lab11/powerblade/images/powerblade_front_799x800.jpg

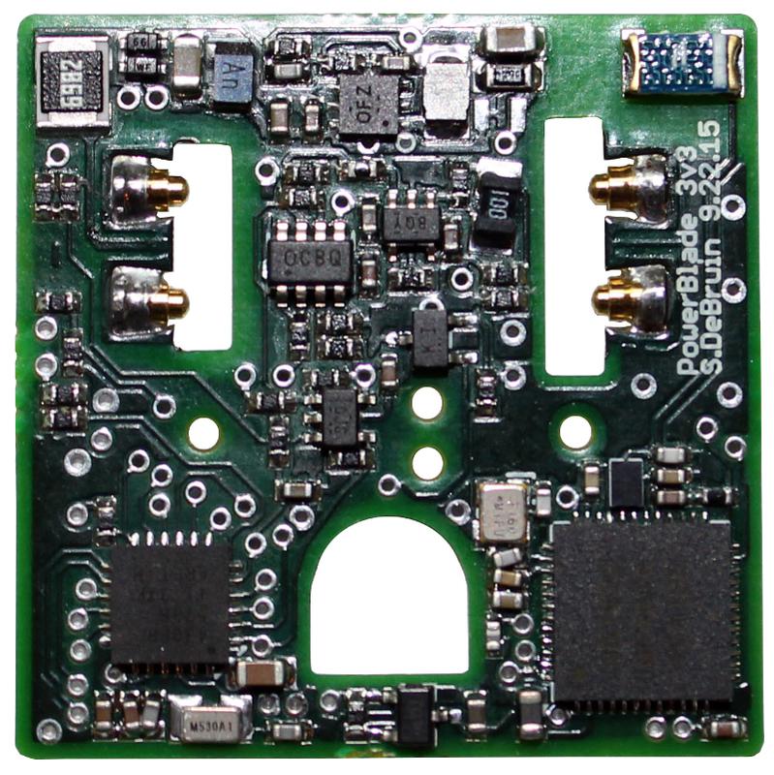
images/powerblade_front_799x800.jpg
