lab11/powerblade/images/powerblade.png

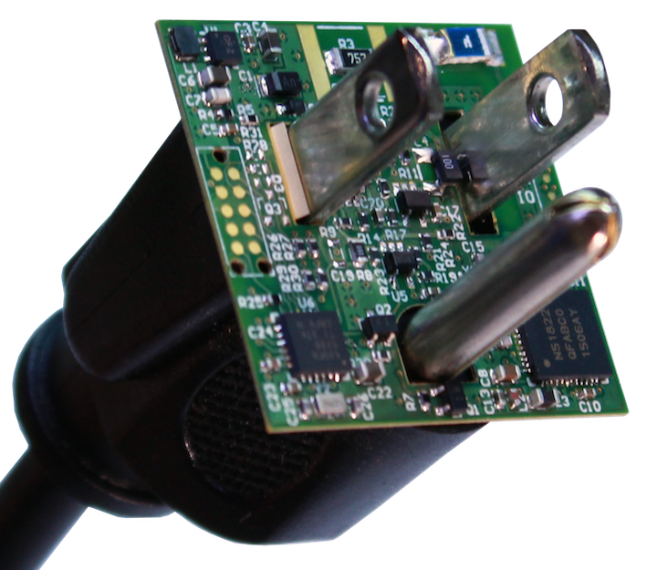
images/powerblade.png
