lab11/powerblade/software/ble/README.md

# BLE Data Gathering
Gathers data from a powerblade over advertisements

```
sudo node powerblade_data.js
```
