lab11/powerblade/software/gateway/push_to_gatd/README.md

Pulls data from a deployed GATD and pushes it to GATD

Requires a configuration script from shed:
    `ln -s shed/projects/powerblade/<deployment name>/config.js .`
