lab11/powerblade/software/android/PowerBlade/README.md

PowerBlade Android App
===================

Low profile true power metering.
View data broadcasted from PowerBlade power meters nearby.

 


Google Play (https://play.google.com/store/apps/details?id=edu.umich.eecs.lab11.powerblade)
