lab11/powerblade/software/nrf51822/apps/powerblade/README.md

PowerBlade BLE App
==================

Install
-------

    make flash ID=c0:98:e5:70:00:xx
