lab11/powerblade/docs/powerblade_specs/msp_versions.md

PowerBlade MSP430 Versions
==========================

In PowerBlade, the nRF51822 can query software version from the MSP430. This is seperate from the powerblade_id transmitted 
with each packet, which only increments if the over-the-wire protocol has changed. The MSP430 software version reflects the
particular state of the MSP430 code when it was installed on the node, and increments whenever a change has been made that 
affects functionality. Therefore incrementing powerblade_id (in response to a protocol change) will also cause a change in MSP430 
version, but a change in MSP430 version will not necessarily require a change in powerblade_id. 

For example, the MSP430 version could reflect whether the node is running a 8-bit or 10-bit analog to digital converter, or whether
the WDT (watchdog timer) is enabled. 

Finally, the minor version is used for identifying updates to the code that do not reprenent version updates, and is not 
transmitted in the advertisement nor sent when the nRF queries version number from the MSP430. Instead, the repo is tagged with
'PB_ID.Version.Minor version' and a corresponding hex file is saved in the [msp_images folder](https://github.com/lab11/powerblade/tree/master/software/msp_images). This feature was added during 2.2. 

## MSP Version List

| PB_ID 	| Version	| Minor Version 	| Notes		|
|:---|:---|:---|:---|
| Multiple 	| 0  		| 0					| This is the default, the first MSP430 code that responds to the version request will respond '1' |
| 2 		| 1			| 0 				| 10 bit ADC, watchdog timer enabled |
| 2 		| 2			| 0 				| Local calibration, SET SEQ (0x1C) and RST WH (0x1D) no longer valid |
| 2			| 2			| 1 				| Lowest four bits of flags now contains MSP Version |
| 2			| 3			| 0 				| Watt Hours now being stored in non-volatile |
