lab11/powerblade/docs/powerblade_specs/uart_protocol.md

PowerBlade UART Protocol
========================

UART is used for communication between the MSP430 and nRF51822 chips used on PowerBlade. The MSP430 controls power to subsystems, samples voltage and current waveforms, and sends power data to the nRF. The nRF controls BLE communication including advertisements and services. Control from users is sent from the nRF back to the MSP430.

## MSP to nRF Packet Specification

Packets are sent from the MSP430 to the nRF at 1 Hz. Each packet includes updated advertisement data, and may optionally include additional data, such as updates to BLE service values.

### Packet Format

| **Field** | Total Length | Adv Length | Adv Data | Additional Data (optional) | Checksum| 
|:---:|:---:|:-:|:---:|:---:|:---:|
| **Number of Bytes** | 2 | 1 | `Adv Length` | ... | 1 |
| **Byte Index** | 0-1 | 2 | 3-21+ | ... | Last Byte |

 * **Total Length**: Length of the entire UART transmission, including itself
 * **Adv Length**: Length of advertisement data field, does not include itself
 * **Adv Data**: Advertisement data. This can range from 0 to 24 bytes
 * **Additional Data**: Additional data to send to nRF. Structure defined below
 * **Checksum**: Checksum over entire packet, additive 1s complement checksum

More information on `Adv Data` format can be found in the [BLE Advertisement Protocol Specification](ble_advertisement.md). The checksum implmentation can be found in [checksum.c](https://github.com/lab11/powerblade/blob/master/software/common/source/checksum.c).

#### Example Packet

Example UART packet with advertisement data but no additional data. Advertisement fields are noted following the example from the [BLE Advertisement Protocol Specification](ble_advertisement.md).

| **Field** | Total Length | Adv Length |
|:---:|:---:|:---:|
| **Value** | 0x0017 | 0x13 |

| Version | Sequence | P_scale | V_scale | WH_scale | V_RMS | Real Power |
|:---:|:---:|:---:|:---:|:---:|:-----:|:---:|
| 0x01 | 0x00000001 | 0x424A  | 0x7B | 0x09 | 0x31  | 0x0802 |

| Apparent Power | Energy Use | Flags | Checksum |
|:---:|:---:|:-----:|:---:|
| 0x0A1A | 0x0000010D | 0x00  | 0x55 |

#### Additional Data

The additional data field can be used to transfer non-advertisement data to the nRF. This can include additional fine-grained power data or information on the device's current state. The total length of additional data can be up to 505 bytes.

| **Field** | Add Data Type | Add Data Values |
|:---:|:---:|:---:|
| **Number of Bytes** | 1 | `Add Data Length` |
| **Byte Index** | 0 | 1- |

 * **Add Data Type**: Type of data. Informs nRF how to interpret the data. See below
 * **Add Data Values**: Data elements. Length and interpretation depend on `Add Data Type`

Each additional data field has only a single `Add Data Type`. If the MSP430 has multiple items to be sent to the nRF, they should be sent in separate transmissions.

##### Additional Data Types

| Value | Name |
|:---|:-----|
| 0x20  | Sample Data Starting |
| 0x21  | Sample Data Values |
| 0x22	| Send Data Done |
| 0x23  | Local Calibration Starting |
| 0x24  | Local Calibration Ongoing |
| 0x25  | Local Calibration Done | 

 * **Sample Data Starting**: MSP430 is collecting raw samples
 * **Sample Data Values**: Data values are raw samples from MSP430
 * **Sample Data Done**: All raw samples have been collected
 * **Local Calibration Starting**: MSP430 is beginning local calibration
 * **Local Calibration Ongoing**: Local calibration is in process, has not failed or finished
 * **Local Calibration Done**: Calibration process is done/settled

## nRF to MSP Packet Specification

Packets are sent from the nRF to the MSP430 asynchronously based on interactions with the user over BLE, only one nRF to MSP430 packet may be sent per second. Packets include information such as changes to device state (e.g. enter calibration mode) or parameter changes to the device.

### Packet Format

| **Field** | Total Length | Data Type | Data Values | Checksum  | 
|:---:|:---:|:---:|:---:|:---:|
| **Number of Bytes** | 2 | 1 | `Data Length` | 1 |
| **Byte Index** | 0-1 | 2 | 3- | Last Byte |

 * **Total Length**: Length of packet, including itself
 * **Data Type**: Type of data. Informs MSP430 how to interpret the data. See below
 * **Data Values**: Data elements. Length and interpretation depend on `Data Type`
 * **Checksum**: Checksum over entire packet, additive 1s complement checksum

Each packet has only a single `Data Type`. If the nRF has multiple items to be sent to the MSP430, they should be sent in separate transmissions.

##### Additional Data Types

| Value | Name |
|:---|:-----|
| 0x10  | Get Configuration |
| 0x11  | Set Configuration |
| 0x12	| Get software version |
| 0x1C	| Set Sequence DEPRECATED |
| 0x1D	| Set WH to zero (reset accumulator) DEPRECATED |
| 0x20  | Start Sample Data Download |
| 0x21	| Continue Sample Data Download |
| 0x22  | Stop Sample Data Download |
| 0x23  | Start Local Calibration |
| 0x24  | Continue Local Calibration |
| 0x25  | Stop Local Calibration | 
| 0xFF	| NAK (Checksum failed) |

 * **Get Configuration**: Get the current values of PowerBlade configuration values: Voff, Ioff, PScale, VScale, and WHScale
 * **Set Configuration**: Set the current values of PowerBlade configuration values: Voff, Ioff, PScale, VScale, and WHScale
 * **Get software version**: Get the version of the software running on the MSP430. Response payload will be a single byte
 * **Set Sequence**: As of MSP v2 this command is no longer valid, MSP430 will respond NAK (0xFF)
 * **Set WH to zero**: As of MSP v2 this command is no longer valid, MSP430 will respond NAK (0xFF) 
 * **Start Sample Data Download**: Get individual samples from one second of power sampling
 * **Continue Sample Data Download**: Get next set of raw samples from MSP430
 * **Stop Sample Data Download**: Stop collecting and transmitting raw samples
 * **Start Local Calibration**: Start local calibration procedure at known wattage, voltage. These values are transmitted after the type (0x23) as two 16-bit numbers representing 10x the intended value (see example below). 
 * **Continue Local Calibration**: Calibration load still active, "Done" (0x25) not yet received
 * **Stop Local Calibration**: Cancel local calibration process. Old calibration values are maintained. 
 * **NAK**: nRF indicating checksum of previous message failed

#### Example Packet

Example UART packet with a `Start Local Calibration` type, a wattage value of 200.1 W, and voltage of 118.8 V. 

| **Field** | Total Length | Data Type | Wattage | Voltage | Checksum |
|:---:|:---:|:---:|:---:|:---:|:---:|
| **Value** | 0x0008 | 0x23 | 0x07D1  | 0x04A4  | ??? |
