lab11/powerblade/sql/plot/random/loc0_light.pdf

0

200

400

600

800

1000 1017165155416848
Average Daily
Energy (Wh)
BLEES/Ligeiro
PowerBlade

1

10

100

1000

Dining Room

Remote charger

Bathroom night light
Monitor

Bedroom standing lamp
Other Closet

Bedroom bedside lamp
Bedroom TV

Bedroom iPhone charger
Monitor

Speakers

Curling Iron
NUC

Master Closet

Curling Iron #2
Microwave

Master android charger

Master bedroom ethernet switch
Energy bridge

Bedroom 2 ethernet switch
Desk lamp

Bedroom 2 gateway
Master Bathroom
Apple TV

USB hub
Toaster

Bedroom 2 bedside
Living room dell
Master gateway

Living room laptop charger

Living room macbook charger
Couch surge strip

Living room gateway
Living room lamp #1

Living room lamp #2

Master bedroom vacuum charger Bedside lamp
Keurig

Laptop dock

Dining Room

Shredder

Macbook charger

Living room ethernet switch Bedroom 2 UPS
Front Stairs
Kitchen

Other Bathroom
Fridge

Bedroom box fan
AT Modem

Bedroom 2 lamp

Ethernet bridge
Xbox One

Aero Garden
Samsung TV
Printer

AT Cable Box

Amp Speakers

Average Active
Power (w)
