lab11/powerblade/sql/plot/random/loc0.pdf

0

200

400

600

800

1000 1040 1770 5940 6020
Average Daily
Energy (Wh)
PowerBlade

1

10

100

1000

Remote charger

Bathroom night light
Monitor

Food processor

Bedroom bedside lamp
Monitor

Bedroom TV

Bedroom iPhone charger
Speakers

Bedroom standing lamp
Curling Iron #2

Master android charger
Microwave

Curling Iron
Toaster

Master bedroom ethernet switch Energy bridge
Apple TV

Desk lamp

Bedroom 2 ethernet switch
Bedroom 2 gateway

Couch surge strip

Living room macbook charger
NUC

Bedroom 2 bedside
USB hub

Living room laptop charger
Master gateway

Living room dell

Living room gateway
Living room lamp #1

Living room lamp #2
Keurig

Master bedroom vacuum charger Bedside lamp
Laptop dock

Shredder

Macbook charger
Bedroom box fan

Living room ethernet switch Bedroom 2 UPS
Fridge

Xbox One
AT Modem

Bedroom 2 lamp

Ethernet bridge
Samsung TV

Aero Garden
Printer

AT Cable Box

Amp Speakers

Average Active
Power (w)
