lab11/powerblade/sql/plot/random/loc3.pdf

0

200

400

600

800

1000 1523
Average Daily
Energy (Wh)
PowerBlade

1

10

100

1000

Shaver

Bedroom Lamp
Gold Lamp

Speaker Charger

Bedroom Phone Charger
Wiimote Charger
Toaster

Audio Conversion Cable
Chromecast
Nintendo Wii

Microwave

Swarm Gateway
Speakers

Macbook Charger
Modem

Television

Rice Cooker
Router
Tall Lamp
Fridge

Average Active
Power (w)
