lab11/powerblade/sql/plot/random/loc5.pdf

0

200

400

600

800

1000 1501
Average Daily
Energy (Wh)
PowerBlade

1

10

100

1000

Disposal

Apple TV

Blu Ray Player
Lamp

Desk lamp
Swash

Long board charger
Piano

Toaster

KitchenAid Mixer
Straightener

Bendes phone charger
Vacuum charger
Hair Dryer
Subwoofer

Alexa (dot downstairs)
Remote Control
Printer

Couch Outlet

Alexa (dot)

Alexa (main)
Sonos
Stove

Bendes computer charger
DAC

Ultrasonic humidifier
Microwave
Turn Table
Modem

Air Filter
Receiver

Surge (swash modem 2 phone chargers) Router and other stuff
Box fan
Fridge

Average Active
Power (w)
