lab11/powerblade/sql/plot/random/loc5_20.pdf

0

200

400

600

800

1000 | 1034 | 1484
Average Daily
Energy (Wh)
PowerBlade

1

10

100

1000

Disposal

Desk lamp
Swash
Lamp

Apple TV

Long board charger
Blu Ray Player
Piano

KitchenAid Mixer
Straightener

Hair Dryer
Toaster

Subwoofer

Vacuum charger

Bendes phone charger

Alexa (dot downstairs)
Couch Outlet
Stove

Printer

Alexa (dot)

Alexa (main)

Bendes computer charger
Remote Control
Sonos

Ultrasonic humidifier
Air Filter
Microwave
Modem

DAC

Turn Table

Surge (swash modem 2 phone chargers) Router and other stuff
Box fan

Receiver
Fridge

Average Active
Power (w)
