lab11/powerblade/sql/plot/random/loc6.pdf

0

200

400

600

800

1000 | 1281 | 6976
Average Daily
Energy (Wh)
PowerBlade

1

10

100

1000

Kegerator
KitchenAid
Apple TV

Adrienne’s bedside lamp

Adrienne’s phone charger
Tom’s bedside lamp

DVD Player

Living room lamp 2

Hair straightener
Curning iron
Diffuser

Living room lamp 1

Cell phone charger
Echo dot

Clothes Washer
Microwave
Toaster

Big Blue Speaker
Dishwasher
Tom’s laptop
Vacuum
Box fan
Wii

Keurig
Stove

Tom’s phone charger
Television

Router Modem

Misc Kitchen (incl toaster)
Alarm clock
Comcast box

Adrienne’s Computer
Fridge

Porch lights

Average Active
Power (w)
