lab11/powerblade/sql/plot/random/loc7.pdf

0

200

400

600

800

1000 1026
Average Daily
Energy (Wh)
PowerBlade

1

10

100

1000

Disposal

Standing lamp

Living room table lamp
Desk lamp

Living Room Wii U
Curler
Blender

Living room standing lamp
Sony DVD player
Bedroom 2 LEDs
Hair dryer
Bedside lamp

Kitchen clock
VCR
Wii

Reading light
Gateway
Toaster

Office surge

Bedroom office
Modem

Garage door opener
Electric blanket
Washer in office
Router
Stereo

Microwave
Fridge

Television

Average Active
Power (w)
