lab11/powerblade/sql/plot/random/loc1.pdf

0

200

400

600

800

1000 1077 1200 1606 1675
Energy Use (Wh)
PowerBlade

1

10

100

1000

Quiet Rm Desk #1 left power

Quiet Rm Desk #2 right power
Workroom Bench lights

Basement Downstairs Ethernet switch Quiet Rm Desk #1 monitor
Quiet Rm Desk #1 desk

Quiet Rm Desk #1 right power
Quiet Rm Desk #2 desk

Quiet Rm Desk #2 monitor
Floating

Quiet Rm Ethernet switch
Basement SD tower
Kitchen Toaster oven
Basement Router

Conference room Air purifier
Floating

Basement Sec. system monitor
Basement Gateway

Basement Tech server monitor
Workroom Sterilizer

Hallway Lobby chromecast
Hallway Desk #4 other
Hallway Lobby speaker

Hallway Router gateway

Collab Rm Table strip south
Kitchen Microwave

Collab Rm Table Strip North

Basement Upstairs Ethernet switch
Conference room Surge strip #1
Collab Rm Television

Basement Western Digital Tower Basement POE module
Collab Rm Cable box

Hallway Big router

Hallway Lobby television
Basement Comcast modem

Conference room Floor strip
Basement Security system
Basement 3D printer #1
Kitchen Fridge

Basement Mysterious grey box
Basement Tech server

Hallway Drink machine

Average Power (w)
