lab11/powerblade/docs/plug_designs/BS1363PlugSpec.png

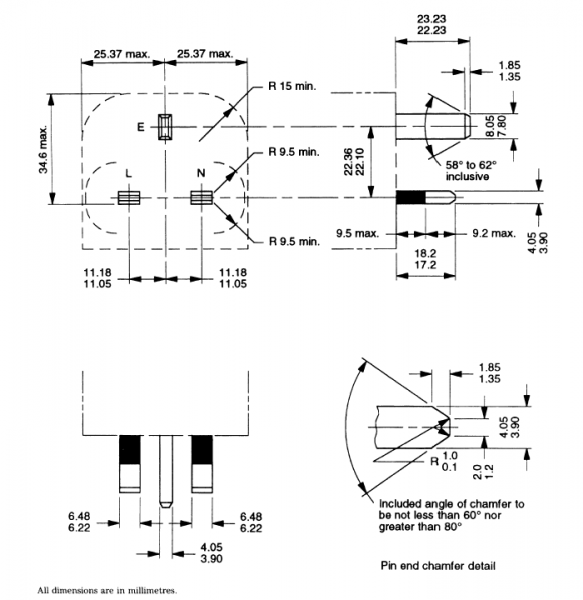
docs/plug_designs/BS1363PlugSpec.png
