lab11/powerblade/images/high_side_supply.PNG

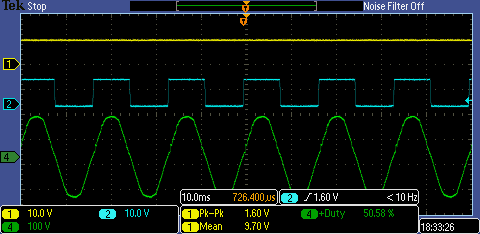
images/high_side_supply.PNG
