lab11/powerblade/images/powerblade_isometric_v5_1000x720.jpg

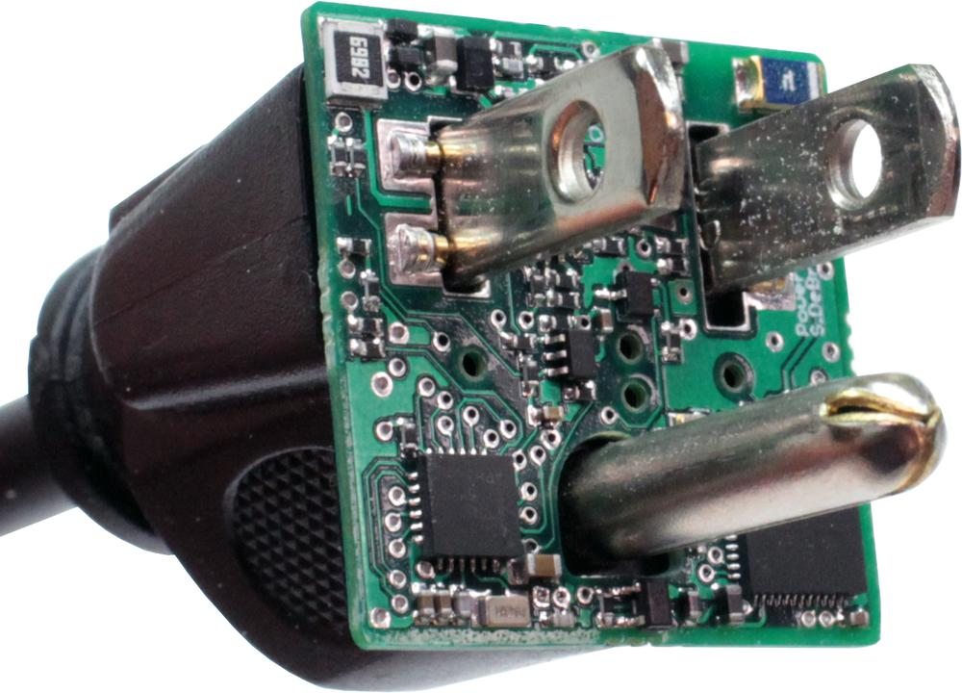
images/powerblade_isometric_v5_1000x720.jpg
