lab11/powerblade/images/powerblade_plug_profile_1000x423.jpg

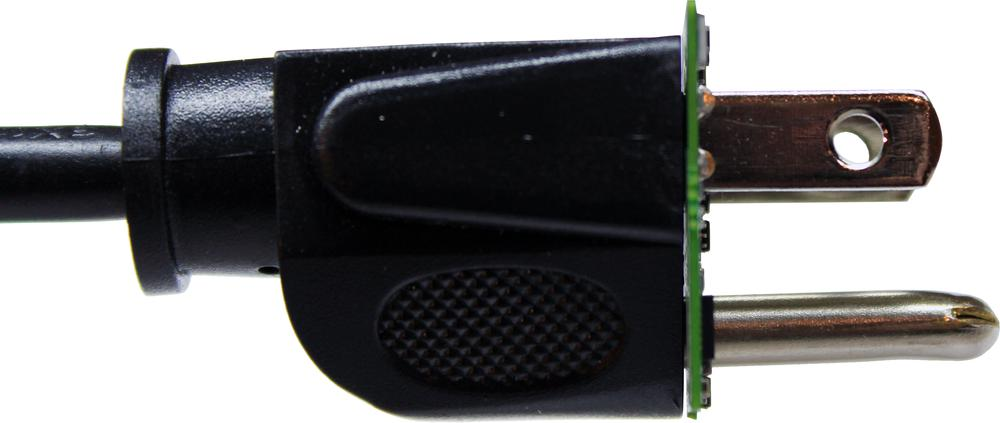
images/powerblade_plug_profile_1000x423.jpg
