lab11/powerblade/images/powerblade_plug_profile_slim_937x1000.jpg

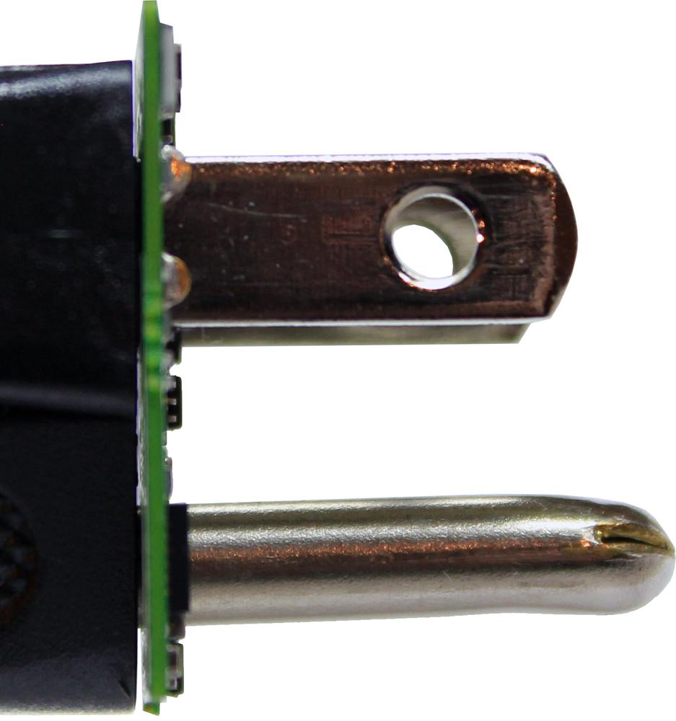
images/powerblade_plug_profile_slim_937x1000.jpg
