lab11/powerblade/other/cad/full_system.PNG

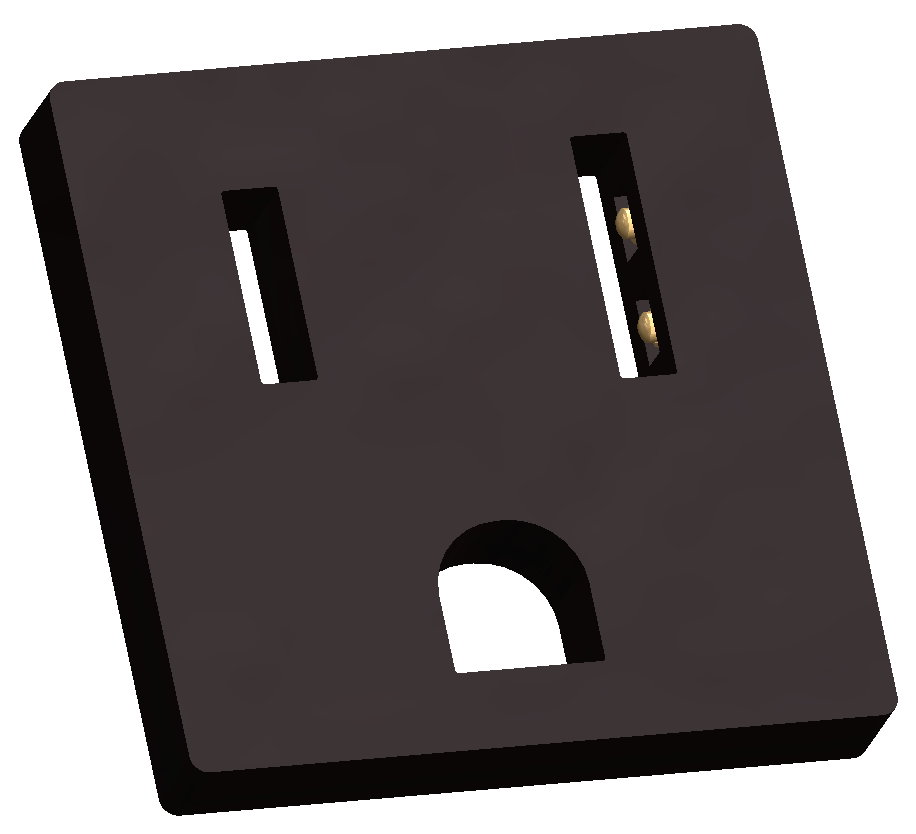
other/cad/full_system.PNG
