lab11/powerblade/eagle/powerblade/powerblade_3v5_bom.xlsx

Qty | 300
Item | Quantity | Part | Value | Device | Package | Description | Distributor | Dist Part # | Type | Alternate
1 | 1 | B1 | BAL-NRF01D3 | BAL-NRF01D3 | BAL-NRF01D3 | 50 ohm nominal input / conjugate match balun to nRF51422-QFAA, | 300 | 497-13637-1-ND | BGA | 497-13637-1-ND
2 | 1 | C1 | 33uF | CPOL-US0805_SM | CPOL0805_SM | POLARIZED CAPACITOR, American symbol | 300 | 478-8650-1-ND | smt | 478-8650-1-ND
3 | 1 | C11 | 4.7uF | C-EUC0402 | C0402 | CAPACITOR, European symbol | 300 | 445-5947-1-ND | smt | 445-5947-1-ND
4 | 2 | C12, C20 | 1nF | CAPACITOR | 0402_CAP | 0402 Capacitor | 600 | 490-1303-1-ND | smt | 490-1303-1-ND
5 | 1 | C15 | 10uF | C-EUC0603_SM | C0603_SM | CAPACITOR, European symbol | 300 | 445-6853-1-ND | smt | 445-6853-1-ND
6 | 1 | C16 | 470nF | C-EUC0402 | C0402 | CAPACITOR, European symbol | 300 | 445-4989-1-ND | smt | 445-13864-1-ND
7 | 1 | C17 | 1uF | CAPACITOR | 0402_CAP | 0402 Capacitor | 300 | 1276-1513-1-ND | smt | 1276-1513-1-ND
8 | 2 | C18, C19 | 12pF | CAPACITOR | 0402_CAP | 0402 Capacitor | 600 | 490-6197-1-ND | smt | 490-6196-1-ND
9 | 1 | C2 | 0.1uF | C-EUC0402 | C0402 | CAPACITOR, European symbol | 300 | 490-10777-1-ND | smt | 490-10777-1-ND
10 | 1 | C21 | 47nF | CAPACITOR | 0402_CAP | 0402 Capacitor | 300 | 445-1264-1-ND | smt | 445-1264-1-ND
11 | 1 | C22 | 2.2nF | CAPACITOR | 0402_CAP | 0402 Capacitor | 300 | 490-5419-1-ND | smt | 490-5419-1-ND
12 | 1 | C23 | 0.8pF | CAPACITOR | 0402_CAP | 0402 Capacitor | 300 | 490-6269-1-ND | smt | 490-6269-1-ND
13 | 2 | C3, C10 | 22uF | C-EUC0603_SM | C0603_SM | CAPACITOR, European symbol | 600 | 445-9077-1-ND | smt | 445-9077-1-ND
14 | 1 | C39 | 1.5uF | C-EUC0402 | C0402 | CAPACITOR, European symbol | 300 | 445-13815-1-ND | smt | 445-13815-1-ND
15 | 1 | C4 | 22pF | C-EUC0402 | C0402 | CAPACITOR, European symbol | 300 | 445-1239-1-ND | smt | 445-1239-1-ND
16 | 1 | C5 | NP | C-EUC0603_TN | C0603_TN | CAPACITOR, European symbol | 300 | NP | DNS | NP
17 | 2 | C6, C34 | 8pF | C-EUC0402 | C0402 | CAPACITOR, European symbol | 600 | 445-4890-1-ND | smt | 445-4890-1-ND
18 | 1 | C7 | 4.7uF | C-EUC0402 | C0402 | CAPACITOR, European symbol | 300 | 445-8023-1-ND | smt | 445-13820-1-ND
19 | 7 | C8, C9, C13, C14, C24, C27, C38 | 0.1uF | C-EUC0402 | C0402 | CAPACITOR, European symbol | 2100 | 445-4952-1-ND | smt | 445-4952-1-ND
20 | 1 | D1 | ZENERBZT52 | ZENERBZT52 | BZT52 |  | 300 | BZT52C10T-7DICT-ND | smt | BZT52C10T-7DICT-ND
21 | 1 | D2 | DIODE | DIODE | BAS521 |  | 300 | BAS521-7DICT-ND | smt | BAS521-7DICT-ND
22 | 1 | J1 | JTAG_14PIN_IDC-ND | JTAG_14PIN_IDC-ND | TC2050-IDC-NL-430-ND |  | 300 | NP | DNS | NP
23 | 1 | J4 | TC2030-JLINK-NL | TC2030-JLINK-NL | TC2030-IDC-NL |  | 300 | NP | DNS | NP
24 | 1 | L1 | 10uH | L-USL0805 | L0805 | INDUCTOR, American symbol | 300 | 490-4990-1-ND | smt | 490-4990-1-ND
25 | 1 | L2 | 15nH | INDUCTOR0402 | 0402_CAP |  | 300 | 587-1521-1-ND | smt | 587-1521-1-ND
26 | 1 | L3 |  | L-USL0805 | L0805 | INDUCTOR, American symbol | 300 | 732-3452-1-ND | smt | 732-3452-1-ND
27 | 1 | L4 | 10uH | L-USL0603_TN | C0603_TN | INDUCTOR, American symbol | 300 | 490-4025-1-ND | smt | 535-12249-1-ND
28 | 1 | Q1 | NTS4173 | NTS4173 | SC-70-3 |  | 300 | NTS4173PT1GOSCT-ND | smt | NTS4173PT1GOSCT-ND
29 | 1 | Q4 | 2SK1829 | 2SK1829 | SC-70-3 |  | 300 | 2SK1829TE85LFCT-ND | smt | 2SK1829TE85LFCT-ND
30 | 2 | R12, R13 | 330k | R-US_R0402 | R0402 | RESISTOR, American symbol | 600 | P330KLCT-ND | smt | P330KLCT-ND
31 | 1 | R14 | 200 | R-US_R0402 | R0402 | RESISTOR, American symbol | 300 | P200LCT-ND | smt | P200LCT-ND
32 | 4 | R15, R20, R21, R40 | 1M 1% | R-US_R0402 | R0402 | RESISTOR, American symbol | 1200 | P1.00MLCT-ND | smt | P1.00MLCT-ND
33 | 1 | R16 | 75 1% | R-US_R0402 | R0402 | RESISTOR, American symbol | 300 | P75.0LCT-ND | smt | P75.0LCT-ND
34 | 1 | R17 | 1k 1% | R-US_R0402 | R0402 | RESISTOR, American symbol | 300 | P1.00KLCT-ND | smt | P1.00KLCT-ND
35 | 1 | R18 | 4.99 1% | R-US_R0402 | R0402 | RESISTOR, American symbol | 300 | RMCF0402FT4R99CT-ND | smt | RMCF0402FT4R99CT-ND
36 | 1 | R19 | 47k | R-US_R0402 | R0402 | RESISTOR, American symbol | 300 | P47KJCT-ND | smt | P47KJCT-ND
37 | 1 | R2 | 3k | R-US_R0402_SM | R0402_SM | RESISTOR, American symbol | 300 | P3.00KLCT-ND | smt | P3.00KLCT-ND
38 | 1 | R24 | 1 1% | R-US_R0603_SM | R0603_SM | RESISTOR, American symbol | 300 | P1.0AJCT-ND | smt | P1.0AJCT-ND
39 | 1 | R3 | 69.8k | R-US_R1210 | R1210 | RESISTOR, American symbol | 300 | P69.8KAACT-ND | smt | P69.8KAACT-ND
40 | 1 | R35 | 20k | R-US_R0402 | R0402 | RESISTOR, American symbol | 300 | P20.0KLCT-ND | smt | P20.0KLCT-ND
41 | 1 | R37 | 887k 1% | R-US_R0402 | R0402 | RESISTOR, American symbol | 300 | P887KLCT-ND | smt | P887KLCT-ND
42 | 1 | R38 | 30k 1% | R-US_R0402 | R0402 | RESISTOR, American symbol | 300 | P30.0KLCT-ND | smt | P30.0KLCT-ND
43 | 1 | R39 | 16k 1% | R-US_R0402 | R0402 | RESISTOR, American symbol | 300 | P16.0KLCT-ND | smt | P16.0KLCT-ND
44 | 1 | R4 | 12k | RESISTOR | 0402_RES | Resistor | 300 | RHM12.0KCDCT-ND | smt | RHM12.0KCDCT-ND
45 | 3 | R6, R11, R22 | 665k | R-US_R0402 | R0402 | RESISTOR, American symbol | 900 | P665KLCT-ND | smt | P665KLCT-ND
46 | 1 | R7 | 560k | R-US_R0402 | R0402 | RESISTOR, American symbol | 300 | P560KLCT-ND | smt | P560KLCT-ND
47 | 1 | R8 | 220k | R-US_R0402_SM | R0402_SM | RESISTOR, American symbol | 300 | P220KJCT-ND | smt | P220KJCT-ND
48 | 1 | R9 | 180k | R-US_R0402 | R0402 | RESISTOR, American symbol | 300 | P180KLCT-ND | smt | P180KLCT-ND
49 | 1 | RF | 4.99k 1% | R-US_R0402 | R0402 | RESISTOR, American symbol | 300 | P4.99KLCT-ND | smt | P4.99KLCT-ND
50 | 2 | RI1, RI2 | 953k 1% | R-US_R0402 | R0402 | RESISTOR, American symbol | 600 | P953KLCT-ND | smt | P953KLCT-ND
51 | 1 | U1 | TPS62122 | TPS62122 | WDFN-6 |  | 300 | 296-27695-1-ND | fine pitch | 296-27695-1-ND
52 | 1 | U2 | OPA333 | OPA333 | SC70-5 |  | 300 | 296-19547-1-ND | smt | 296-19547-1-ND
53 | 1 | U3 | MSP430FR5738 | MSP430FR5738 | VQFN-24 |  | 300 | 296-29232-1-ND | fine pitch | 296-29232-1-ND
54 | 1 | U4 | NRF51822QF | NRF51822QF | QFN-48-6MM | Multiprotocol Bluetooth® 4.0 low energy/2.4 GHz RF SoC | 300 | 1490-1032-1-ND | fine pitch | 1490-1032-1-ND
55 | 1 | U6 | MAX9910 | MAX9910 | SC70-5 |  | 300 | 296-25252-1-ND | smt | 296-25252-1-ND
56 | 1 | U7 | OPA2369 | OPA2369 | SOT-23-8 |  | 300 | 296-22671-1-ND | smt | 296-22671-1-ND
57 | 1 | X1 | 16MHz | TXC-8Y | TXC-8Y | 2mmx1.6mm SMD Crystal | 300 | 887-2003-1-ND | smt | 887-2003-1-ND
58 | 1 | X3 | 32.768kHz | CRYSTAL_0805 | 805 |  | 300 | 535-12373-1-ND | smt | 535-12373-1-ND
59 | 1 | Y1 | UREACH_XTEND | UREACH_XTEND | UREACH_XTEND |  | 300 | FR05-S1-N-0-110 | smt | FR05-S1-N-0-110
60 | 4 | J2 | Ultra Low Profile Spring Pin | Ultra Low Profile Spring Pin | Ultra Low Profile Spring Pin |  | 1200 | ED1649-ND | smt | ED1649-ND
 |  |  |  |  |  |  | Board Summary for Quote
 |  |  |  |  |  |  | Total Unique Parts | 56
 |  |  |  |  |  |  | SMT placements per board | 69
 |  |  |  |  |  |  | Thru-hole per board | 0
 |  |  |  |  |  |  | Fine pitch per board | 3
 |  |  |  |  |  |  | BGA per board | 1
