lab11/powerblade/eagle/powerblade/past_rev/3v1/SC-BOM.xlsx

PowerBlade Bill of Materials (BOM)
> All the information Screaming Circuits needs in a Bill of Materials to complete an order is in columns B through G.
> Distributor part numbers (ie.. DigiKey Part #'s) are not required for Kitted orders, but are helpful for Turn-Key pricing.
> The BOM is the primary file that Screaming Circuits goes by whenever there is any conflicting information.
> There is information in the far right column that helps to get an assembly quote. Look at the bottom to see a board summary.
> Highlight in RED any Do Not Stuff parts ("DNS") , and they will be excluded from the build. Parts not listed on the BOM are considered DNS.
Item # | Qty | Ref Des | Manufacturer | Mfg Part # | Dist. Part # | Description | Package | Type
1 | 1 | B1 |  |  | 497-13637-1-ND |  |  | bga
2 | 1 | C1 |  |  | 478-8650-1-ND |  |  | smt
4 | 2 | C3, C10 |  |  | 445-9077-1-ND |  |  | smt
5 | 1 | C5 |  |  | 445-9077-1-ND |  |  | DNS
6 | 1 | C4 |  |  | 445-1239-1-ND |  |  | smt
7 | 2 | C6, C34 |  |  | 445-4890-1-ND |  |  | smt
8 | 1 | C7 |  |  | 445-8023-1-ND |  |  | smt
9 | 7 | C8, C9, C13, C14, C24, C27, C38 |  |  | 445-4952-1-ND |  |  | smt
10 | 1 | C11 |  |  | 445-5947-1-ND |  |  | smt
11 | 2 | C12, C20 |  |  | 490-1303-1-ND |  |  | smt
12 | 1 | C15 |  |  | 445-6853-1-ND |  |  | smt
13 | 1 | C16 |  |  | 445-4989-1-ND |  |  | smt
14 | 1 | C17 |  |  | 1276-1513-1-ND |  |  | smt
15 | 2 | C18, C19 |  |  | 490-6197-1-ND |  |  | smt
16 | 1 | C21 |  |  | 445-1264-1-ND |  |  | smt
17 | 1 | C22 |  |  | 490-5419-1-ND |  |  | smt
18 | 1 | C23 |  |  | 490-6269-1-ND |  |  | smt
19 | 1 | C39 |  |  | 445-13815-1-ND |  |  | smt
20 | 1 | D1 |  |  | BZT52C10T-7DICT-ND |  |  | smt
21 | 1 | D2 |  |  | BAS521-7DICT-ND |  |  | smt
22 | 1 | L1 |  |  | 490-4990-1-ND |  |  | smt
23 | 1 | L2 |  |  | 587-1521-1-ND |  |  | smt
24 | 1 | L3 |  |  | 732-3452-1-ND |  |  | smt
25 | 1 | L4 |  |  | 490-4025-1-ND |  |  | smt
26 | 1 | Q1 |  |  | NTS4173PT1GOSCT-ND |  |  | smt
27 | 1 | Q4 |  |  | 2SK1829TE85LFCT-ND |  |  | smt
28 | 1 | R1 |  |  | P0.0JCT-ND |  |  | smt
30 | 1 | R3 |  |  | P69.8KAACT-ND |  |  | smt
32 | 1 | R4 |  |  | RHM12.0KCDCT-ND |  |  | smt
33 | 3 | R6, R11, R22 |  |  | P665KLCT-ND |  |  | smt
34 | 1 | R7 |  |  | P560KLCT-ND |  |  | smt
35 | 1 | R8 |  |  | P220KJCT-ND |  |  | smt
36 | 1 | R9 |  |  | P180KLCT-ND |  |  | smt
37 | 2 | R12, R13 |  |  | P330KLCT-ND |  |  | smt
38 | 1 | R14 |  |  | P200LCT-ND |  |  | smt
39 | 4 | R15, R20, R21, R40 |  |  | P1.00MLCT-ND |  |  | smt
40 | 1 | R16 |  |  | P75.0LCT-ND |  |  | smt
41 | 2 | R17, RF |  |  | P4.99KLCT-ND |  |  | smt
43 | 1 | R18 |  |  | RMCF0402FT4R99CT-ND |  |  | smt
45 | 1 | R19 |  |  | P47KJCT-ND |  |  | smt
46 | 1 | R24 |  |  | P1.0AJCT-ND |  |  | smt
48 | 1 | R35 |  |  | P20.0KLCT-ND |  |  | smt
49 | 1 | R37 |  |  | P887KLCT-ND |  |  | smt
50 | 1 | R38 |  |  | P30.0KLCT-ND |  |  | smt
51 | 1 | R39 |  |  | P16.0KLCT-ND |  |  | smt
52 | 2 | RI1, RI2 |  |  | P953KLCT-ND |  |  | smt
53 | 1 | SV1 |  |  | S9014E-12-ND |  |  | DNS
54 | 1 | U1 |  |  | 296-27695-1-ND |  |  | smt
56 | 1 | U2 |  |  | 296-19547-1-ND |  |  | smt
57 | 1 | U3 |  |  | 296-29232-1-ND |  |  | fine pitch
58 | 1 | U4 |  |  | 1490-1032-1-ND |  |  | fine pitch
59 | 1 | U6 |  |  | MAX9910EXK+TCT-ND |  |  | smt
60 | 1 | U7 |  |  | 296-22671-1-ND |  |  | smt
61 | 1 | X1 |  |  | 887-2003-1-ND |  |  | smt
62 | 1 | X3 |  |  | 535-12373-1-ND |  |  | smt
63 | 1 | Y1 |  |  | FR05-S1-N-0-110 |  |  | smt
 |  |  |  |  |  | BOARD SUMMARY FOR QUOTE
 |  |  |  |  |  | Total # of unique parts | 60
 |  |  |  |  |  | SMT placements per board | 69
 |  |  |  |  |  | Thru-hole placements per board | 0
 |  |  |  |  |  | Fine pitch placements per board | 3
 |  |  |  |  |  | BGA placements per board | 0
