lab11/powerblade/eagle/powerblade/past_rev/3v1/partList.xlsx

Sheet: DIGIKEY
Name | Part Num | Face | Qty | Qty Needed | Qty Avail | 1 | 10 | 25 | 50 | 100 | 250 | 500 | 750 | 1000 | 2500 | Qty to Buy
B1 | 497-13637-1-ND | eagle/powerblade/powerblade_3v1 | 1 | 12 | 98086 | 0.80000 | 0.61900 |  |  | 0.40000 |  |  |  | 0.32000 |  | 12
C1 | 478-8650-1-ND | eagle/powerblade/powerblade_3v1 | 1 | 12 | 9607 | 1.16000 | 0.97000 |  |  | 0.61890 | 0.51576 | 0.46418 |  | 0.42292 |  | 12
C1 | 478-8654-1-ND | eagle/powerblade/powerblade_3v1 | 1 | 12 | 13945 | 1.16000 | 0.97000 |  |  | 0.61890 | 0.51576 | 0.46418 |  | 0.42292 |  | 12
C3, C5, C10 | 445-9077-1-ND | eagle/powerblade/powerblade_3v1 | 3 | 36 | 218179 | 0.50000 | 0.47800 |  |  | 0.23210 | 0.19280 | 0.17494 |  | 0.15750 |  | 36
C4 | 445-1239-1-ND | eagle/powerblade/powerblade_3v1 | 1 | 12 | 203352 | 0.10000 | 0.02400 |  |  | 0.01100 | 0.00900 | 0.00770 |  | 0.00600 |  | 12
C6, C34 | 445-4890-1-ND | eagle/powerblade/powerblade_3v1 | 2 | 24 | 211893 | 0.10000 | 0.02600 |  |  | 0.01210 | 0.00992 | 0.00848 |  | 0.00660 |  | 24
C7 | 445-8023-1-ND | eagle/powerblade/powerblade_3v1 | 1 | 12 | 209639 | 0.41000 | 0.35700 |  |  | 0.17850 | 0.14280 | 0.13006 |  | 0.11500 |  | 12
C8, C9, C13, C14, C24, C27, C38 | 445-4952-1-ND | eagle/powerblade/powerblade_3v1 | 7 | 84 | 3379993 | 0.10000 | 0.02700 |  |  | 0.01230 | 0.01008 | 0.00864 |  | 0.00660 |  | 100 | BACKORDER
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
U2 | 296-19547-1-ND | eagle/powerblade/powerblade_3v1 | 1 | 12 | 11546 | 2.73000 | 2.46000 | 2.13000 | 2.00000 | 1.98000 | 1.76000 | 1.49000 | 1.35000 | 1.06875 |  | 12
U3 | 296-29232-1-ND | eagle/powerblade/powerblade_3v1 | 1 | 12 | 2774 | 3.94000 | 3.52900 | 3.17360 |  | 2.88650 | 2.61288 | 2.33928 | 2.12040 | 1.71000 |  | 12
U4 | 1490-1032-1-ND | eagle/powerblade/powerblade_3v1 | 1 | 12 | 7644 | 4.15000 | 3.73600 | 3.39000 |  | 3.04410 | 2.76740 | 2.42148 |  |  |  | 12
U6 | 296-25252-1-ND | eagle/powerblade/powerblade_3v1 | 1 | 12 | 7385 | 1.87000 | 1.68000 | 1.46000 | 1.37000 | 1.35000 | 1.20000 | 1.02000 | 0.92400 | 0.73125 |  | 12
U7 | 296-22671-1-ND | eagle/powerblade/powerblade_3v1 | 1 | 12 | 797 | 3.02000 | 2.72000 | 2.36000 | 2.22000 | 2.19000 |  |  |  |  |  | 12
X1 | 887-2003-1-ND | eagle/powerblade/powerblade_3v1 | 1 | 12 | 8677 | 1.18000 | 1.13000 |  | 1.10500 | 0.94500 |  | 0.92000 |  | 0.77500 |  | 12
X3 | 535-12373-1-ND | eagle/powerblade/powerblade_3v1 | 1 | 12 | 23253 | 1.10000 | 0.97300 |  | 0.90860 | 0.80400 |  | 0.75978 | 0.71959 | 0.63516 |  | 12

Sheet: FRACTUS
Name | Part Num | Face | Qty | Qty Needed | Qty Avail | Qty to Buy
Y1 | FR05-S1-N-0-110 | eagle/powerblade/powerblade_3v1 | 1 | 12 | 0 | 0

Sheet: MOUSER
Name | Part Num | Face | Qty | Qty Needed | Qty Avail | Qty to Buy
B1 | 511-BAL-NRF01D3 | eagle/powerblade/powerblade_3v1 | 1 | 12 | 0 | 0
U4 | 949-NRF51822-QFAB-R7 | eagle/powerblade/powerblade_3v1 | 1 | 12 | 0 | 0
