lab11/powerblade/eagle/powerblade/past_rev/3v0/partList.xlsx

Sheet: DIGIKEY
Name | Part Num | Face | Qty | Qty Needed | Qty Avail | 1 | 10 | 25 | 50 | 100 | 200 | 250 | 500 | 750 | 1000 | 2500 | Qty to Buy
C1 | 490-5919-1-ND | powerblade_test | 1 | 5 | 6771 | 2.86000 | 2.36800 |  | 2.19360 | 1.98470 |  | 1.63656 |  |  |  |  | 5 | 490-5919-1-ND
C3, C32 | 718-1672-1-ND | powerblade_test | 2 | 10 | 14717 | 2.15000 | 1.78500 |  |  | 1.57500 |  | 1.47000 | 1.31250 |  | 1.05000 |  | 10 | 718-1672-1-ND
C4 | 1276-1116-1-ND | powerblade_test | 1 | 5 | 511491 | 0.10000 | 0.01300 | 0.00920 |  | 0.00590 |  |  | 0.00416 |  | 0.00324 | 0.00292 | 10 | 1276-1116-1-ND
C5, C6, C11, C12, C13, C17, C18, C19, C20, C21 | 490-6324-1-ND | powerblade_test | 10 | 48 | 23371 | 0.10000 | 0.05000 |  | 0.02720 | 0.02300 |  | 0.01880 | 0.01610 |  | 0.01230 |  | 50 | 490-6324-1-ND
C7 | 1276-1784-1-ND | powerblade_test | 1 | 5 | 108875 | 0.26000 | 0.21600 | 0.14840 |  | 0.10800 |  |  | 0.07156 |  | 0.06345 |  | 5 | 1276-1784-1-ND
C8, C34 | 1276-1817-1-ND | powerblade_test | 2 | 10 | 7825 | 0.10000 | 0.04200 | 0.02960 |  | 0.01930 |  |  | 0.01348 |  | 0.01050 |  | 10 | 1276-1817-1-ND
C9 | 1276-1001-1-ND | powerblade_test | 1 | 5 | 3652464 | 0.10000 | 0.01500 | 0.01080 |  | 0.00690 |  |  | 0.00482 |  | 0.00375 | 0.00338 | 10 | 1276-1001-1-ND
C10 | 490-5915-1-ND | powerblade_test | 1 | 5 | 200937 | 0.15000 | 0.10000 |  | 0.05760 | 0.04750 |  | 0.04000 | 0.03350 |  | 0.02750 |  | 5 | 490-5915-1-ND
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
X1 | 535-10293-1-ND | powerblade_test | 1 | 5 | 2003 | 0.90000 | 0.79900 |  | 0.74580 | 0.66000 |  |  | 0.62370 |  |  |  | 5 | 535-10293-1-ND
X2 | 535-12058-1-ND | powerblade_test | 1 | 5 | 6389 | 1.06000 | 0.94400 |  | 0.88140 | 0.78000 |  |  | 0.73710 | 0.69811 | 0.61620 |  | 5 | 535-12058-1-ND
X3 | 535-12373-1-ND | powerblade_test | 1 | 5 | 909 | 1.10000 | 0.97300 |  | 0.90860 | 0.80400 |  |  | 0.75978 | 0.71959 | 0.63516 |  | 5 | 535-12373-1-ND
Y2 | ANT-916-CHP-TCT-ND | powerblade_test | 1 | 5 | 5780 | 4.95000 | 4.43800 | 3.99040 |  | 3.62920 |  | 3.28520 | 2.94120 |  | 2.47680 |  | 5 | ANT-916-CHP-TCT-ND

Sheet: FRACTUS
Name | Part Num | Face | Qty | Qty Needed | Qty Avail | Qty to Buy
Y1 | FR05-S1-N-0-110 | powerblade_test | 1 | 5 | 0 | 0

Sheet: TAG-CONNECT
Name | Part Num | Face | Qty | Qty Needed | Qty Avail | Qty to Buy
J1 | TC2050-IDC-430 | powerblade_test | 1 | 5 | 0 | 0
