lab11/powerblade/eagle/supply_test/past_rev/2v0/partList.xlsx

Sheet: DIGIKEY
Name | Part Num | Face | Qty | Qty Needed | Qty Avail | 1 | 10 | 25 | 50 | 100 | 250 | 500 | 750 | 1000 | 2500 | Qty to Buy
C1 | 490-4238-1-ND | supply_test_2v0 | 1 | 12 | 0 | 5.03000 | 4.47200 |  | 4.19220 | 3.91270 | 3.21404 |  |  |  |  | 12 | 490-4238-1-ND
C2, C14 | 445-1316-1-ND | supply_test_2v0 | 2 | 24 | 1927636 | 0.10000 | 0.02400 |  |  | 0.01100 | 0.00900 | 0.00770 |  | 0.00600 |  | 24 | 445-1316-1-ND
C3 | 718-1672-1-ND | supply_test_2v0 | 1 | 12 | 10779 | 2.15000 | 1.78500 |  |  | 1.57500 | 1.47000 | 1.31250 |  | 1.05000 |  | 12 | 718-1672-1-ND
C4 | 399-1053-1-ND | supply_test_2v0 | 1 | 12 | 539253 | 0.10000 | 0.04000 |  | 0.02140 | 0.01820 | 0.01484 | 0.01270 |  | 0.00990 |  | 12 | 399-1053-1-ND
C7, C10 | 587-2786-1-ND | supply_test_2v0 | 2 | 24 | 525129 | 0.26000 | 0.21600 |  | 0.12160 | 0.10800 | 0.08100 | 0.07154 |  | 0.06345 |  | 24 | 587-2786-1-ND
C8, C9 | 1276-1001-1-ND | supply_test_2v0 | 2 | 24 | 3894467 | 0.10000 | 0.01500 | 0.01080 |  | 0.00690 |  | 0.00482 |  | 0.00375 | 0.00338 | 25 | 1276-1001-1-ND
C15 | 1276-1119-1-ND | supply_test_2v0 | 1 | 12 | 474586 | 0.19000 | 0.12800 | 0.09320 |  | 0.06510 |  | 0.04650 |  | 0.03953 |  | 12 | 1276-1119-1-ND
C16 | 445-5192-1-ND | supply_test_2v0 | 1 | 12 | 434824 | 0.11000 | 0.07800 |  |  | 0.03580 | 0.02924 | 0.02502 |  | 0.01950 |  | 12 | 445-5192-1-ND
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
U3 | 296-29232-1-ND | supply_test_2v0 | 1 | 12 | 3586 | 3.94000 | 3.52900 | 3.17360 |  | 2.88650 | 2.61288 | 2.33928 | 2.12040 | 1.71000 |  | 12 | 296-29232-1-ND

Sheet: TAG-CONNECT
Name | Part Num | Face | Qty | Qty Needed | Qty Avail | Qty to Buy
J1 | TC2050-IDC-NL-430 | supply_test_2v0 | 1 | 12 | 0 | 0
