lab11/powerblade/eagle/inductor_test/assembly/InductorTesting.xlsx

Sheet: Overview
Amplifiers | DigiKey PN | Package | IBIAS (pA) | VOFFSET (uV) | GBP (kHz) | Slew (V/us) | ISUPPLY (uA)
MAX9910 | MAX9910EXK+TCT-ND | SC-70-5 | 1 | 200 | 200 | 0.1 | 4
MCP6V3 | MCP6V31UT-E/LTCT-ND | SC-70-5 | 5 | 8 | 300 | 0.13 | 23
OPA333 | 296-19547-1-ND | SC-70-5 | 70 | 2 | 350 | 0.16 | 17
OPA376 | 296-22191-1-ND | SC-70-5 | 0.2 | 5 | 5500 | 2 | 760
LMP2014 | LMP2014MT/NOPB-ND | TSSOP-14 | 0.3 | 0.12 | 3000 | 3 | 930
MAX4238 | MAX4238AUT+TCT-ND | SOT-23-6 | 1 | 0.1 | 1000 | 0.35 | 600
Common | Needed For | Parts
Power Supply | All | J1 C18 C17 U6 L6 R24 R25 C16 C19 C20 R26 R31 LED1 TP10 TP12
Current Sensing | All | R27 R28 R29 R30 C22 U7 TP16
Inductor | All | L2 R2
1.65 V Ref | Config 2 | U2 C15 R20 R21
0.054 V Ref | Config 1 | U2 C15 R22 R23
Inductor C1 | Config 1 | R3 R4 C1
Inductor C2 | Config 2 | R4 C1 R5
Experiment | Configuration | Amp RefDes | Amp PN | Parts | Total Parts |  |  | Total Parts
Control | 1 | U3 | 296-19547-1-ND | R6 R7 C2 C8 R1 R14 R15 C11 U1 C3 C14 TP1 TP2 | U3 R6 R7 C2 C8 R1 R14 R15 C11 U1 C3 C14 TP1 TP2 U2 C15 R22 R23 R3 R4 C1 J1 C18 C17 U6 L6 R24 R25 C16 C19 C20 R26 R31 LED1 TP10 TP12 R27 R28 R29 R30 C22 U7 TP16 L2 R2 |  |  | 45
New Config | 2 | U3 | 296-19547-1-ND | R6 R7 C2 C8 R14 R15 C11 U1 C3 C14 TP1 TP2 | U3 R6 R7 C2 C8 R14 R15 C11 U1 C3 C14 TP1 TP2 U2 C15 R20 R21 R4 C1 R5 J1 C18 C17 U6 L6 R24 R25 C16 C19 C20 R26 R31 LED1 TP10 TP12 R27 R28 R29 R30 C22 U7 TP16 L2 R2 |  |  | 44
MAX4238 | 1 | U4 | MAX4238AUT+TCT-ND | R9 R8 C9 C6 R12 R16 R17 C12 U1 C4 C14 TP3 TP4 | U4 R9 R8 C9 C6 R12 R16 R17 C12 U1 C4 C14 TP3 TP4 U2 C15 R22 R23 R3 R4 C1 J1 C18 C17 U6 L6 R24 R25 C16 C19 C20 R26 R31 LED1 TP10 TP12 R27 R28 R29 R30 C22 U7 TP16 L2 R2 |  |  | 45
LMP2014 | 1 | U5 | LMP2014MT/NOPB-ND | R10 R11 C10 C7 R13 R18 R19 C13 C5 TP5 TP6 | U5 R10 R11 C10 C7 R13 R18 R19 C13 C5 TP5 TP6 U2 C15 R22 R23 R3 R4 C1 J1 C18 C17 U6 L6 R24 R25 C16 C19 C20 R26 R31 LED1 TP10 TP12 R27 R28 R29 R30 C22 U7 TP16 L2 R2 |  |  | 43
OPA376 | 1 | U3 | 296-22191-1-ND | R6 R7 C2 C8 R1 R14 R15 C11 U1 C3 C14 TP1 TP2 | U3 R6 R7 C2 C8 R1 R14 R15 C11 U1 C3 C14 TP1 TP2 U2 C15 R22 R23 R3 R4 C1 J1 C18 C17 U6 L6 R24 R25 C16 C19 C20 R26 R31 LED1 TP10 TP12 R27 R28 R29 R30 C22 U7 TP16 L2 R2 |  |  | 45

Sheet: 1 Control (Sort)
1 Control: Old Configuration
C16 | 445-1239-1-ND
C8 | 445-13815-1-ND
C3 | 445-4952-1-ND
C14 | 445-4952-1-ND
C15 | 445-4952-1-ND
C18 | 445-4952-1-ND
C19 | 445-4952-1-ND
C22 | 445-4952-1-ND
C17 | 445-8023-1-ND
C20 | 445-9077-1-ND
C2 | P0.0JCT-ND
C11 | P0.0JCT-ND
C1 | P0.0JCT-ND
L6 | 490-4990-1-ND
L2 | 732-3452-1-ND
R22 | P1.00MLCT-ND
R3 | P1.00MLCT-ND
R26 | P1.0AJCT-ND
R29 | P10GCT-ND
R30 | P10GCT-ND
R27 | P10KGCT-ND
R28 | P10KGCT-ND
R23 | P16.0KLCT-ND
R25 | P180KLCT-ND
R1 | P20.0KLCT-ND
R2 | P200LCT-ND
R31 | P240GCT-ND
R15 | P30.0KLCT-ND
R6 | P4.99KLCT-ND
R24 | P560KLCT-ND
R4 | P75.0LCT-ND
R14 | P887KLCT-ND
R7 | RMCF0402FT4R99CT-ND
U3 | 296-19547-1-ND
U1 | 296-22671-1-ND
U2 | 296-22671-1-ND
U6 | 296-27695-1-ND
U7 | MAX9910EXK+TCT-ND

Sheet: 2 New Config (Sort)
2 New Config: New Configuration
C2 | 1276-1450-1-ND
C11 | 1276-1450-1-ND
C16 | 445-1239-1-ND
C1 | 445-13815-1-ND
C3 | 445-4952-1-ND
C14 | 445-4952-1-ND
C15 | 445-4952-1-ND
C18 | 445-4952-1-ND
C19 | 445-4952-1-ND
C22 | 445-4952-1-ND
C17 | 445-8023-1-ND
C20 | 445-9077-1-ND
C8 | P0.0JCT-ND
L6 | 490-4990-1-ND
L2 | 732-3452-1-ND
R6 | 541-1.30MLCT-ND
R4 | P0.0JCT-ND
R7 | P1.00KLCT-ND
R20 | P1.00MLCT-ND
R21 | P1.00MLCT-ND
R26 | P1.0AJCT-ND
R29 | P10GCT-ND
R30 | P10GCT-ND
R27 | P10KGCT-ND
R28 | P10KGCT-ND
R25 | P180KLCT-ND
R5 | P20.0KLCT-ND
R2 | P200LCT-ND
R31 | P240GCT-ND
R15 | P30.0KLCT-ND
R24 | P560KLCT-ND
R14 | P887KLCT-ND
U3 | 296-19547-1-ND
U1 | 296-22671-1-ND
U2 | 296-22671-1-ND
U6 | 296-27695-1-ND
U7 | MAX9910EXK+TCT-ND

Sheet: 3 MAX4238 (Sort)
3 MAX4238: Old Configuration
C16 | 445-1239-1-ND
C6 | 445-13815-1-ND
C4 | 445-4952-1-ND
C14 | 445-4952-1-ND
C15 | 445-4952-1-ND
C18 | 445-4952-1-ND
C19 | 445-4952-1-ND
C22 | 445-4952-1-ND
C17 | 445-8023-1-ND
C20 | 445-9077-1-ND
C9 | P0.0JCT-ND
C12 | P0.0JCT-ND
C1 | P0.0JCT-ND
L6 | 490-4990-1-ND
L2 | 732-3452-1-ND
R22 | P1.00MLCT-ND
R3 | P1.00MLCT-ND
R26 | P1.0AJCT-ND
R29 | P10GCT-ND
R30 | P10GCT-ND
R27 | P10KGCT-ND
R28 | P10KGCT-ND
R23 | P16.0KLCT-ND
R25 | P180KLCT-ND
R12 | P20.0KLCT-ND
R2 | P200LCT-ND
R31 | P240GCT-ND
R17 | P30.0KLCT-ND
R9 | P4.99KLCT-ND
R24 | P560KLCT-ND
R4 | P75.0LCT-ND
R16 | P887KLCT-ND
R8 | RMCF0402FT4R99CT-ND
U1 | 296-22671-1-ND
U2 | 296-22671-1-ND
U6 | 296-27695-1-ND
U4 | MAX4238AUT+TCT-ND
U7 | MAX9910EXK+TCT-ND

Sheet: 4 LMP2014 (Sort)
4 LMP2014: Old Configuration
C16 | 445-1239-1-ND
C7 | 445-13815-1-ND
C5 | 445-4952-1-ND
C15 | 445-4952-1-ND
C18 | 445-4952-1-ND
C19 | 445-4952-1-ND
C22 | 445-4952-1-ND
C17 | 445-8023-1-ND
C20 | 445-9077-1-ND
C10 | P0.0JCT-ND
C13 | P0.0JCT-ND
C1 | P0.0JCT-ND
L6 | 490-4990-1-ND
L2 | 732-3452-1-ND
R22 | P1.00MLCT-ND
R3 | P1.00MLCT-ND
R26 | P1.0AJCT-ND
R29 | P10GCT-ND
R30 | P10GCT-ND
R27 | P10KGCT-ND
R28 | P10KGCT-ND
R23 | P16.0KLCT-ND
R25 | P180KLCT-ND
R13 | P20.0KLCT-ND
R2 | P200LCT-ND
R31 | P240GCT-ND
R19 | P30.0KLCT-ND
R10 | P4.99KLCT-ND
R24 | P560KLCT-ND
R4 | P75.0LCT-ND
R18 | P887KLCT-ND
R11 | RMCF0402FT4R99CT-ND
U2 | 296-22671-1-ND
U6 | 296-27695-1-ND
U5 | LMP2014MT/NOPB-ND
U7 | MAX9910EXK+TCT-ND

Sheet: 5 OPA376 (Sort)
5 OPA376 - Old Configuration
C16 | 445-1239-1-ND
C8 | 445-13815-1-ND
C3 | 445-4952-1-ND
C14 | 445-4952-1-ND
C15 | 445-4952-1-ND
C18 | 445-4952-1-ND
C19 | 445-4952-1-ND
C22 | 445-4952-1-ND
C17 | 445-8023-1-ND
C20 | 445-9077-1-ND
C2 | P0.0JCT-ND
C11 | P0.0JCT-ND
C1 | P0.0JCT-ND
L6 | 490-4990-1-ND
L2 | 732-3452-1-ND
R22 | P1.00MLCT-ND
R3 | P1.00MLCT-ND
R26 | P1.0AJCT-ND
R29 | P10GCT-ND
R30 | P10GCT-ND
R27 | P10KGCT-ND
R28 | P10KGCT-ND
R23 | P16.0KLCT-ND
R25 | P180KLCT-ND
R1 | P20.0KLCT-ND
R2 | P200LCT-ND
R31 | P240GCT-ND
R15 | P30.0KLCT-ND
R6 | P4.99KLCT-ND
R24 | P560KLCT-ND
R4 | P75.0LCT-ND
R14 | P887KLCT-ND
R7 | RMCF0402FT4R99CT-ND
U3 | 296-22191-1-ND
U1 | 296-22671-1-ND
U2 | 296-22671-1-ND
U6 | 296-27695-1-ND
U7 | MAX9910EXK+TCT-ND
