lab11/powerblade/other/cad/full_system.SLDASM

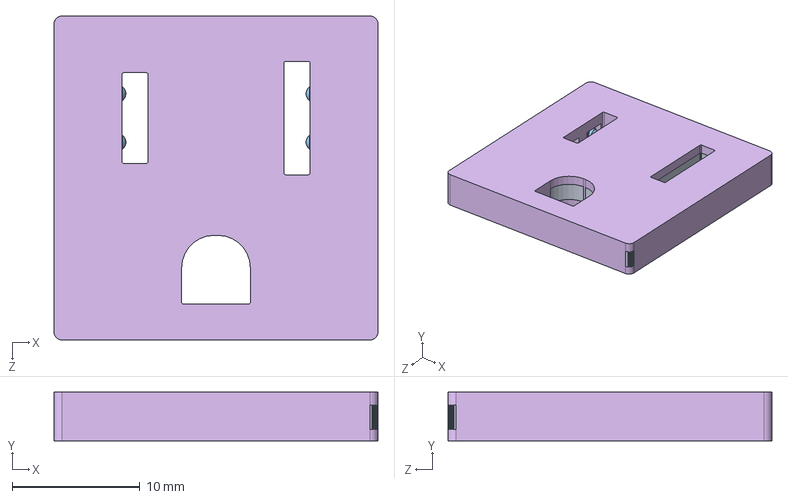
[picture p10: CAD file, 2015-10-27]
other/cad/full_system.SLDASM
25.4 x 3.81 x 25.4 mm
pcb_with_components
mill-max-0965-0-15-20-80-14-11-0_6995-0(6995-0-02-20-00-00-13-0) x 4
mill-max-0965-0-15-20-80-14-11-0_9318-0(9318-0-00-20-00-00-13-0) x 4
mill-max-0965-0-15-20-80-14-11-0_9305-0(9305-0-00-20-00-00-13-0) x 4
mill-max-0965-0-15-20-80-14-11-0_6880-0-00-00-80-XX-43-1C(6880-0-00-00-80-14-43-1) x 4
system_outline
