lab11/powerblade/other/cad/mill-max-0965-0-15-20-80-14-11-0.sldasm

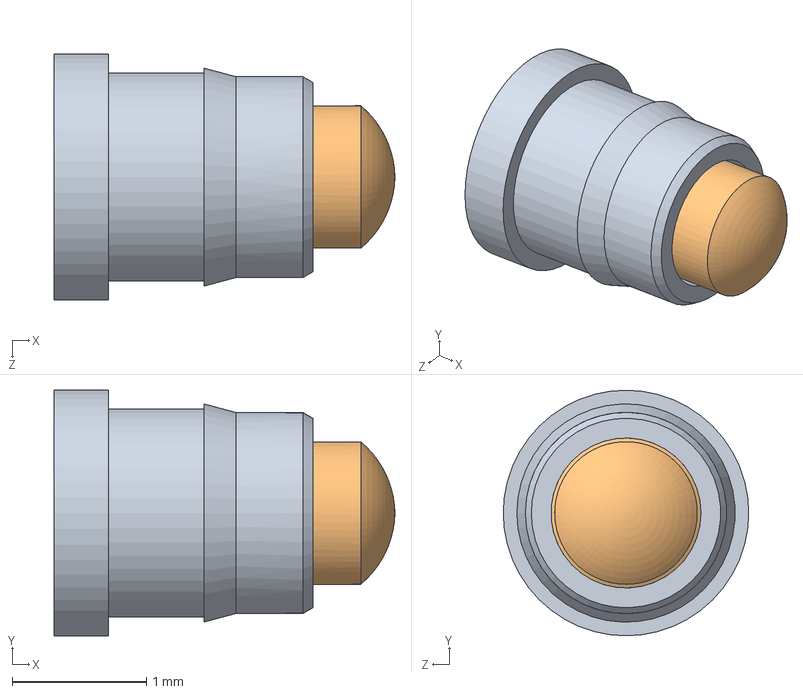
[picture p11: CAD file, 2015-10-21]
other/cad/mill-max-0965-0-15-20-80-14-11-0.sldasm
2.54 x 1.83 x 1.83 mm
mill-max-0965-0-15-20-80-14-11-0_6995-0(6995-0-02-20-00-00-13-0)
mill-max-0965-0-15-20-80-14-11-0_9318-0(9318-0-00-20-00-00-13-0)
mill-max-0965-0-15-20-80-14-11-0_9305-0(9305-0-00-20-00-00-13-0)
mill-max-0965-0-15-20-80-14-11-0_6880-0-00-00-80-XX-43-1C(6880-0-00-00-80-14-43-1)
