lab11/powerblade/eagle/powerblade/past_rev/3v0/cutouts/powerblade_test_side.dxf

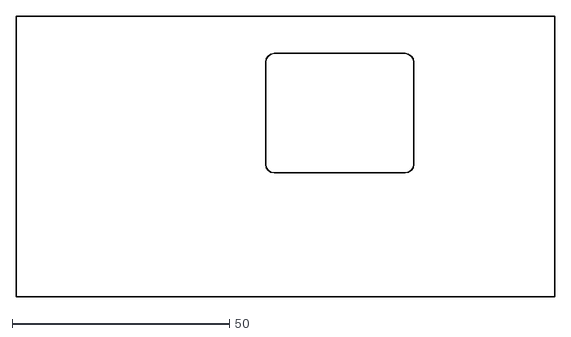
[picture p12: CAD file, 2015-05-24]
eagle/powerblade/past_rev/3v0/cutouts/powerblade_test_side.dxf
124.0 x 64.5
