lab11/powerblade/eagle/powerblade/past_rev/3v0/cutouts/powerblade_test.dxf

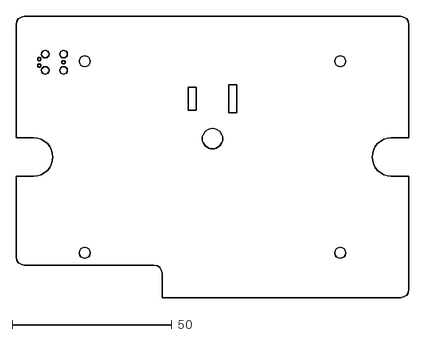
[picture p13: CAD file, 2015-05-24]
eagle/powerblade/past_rev/3v0/cutouts/powerblade_test.dxf
123.0 x 88.0
