lab11/powerblade/eagle/powerblade/past_rev/3v1/stencils/powerblade_3v1.dxf

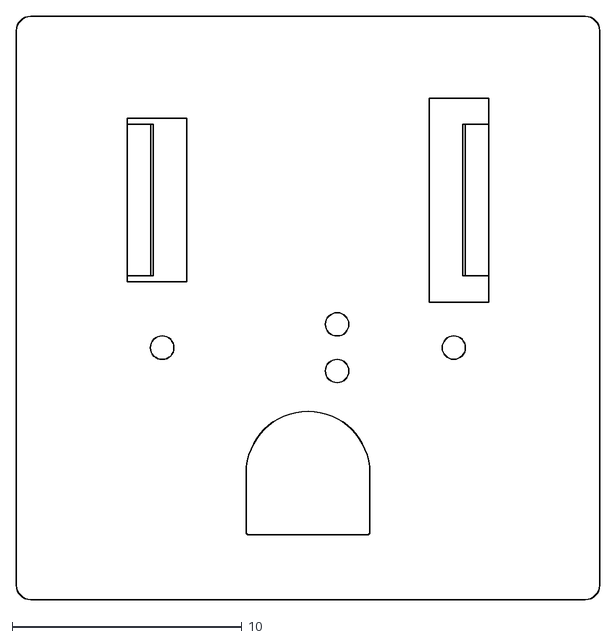
[picture p14: CAD file, 2015-06-22]
eagle/powerblade/past_rev/3v1/stencils/powerblade_3v1.dxf
25.4 x 25.4
