lab11/powerblade/other/cad/pcb_with_components.SLDPRT

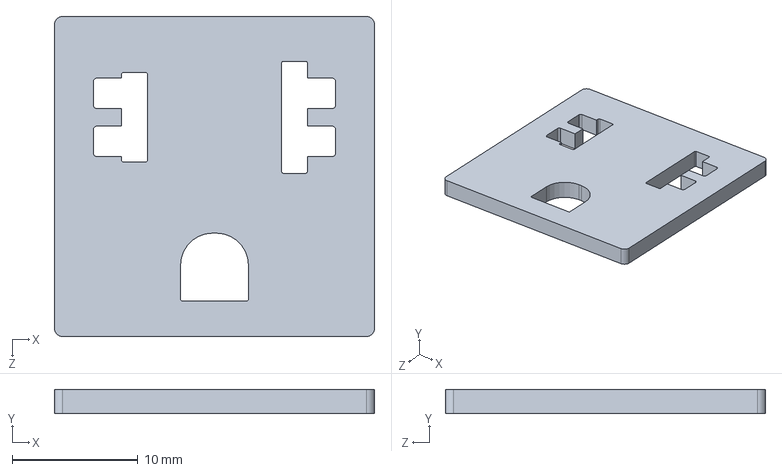
[picture p15: CAD file, 2015-10-21]
other/cad/pcb_with_components.SLDPRT
25.4 x 1.90 x 25.4 mm
