lab11/powerblade/eagle/powerblade/past_rev/3v0/cutouts/powerblade_test_top.dxf

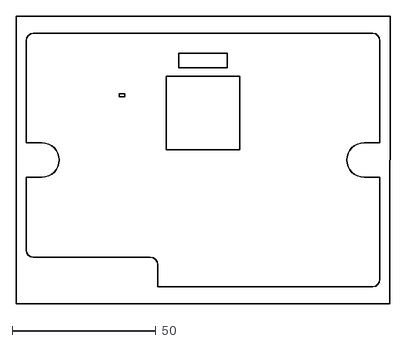
[picture p16: CAD file, 2015-05-24]
eagle/powerblade/past_rev/3v0/cutouts/powerblade_test_top.dxf
130.0 x 100.0
