lab11/powerblade/other/cad/system_outline.SLDPRT

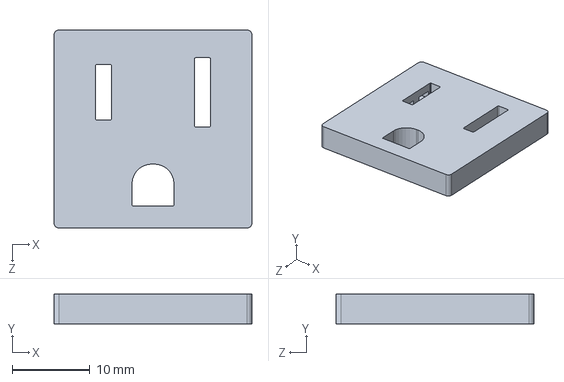
[picture p17: CAD file, 2015-10-21]
other/cad/system_outline.SLDPRT
25.4 x 3.81 x 25.4 mm
