lab11/powerblade/(list of files, cad)

Other CAD files:
eagle/powerblade/past_rev/3v1/stencils/powerblade_3v1-tcream.dxf
eagle/powerblade/past_rev/3v1/stencils/powerblade_3v1-bcream.dxf
other/cad/mill-max-0965-0-15-20-80-14-11-0_9305-0(9305-0-00-20-00-00-13-0).sldprt
other/cad/mill-max-0965-0-15-20-80-14-11-0_6880-0-00-00-80-XX-43-1C(6880-0-00-00-80-14-43-1).sldprt
other/cad/mill-max-0965-0-15-20-80-14-11-0_9318-0(9318-0-00-20-00-00-13-0).sldprt
other/cad/mill-max-0965-0-15-20-80-14-11-0_6995-0(6995-0-02-20-00-00-13-0).sldprt
