lab11/powerblade/eagle/inductor_test/assembly/Inductor_1.png

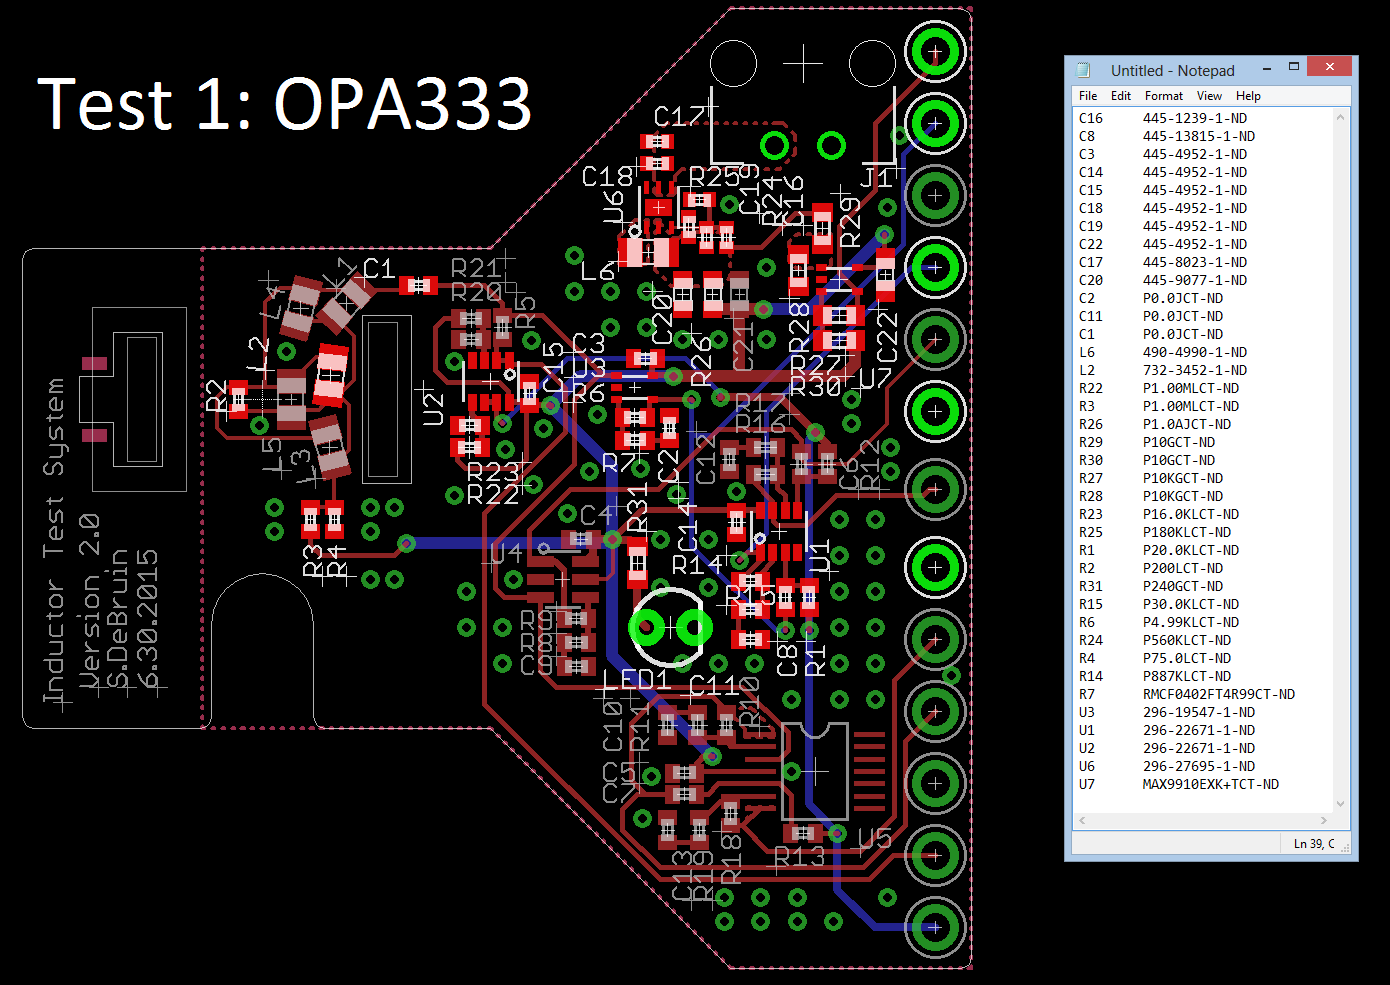
eagle/inductor_test/assembly/Inductor_1.png
