lab11/powerblade/eagle/inductor_test/assembly/Inductor_2.png

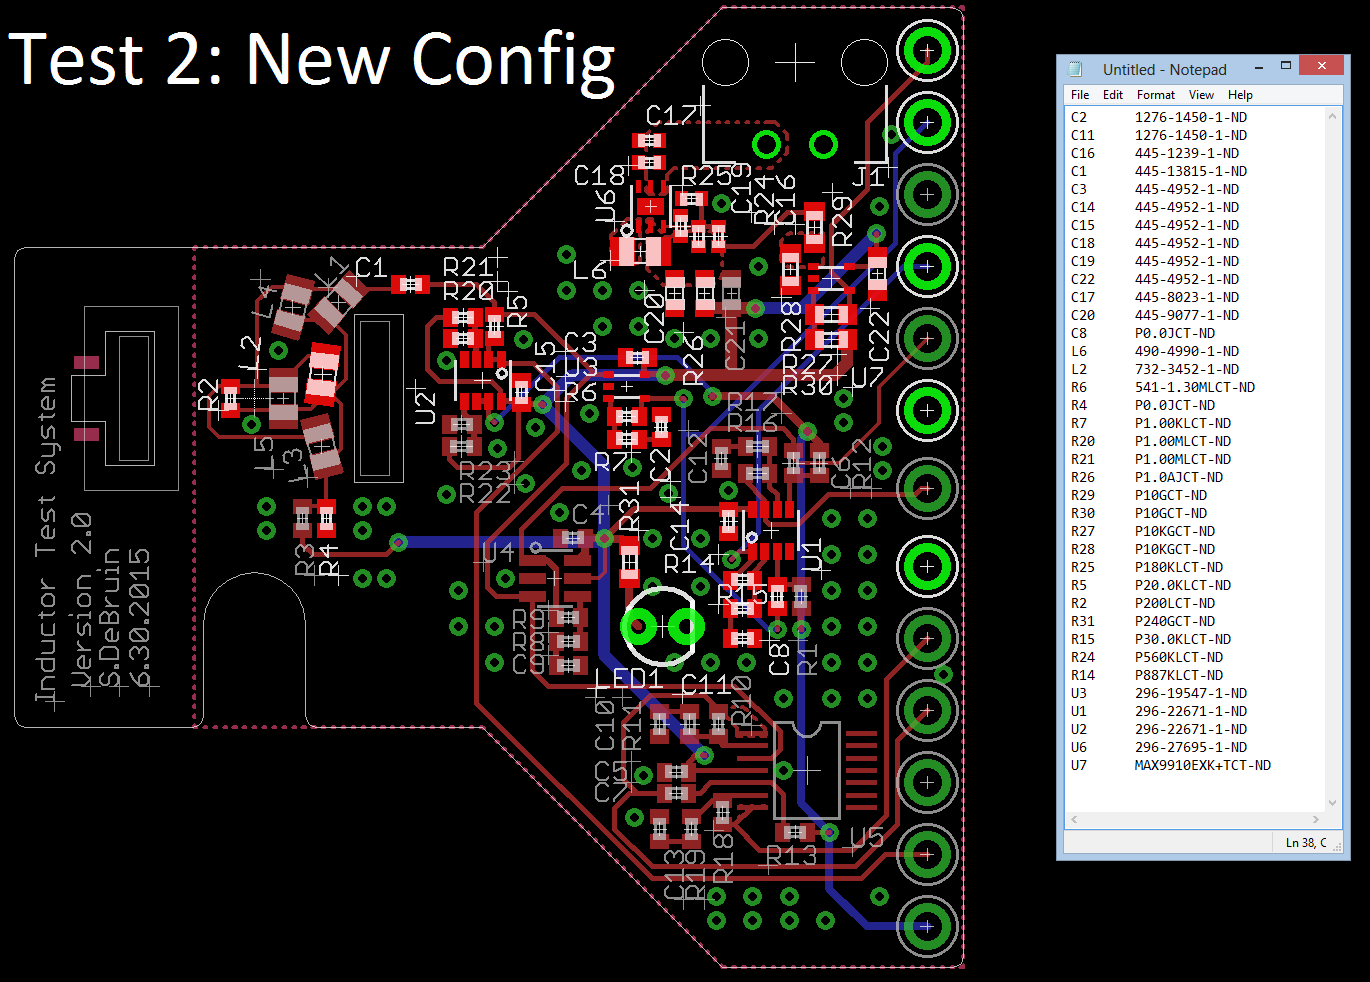
eagle/inductor_test/assembly/Inductor_2.png
