lab11/powerblade/eagle/inductor_test/assembly/Inductor_3.png

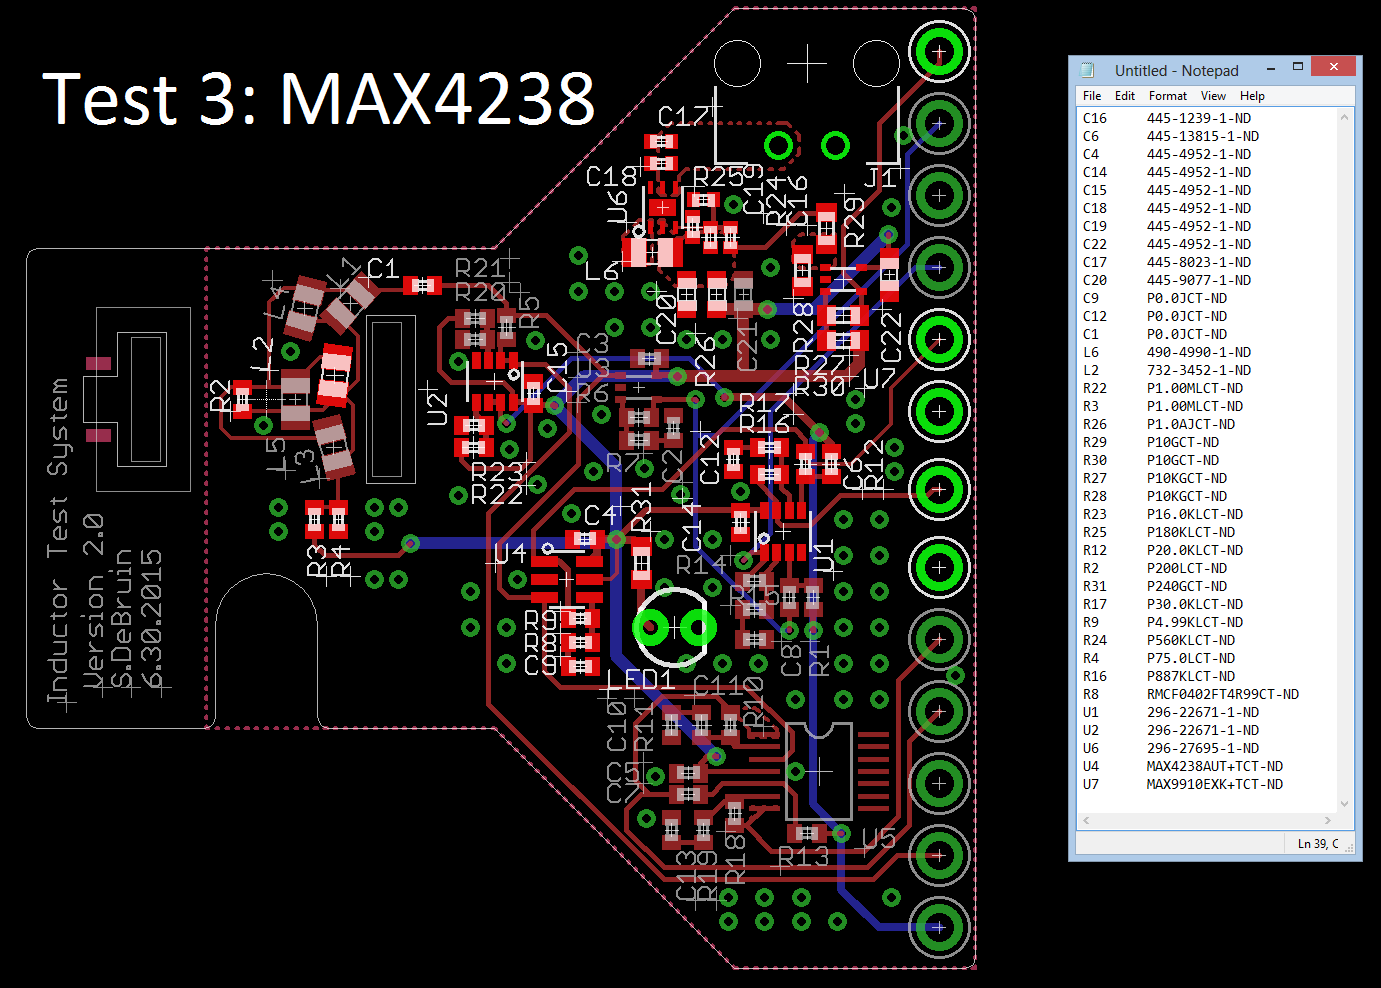
eagle/inductor_test/assembly/Inductor_3.png
