lab11/powerblade/eagle/inductor_test/assembly/Inductor_5.png

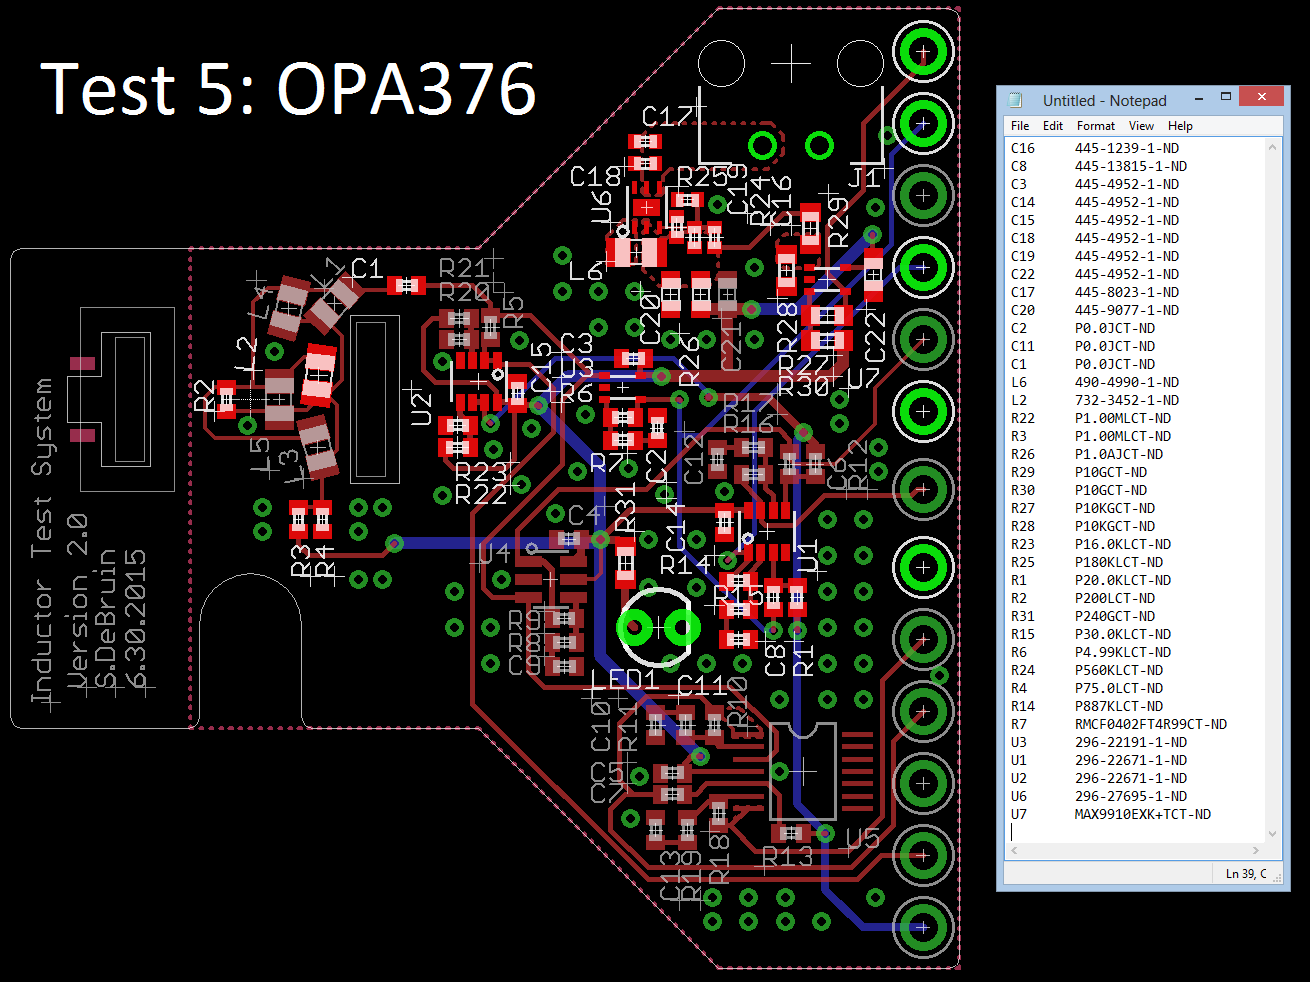
eagle/inductor_test/assembly/Inductor_5.png
