lab11/powerblade/docs/powerblade_specs/calibration.md

PowerBlade Calibration Protocol
===============================
