lab11/powerblade/eagle/inductor_test/Results_MoreData.xlsx

Scale
T1: OPA333
Power | Mean | Stddev
0 | 164.52 | 11.61421543
2 | 166.99 | 11.32475165
5 | 164.15 | 12.27558553
10 | 166.42 | 12.72006289
20 | 166.42 | 10.46279121
30 | 169.79 | 13.33791588
40 | 174.23 | 12.14701609
50 | 178.65 | 13.35252785
75 | 196.44 | 15.69012428
100 | 219.98 | 14.74550779
150 | 279.45 | 20.3007389
200 | 347.38 | 18.9293423
250 | 419.3 | 19.19973958
300 | 494.38 | 21.3864443
350 | 575.62 | 20.0124961
400 | 657.96 | 20.36565737
450 | 741.53 | 17.97247896
475 | 795.91 | 15.13043291
485
495
T2: MAX4238
Power | Mean | Stddev
0 | 190.15 | 9.687104831
2 | 189.72 | 9.317725044
5 | 188.11 | 8.766983518
10 | 187.98 | 8.853247992
20 | 188.98 | 10.37255995
30 | 192.66 | 9.52470472
40 | 195 | 10.03294573
50 | 198 | 11.02225022
75 | 212.42 | 13.45622533
100 | 232.2 | 15.43891188
150 | 281.33 | 18.06654367
200 | 343.06 | 18.64483843
250 | 409 | 20.91769586
300 | 477.28 | 21.36820067
350 | 548.19 | 22.25893079
400 | 623.26 | 22.81512656
450 | 699.34 | 22.37655023
475 | 736.4 | 19.87787715
485
495
T3: Ideal into MSP430
Power | Mean | Stddev | Exp Power
60 | 55.86 | 3.7 | 3.043478261
90 | 67.59 | 5.495452666 | 7.391304348
120 | 72.32 | 4.319722213 | 11.73913043
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
