lab11/powerblade/eagle/inductor_test/assembly/TestingResults.xlsx

Sheet: Sheet1
MAX4238
Power | Vppk (V) | Reported |  |  | Scaled | Current (mA)
0 | 0.088 | 168A | 1687 | 1683 | 54.20666667 | 3.44
5 | 0.1 | 170E | 16FB | 1735 | 55.54146667 | 3.44
10 | 0.12 | 17AD | 1778 | 1860 | 57.3682 | 3.44
15 | 0.14 | 18B1 | 18D0 | 18A6 | 59.48006667 | 3.44
20 | 0.164 | 1A2E | 1A88 | 1A5E | 63.4312 | 3.44
30 | 0.204 | 1C67 | 1C31 | 1C56 | 68.12493333 | 3.44
40 | 0.284 | 1DC6 | 1DD5 | 1DE4 | 71.7878 | 3.44
50 | 0.344 | 1F39 | 1F40 | 1EB2 | 74.73313333 | 3.44
75 | 0.6 | 26CF | 2680 | 25F1 | 92.44586667 | 3.44
100 | 0.704 | 238F | 2308 | 2290 | 84.3462 | 3.44
125 | 0.88 | 2524 | 25E0 | 25D3 | 90.5126 | 3.44
150 | 1.12 | 2D39 | 2EAE | 2E53 | 110.8761333 | 3.44
175 |  |  |  |  | 0
200 |  |  |  |  | 0
225 |  |  |  |  | 0
250 |  |  |  |  | 0
275 |  |  |  |  | 0
300 |  |  |  |  | 0
325 |  |  |  |  | 0
350 |  |  |  |  | 0
375 |  |  |  |  | 0
400 |  |  |  |  | 0
425 |  |  |  |  | 0
450 |  |  |  |  | 0
475 |  |  |  |  | 0
500 |  |  |  |  | 0
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
