lab11/powerblade/(threads)

Thread 2 (2015-12-02):

Num Received Number Confusing?

bradjc, 2015-12-02:
With multiple powerblades, sometimes it prints 8, sometimes 0, which I believe are both incorrect (assuming it is a count of the repeated advertisements that powerblade sends). After a brief look, it seems like iden_count is a global value that will get incremented by multiple powerblades, leading to what I'm seeing.

bradjc, 2015-12-02:
Also, "Packets in last 30s" doesn't seem quite right, and looking at the code it seems the maximum number of packets considered is capped at 30, even if there may have been more.

sdebruin, 2015-12-02:
Yea both of those were hacky, put in place in a time of need. I think this and other analytics don’t belong in the shipping version of this code. All the shipping version should do is unpack the packet, calculate and apply the scaling values, and calculate PF.

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

brghena, 2015-12-05:
Data access example script has been simplified as of edfb0dd76f5874c72035965f09f3644942e675af

Closed 2015-12-05.

Thread 3 (2015-12-07):

Get a hold on the LEDs on BBB

bradjc, 2015-12-07:
Something like this (from a root shell on boot or something)

```bash
echo timer > /sys/devices/ocp.3/gpio-leds.8/leds/beaglebone:green:usr0/trigger
echo 10000 > /sys/devices/ocp.3/gpio-leds.8/leds/beaglebone:green:usr0/delay_off
echo 750 > /sys/devices/ocp.3/gpio-leds.8/leds/beaglebone:green:usr0/delay_on
echo none > /sys/devices/ocp.3/gpio-leds.8/leds/beaglebone:green:usr1/trigger
echo none > /sys/devices/ocp.3/gpio-leds.8/leds/beaglebone:green:usr2/trigger
echo none > /sys/devices/ocp.3/gpio-leds.8/leds/beaglebone:green:usr3/trigger
```
This will turn off 3 LEDs and leave one as a heartbeat that blinks occasionally. Not sure if that won't still be annoying, but it's much better than the default.

Now only if we could do something about the power LED.

bradjc, 2016-02-07:
Newest SwarmGateway makes this better.

Closed 2016-02-07.

Thread 4 (2015-12-09):

PowerBlade reports bad values

brghena, 2015-12-09:
After running continuously for several days, @bradjc has noticed that PowerBlade occasionally gives bad data. The data looks fine up until a certain point, then is totally invalid. On next packet it works again. See attached for dump of several incidents.

This seems like it could be a UART transmission issue where bad data is accepted. We might see if a checksum/crc fixes the problem.

[bad_powerblade_data.txt](https://github.com/lab11/powerblade/files/57491/bad_powerblade_data.txt)

brghena, 2015-12-11:
449169e99c4235b2a1cb97f81a1ea0557af3cc80 added checksums to all UART transmission. We'll test that and see if it fixes the problem

brghena, 2016-07-12:
Yup. Fixed it

Closed 2016-07-12.

Thread 6 (2016-02-07):

Newest PowerBlades have trouble making contact with prongs.

bradjc, 2016-02-07:
2 pronged devices (various wall warts and chargers) see to have no problem making contact with the Pogos. However, I cannot get the 1ft extension cords (not Branden's) or the powerstrip on the floor in 4901 to power PowerBlades.

brghena, 2016-07-12:
Fixed as of Hardware version 4.0 and documented in the paper

Closed 2016-07-12.

Thread 8 (2016-07-22):

PowerBlade isn't reversible

brghena, 2016-07-22:
Need to come up with a solution to allow PowerBlade reversibility.

The problem, is that a load at 10 W one direction measures identically to a load at 0 W the other direction. Put another way, we don't know which direction we are plugged in. However, it _is_ easy to tell the difference with higher wattage loads (~20 watts and up). For example, a 100 watt load plugged in backwards will read -100 W.

One solution that might work for now, is to keep track in FRAM of which direction you are plugged in. If you ever register multiple readings less than -20 watts (or some number like that) make the decision that you are backwards and reverse the real power logic. This will still allow us to detect a 0 W load, as long as the load has previously drawn greater than 20 W.

ppannuto, 2016-07-22:
How do you reset a powerblade's orientation if you move it to a new device?

On Fri, Jul 22, 2016 at 3:02 PM Branden Ghena <notifications@github.com>
wrote:

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

brghena, 2016-07-22:
It should automatically swap directions whenever it sees a load less than -20 W. So if it's moved and flipped, it should automatically detect that when the load turns on.

Jovonni, 2016-12-08:
How are you guys even able to work on this on your own? Can you purchase one?

Thread 9 (2016-12-08):

How do you get PowerBlades

brghena, 2016-12-08:
@jovonni asked:

> How are you guys even able to work on this on your own? Can you purchase one?

Thanks for the interest. PowerBlade has been a very fun system to work with. We're graduate students in [Lab11](http://lab11.eecs.umich.edu/) and have been lucky to have the resources to pursue projects like these.

Unfortunately, we are not currently selling PowerBlades. However, all the hardware files are open source and available in this github repo. Theoretically, you could fabricate and assemble some yourself (or alternatively, take part of the design and include it in some other work inspired by PowerBlade). The PCB was designed in [Eagle](https://cadsoft.io/).

Hardware files (we are currently using rev 3_5): https://github.com/lab11/powerblade/tree/master/eagle/powerblade

boogerlad, 2018-01-04:
Is powerblade still being worked on(rev 4)? I'd love to buy some.

brghena, 2018-01-10:
Hey @boogerlad thanks for the interest. We are indeed still working on PowerBlade for research purposes. However, they're still nor for sale at this time. One of the issues we're addressing is how to redesign PowerBlade such that it passes UL certification and is safe for users. Until we figure out a solution for that, we aren't comfortable in selling them.

Closed 2016-12-08.

Thread 10 (2017-09-15):

Changes to support 220 volts

brghena, 2017-09-15:
According to Sam DeBruin:

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

We should fix this before producing any additional PowerBlades.

Thread 12 (2019-12-09):

Multipoint Calibration Library Issue

rhosbach, 2019-12-09:
@nealjack It looks like line 16 of chroma63800.py should be `self.inst.write(':LOAD:MODE CURR')`, not `self.inst.write(':LOAD:MODE POW')`.

https://github.com/lab11/powerblade/blob/42c69cbebb2cbbde44f3fa67d518eb6a69de4123/data_collection/multipoint_calibration/chroma63800.py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

nealjack, 2019-12-09:
You're right! I just hadn't tested setting the current.

Should be fixed in 0393291

Closed 2019-12-09.
