lab11/powerblade/docs/status_model.pdf

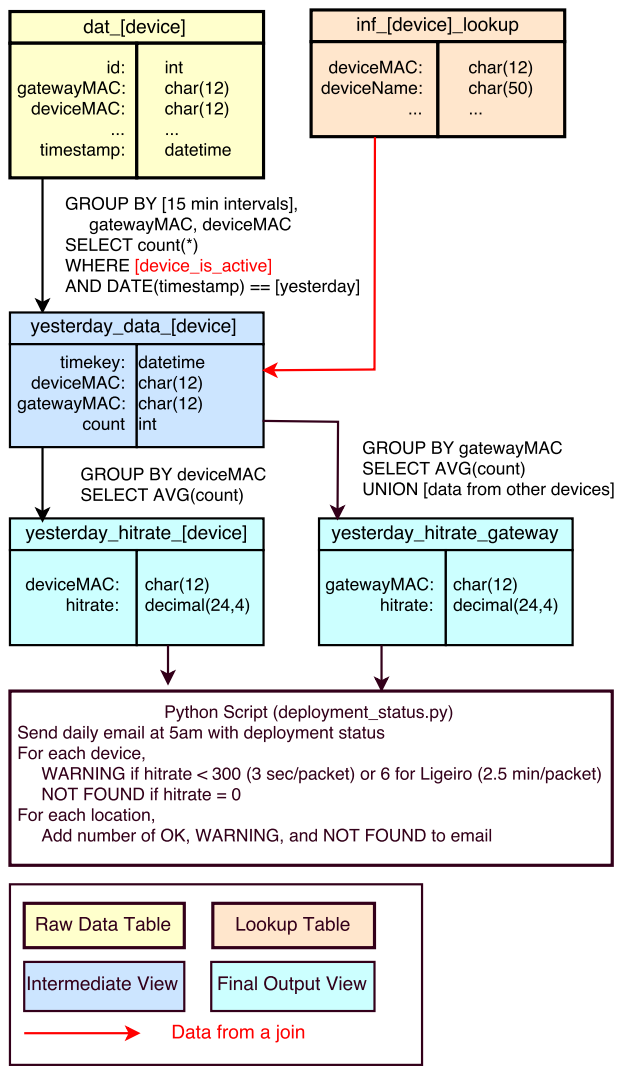
[picture p39: page 1]
