lab11/powerblade/docs/database_model.pdf

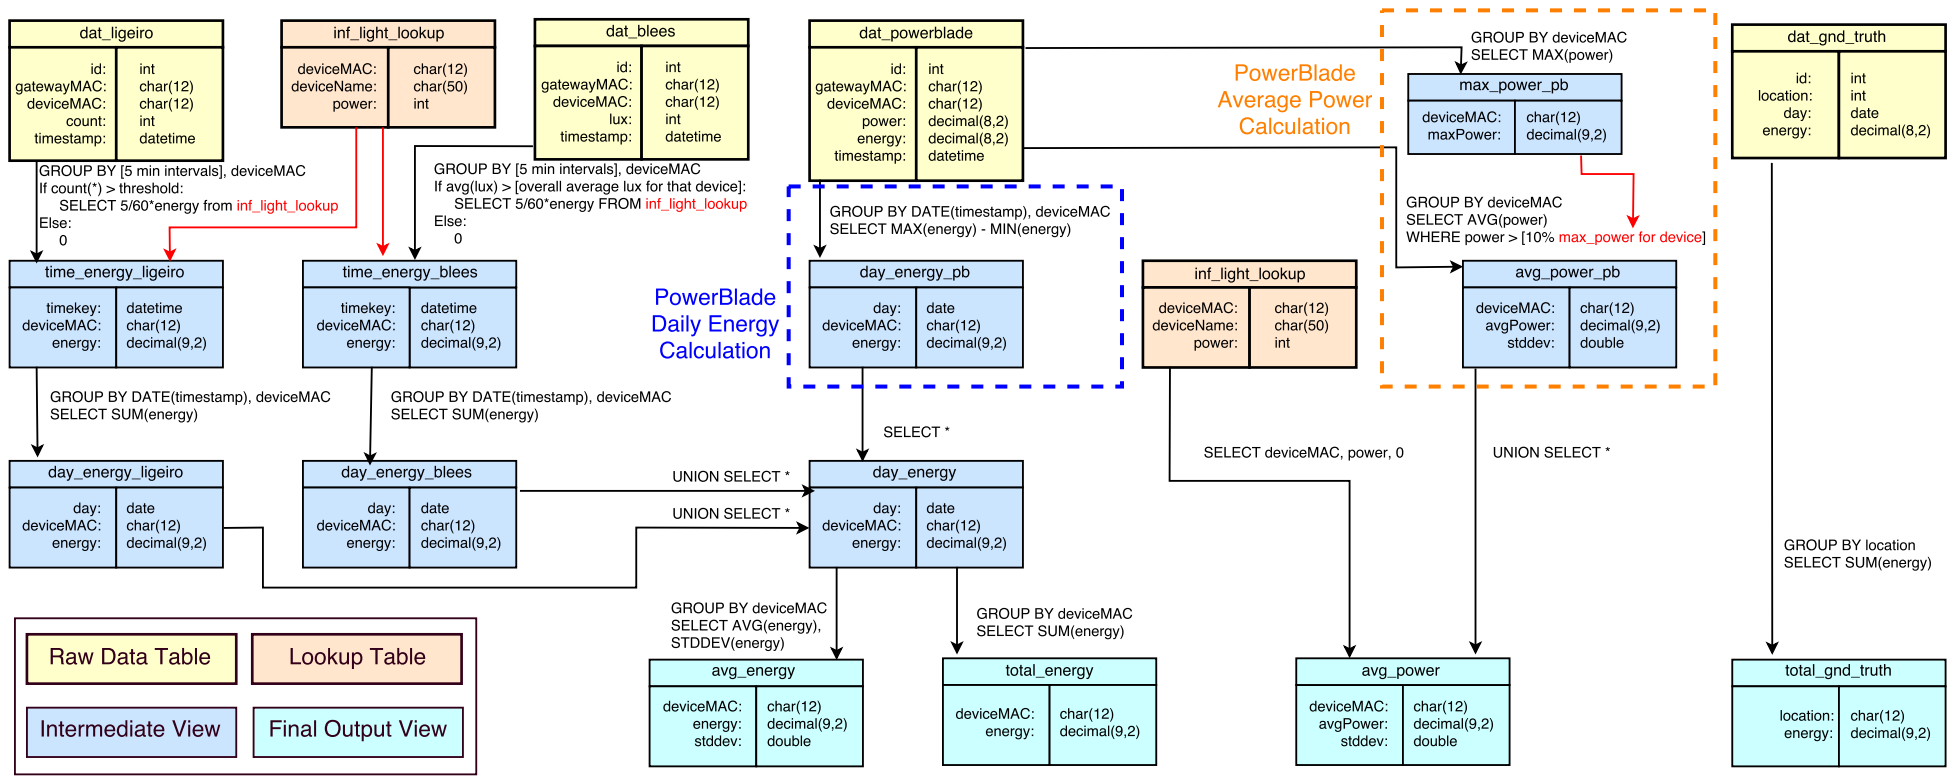
[picture p40: page 1]
