lab11/powerblade/eagle/powerblade/powerblade_3v5.brd

## EAGLE design eagle/powerblade/powerblade_3v5.brd (2016-07-18)

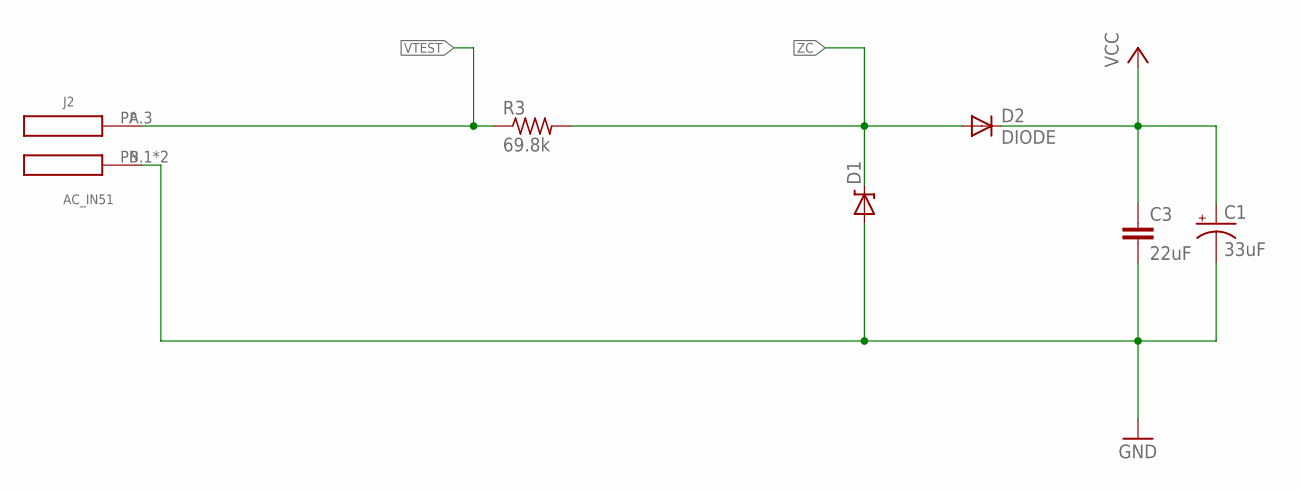
[picture p41: schematic powerblade_3v5.sch, sheet 1, AC-DC Power Supply]

Parts:
C1: 33uF; CPOL0805_SM; DIGIKEY 478-8650-1-ND
C3: 22uF; C0603_SM; DIGIKEY 445-9077-1-ND
D1: ZENERBZT52; BZT52; DIGIKEY BZT52C10T-7DICT-ND
D2: DIODE; BAS521
J2: AC_IN51; AC3_51; DIGIKEY ED1649-ND
R3: 69.8k; R1210; DIGIKEY P69.8KAACT-ND

Connections:
GND: C1.-, C3.2, D1.A, J2.PB.1 (N), J2.PB.3 (N); also elsewhere on the board
VCC: C1.+, C3.1, D2.C; also elsewhere on the board
VTEST: J2.PA.3, R3.1; also elsewhere on the board
ZC: D1.C, D2.A, R3.2; also elsewhere on the board

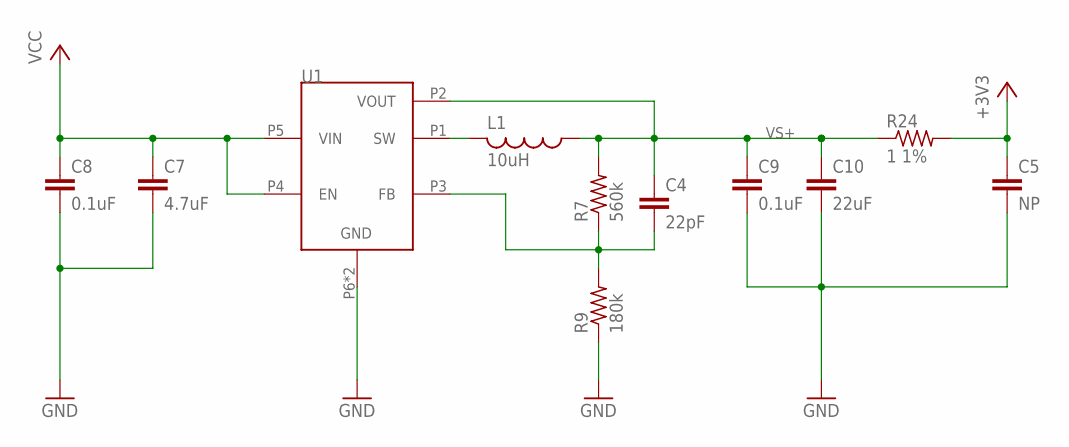
[picture p42: schematic powerblade_3v5.sch, sheet 2, Load Supply Regulation]

Parts:
C4: 22pF; C0402; DIGIKEY 445-1239-1-ND
C5: NP; C0603_TN; DIGIKEY NP
C7: 4.7uF; C0402; DIGIKEY 445-8023-1-ND
C8: 0.1uF; C0402; DIGIKEY 445-4952-1-ND
C9: 0.1uF; C0402_SM; DIGIKEY 445-4952-1-ND
C10: 22uF; C0603_SM; DIGIKEY 445-9077-1-ND
L1: 10uH; L0805; DIGIKEY 490-4990-1-ND
R7: 560k; R0402; DIGIKEY P560KLCT-ND
R9: 180k; R0402; DIGIKEY P180KLCT-ND
R24: 1 1%; R0603_SM; DIGIKEY P1.0AJCT-ND
U1: TPS62122; WDFN-6

Connections:
+3V3: C5.1, R24.2; also elsewhere on the board
GND: C5.2, C7.2, C8.2, C9.2, C10.2, R9.1, U1.P6 (GND), U1.PAD (GND); also elsewhere on the board
unnamed: L1.2, U1.P1 (SW)
unnamed: C4.2, R7.1, R9.2, U1.P3 (FB)
VCC: C7.1, C8.1, U1.P4 (EN), U1.P5 (VIN); also elsewhere on the board
VS+: C4.1, C9.1, C10.1, L1.1, R7.2, R24.1, U1.P2 (VOUT)

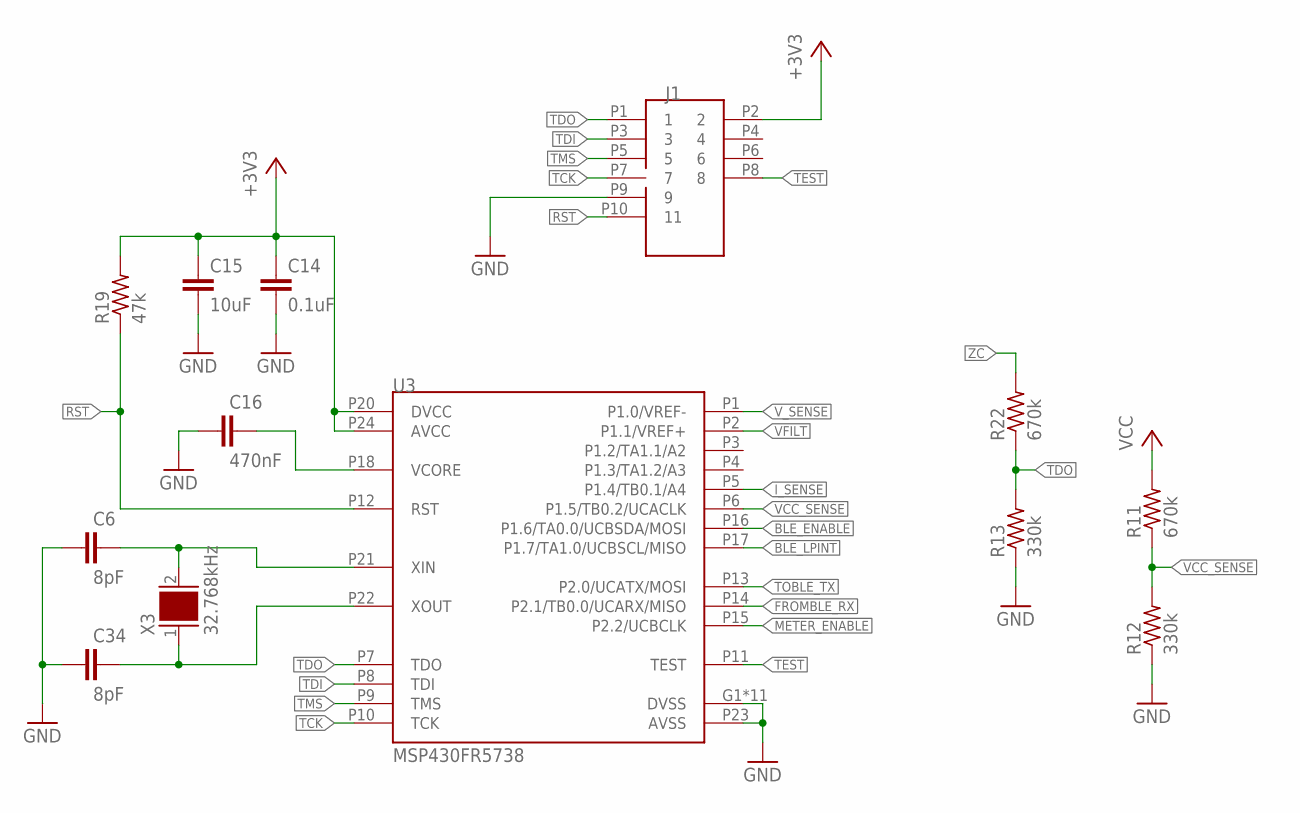
[picture p43: schematic powerblade_3v5.sch, sheet 3, MSP430FR5738]

Parts:
C6, C34: 8pF; C0402; DIGIKEY 445-4890-1-ND
C14: 0.1uF; C0402; DIGIKEY 445-4952-1-ND
C15: 10uF; C0603_SM; DIGIKEY 445-6853-1-ND
C16: 470nF; C0402; DIGIKEY 445-4989-1-ND
J1: JTAG_14PIN_IDC-ND; TC2050-IDC-NL-430-ND; DIGIKEY NP
R11, R22: 670k; R0402; DIGIKEY P665KLCT-ND
R12, R13: 330k; R0402; DIGIKEY P330KLCT-ND
R19: 47k; R0402; DIGIKEY P47KJCT-ND
U3: MSP430FR5738; VQFN-24
X3: 32.768kHz; 0805; DIGIKEY 535-12373-1-ND

Connections:
+3V3: C14.1, C15.1, J1.P2 (2), R19.2, U3.P20 (DVCC), U3.P24 (AVCC); also elsewhere on the board
BLE_ENABLE: U3.P16 (P1.6/TA0.0/UCBSDA/MOSI); also elsewhere on the board
BLE_LPINT: U3.P17 (P1.7/TA1.0/UCBSCL/MISO); also elsewhere on the board
FROMBLE_RX: U3.P14 (P2.1/TB0.0/UCARX/MISO); also elsewhere on the board
GND: C6.1, C14.2, C15.2, C16.1, C34.1, J1.P9 (9), R12.1, R13.1, U3.G1 (DVSS), U3.G2 (DVSS), U3.G3 (DVSS), U3.G4 (DVSS), U3.G5 (DVSS), U3.G6 (DVSS), U3.G7 (DVSS), U3.G8 (DVSS), U3.G9 (DVSS), U3.P19 (DVSS), U3.P23 (AVSS), U3.PAD (DVSS); also elsewhere on the board
I_SENSE: U3.P5 (P1.4/TB0.1/A4); also elsewhere on the board
METER_ENABLE: U3.P15 (P2.2/UCBCLK); also elsewhere on the board
unnamed: C34.2, U3.P22 (XOUT), X3.1
unnamed: C16.2, U3.P18 (VCORE)
unnamed: C6.2, U3.P21 (XIN), X3.2
RST: J1.P10 (11), R19.1, U3.P12 (RST)
TCK: J1.P7 (7), U3.P10 (TCK)
TDI: J1.P3 (3), U3.P8 (TDI)
TDO: J1.P1 (1), R13.2, R22.1, U3.P7 (TDO)
TEST: J1.P8 (8), U3.P11 (TEST)
TMS: J1.P5 (5), U3.P9 (TMS)
TOBLE_TX: U3.P13 (P2.0/UCATX/MOSI); also elsewhere on the board
VCC: R11.2; also elsewhere on the board
VCC_SENSE: R11.1, R12.2, U3.P6 (P1.5/TB0.2/UCACLK)
VFILT: U3.P2 (P1.1/VREF+); also elsewhere on the board
V_SENSE: U3.P1 (P1.0/VREF-); also elsewhere on the board
ZC: R22.2; also elsewhere on the board

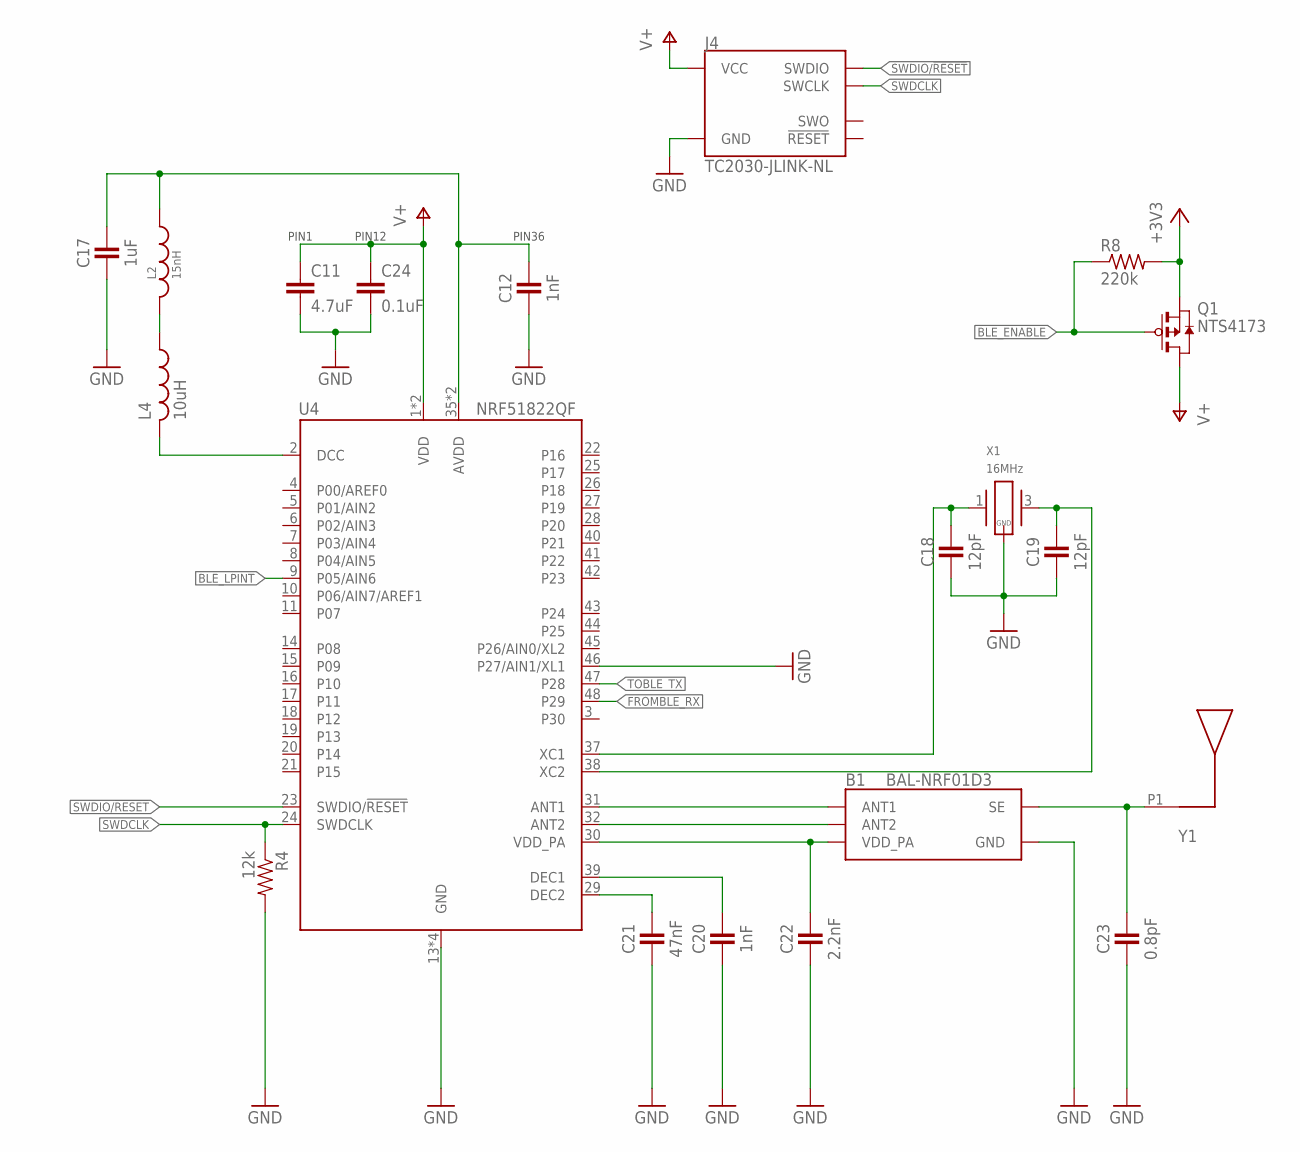
[picture p44: schematic powerblade_3v5.sch, sheet 4, nr51822]

Parts:
B1: BAL-NRF01D3
C11: 4.7uF; C0402; DIGIKEY 445-5947-1-ND
C12, C20: 1nF; 0402_CAP; DIGIKEY 490-1303-1-ND
C17: 1uF; 0402_CAP; DIGIKEY 1276-1513-1-ND
C18, C19: 12pF; 0402_CAP; DIGIKEY 490-6197-1-ND
C21: 47nF; 0402_CAP; DIGIKEY 445-1264-1-ND
C22: 2.2nF; 0402_CAP; DIGIKEY 490-5419-1-ND
C23: 0.8pF; 0402_CAP; DIGIKEY 490-6269-1-ND
C24: 0.1uF; C0402; DIGIKEY 445-4952-1-ND
J4: TC2030-JLINK-NL; TC2030-IDC-NL; DIGIKEY NP
L2: 15nH; 0402_CAP; DIGIKEY 587-1521-1-ND
L4: 10uH; C0603_TN; DIGIKEY 490-4025-1-ND
Q1: NTS4173; SC-70-3
R4: 12k; 0402_RES; DIGIKEY RHM12.0KCDCT-ND
R8: 220k; R0402_SM; DIGIKEY P220KJCT-ND
U4: NRF51822QF; QFN-48-6MM
X1: 16MHz; TXC-8Y; DIGIKEY 887-2003-1-ND
Y1: UREACH_XTEND

Connections:
+3V3: Q1.P2 (S), R8.2; also elsewhere on the board
AVDD: C12.1, C17.1, L2.1, U4.35 (AVDD), U4.36 (AVDD)
BLE_ENABLE: Q1.P1 (G), R8.1; also elsewhere on the board
BLE_LPINT: U4.9 (P05/AIN6); also elsewhere on the board
DCC: L4.2, U4.2 (DCC)
FROMBLE_RX: U4.48 (P29); also elsewhere on the board
GND: B1.GND, C11.2, C12.2, C17.2, C18.2, C19.2, C20.2, C21.2, C22.2, C23.2, C24.2, J4.5 (GND), R4.2, U4.13 (GND), U4.33 (GND), U4.34 (GND), U4.46 (P27/AIN1/XL1), U4.GND, X1.2 (GND), X1.4 (GND); also elsewhere on the board
unnamed: B1.SE, C23.1, Y1.P1
unnamed: B1.ANT1, U4.31 (ANT1)
unnamed: B1.ANT2, U4.32 (ANT2)
unnamed: L2.2, L4.1
unnamed: C18.1, U4.37 (XC1), X1.1
unnamed: C19.1, U4.38 (XC2), X1.3 (2)
unnamed: C20.1, U4.39 (DEC1)
unnamed: C21.1, U4.29 (DEC2)
SWDCLK: J4.4 (SWCLK), R4.1, U4.24 (SWDCLK)
SWDIO/!RESET: J4.2 (SWDIO), U4.23 (SWDIO/!RESET)
TOBLE_TX: U4.47 (P28); also elsewhere on the board
V+: C11.1, C24.1, J4.1 (VCC), Q1.P3 (D), U4.1 (VDD), U4.12 (VDD)
VDD_PA: B1.VCC (VDD_PA), C22.1, U4.30 (VDD_PA)

Notes on the sheet:
PIN12
PIN1
PIN36

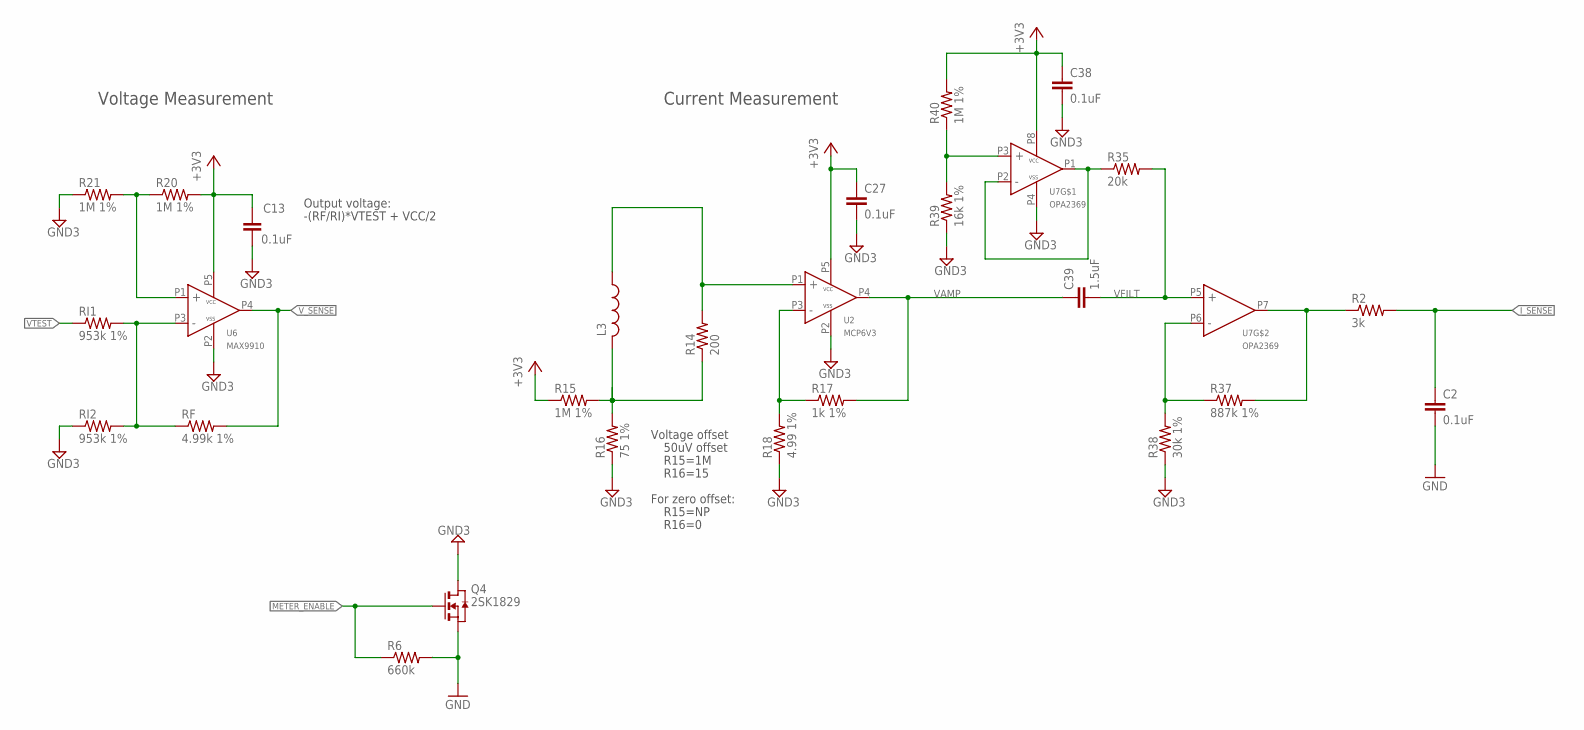
[picture p45: schematic powerblade_3v5.sch, sheet 5, Power Sensing!]

Parts:
C2: 0.1uF; C0402; DIGIKEY 490-10777-1-ND
C13: 0.1uF; 0402_CAP; DIGIKEY 445-4952-1-ND
C27, C38: 0.1uF; C0402; DIGIKEY 445-4952-1-ND
C39: 1.5uF; C0402; DIGIKEY 445-13815-1-ND
L3: L-USL0805; L0805; DIGIKEY 732-3452-1-ND
Q4: 2SK1829; SC-70-3
R2: 3k; R0402_SM; DIGIKEY P3.00KLCT-ND
R6: 660k; R0402; DIGIKEY P665KLCT-ND
R14: 200; R0402; DIGIKEY P200LCT-ND
R15, R20, R40: 1M 1%; R0402; DIGIKEY P1.00MLCT-ND
R16: 75 1%; R0402; DIGIKEY P75.0LCT-ND
R17: 1k 1%; R0402; DIGIKEY P1.00KLCT-ND
R18: 4.99 1%; R0402; DIGIKEY RMCF0402FT4R99CT-ND
R21: 1M 1%; R0402_SM; DIGIKEY P1.00MLCT-ND
R35: 20k; R0402; DIGIKEY P20.0KLCT-ND
R37: 887k 1%; R0402; DIGIKEY P887KLCT-ND
R38: 30k 1%; R0402; DIGIKEY P30.0KLCT-ND
R39: 16k 1%; R0402; DIGIKEY P16.0KLCT-ND
RF: 4.99k 1%; R0402; DIGIKEY P4.99KLCT-ND
RI1, RI2: 953k 1%; R0402; DIGIKEY P953KLCT-ND
U2: MCP6V3; SC70-5; DIGIKEY 296-19547-1-ND
U6: MAX9910; SC70-5; DIGIKEY 296-25252-1-ND
U7: OPA2369; SOT-23-8

Connections:
+3V3: C13.1, C27.1, C38.1, R15.1, R20.2, R40.2, U2.P5 (VCC), U6.P5 (VCC), U7.P8 (VCC); also elsewhere on the board
GND: C2.2, Q4.P2 (S), R6.2; also elsewhere on the board
GND3: C13.2, C27.2, C38.2, Q4.P3 (D), R16.1, R18.1, R21.1, R38.1, R39.1, RI2.1, U2.P2 (VSS), U6.P2 (VSS), U7.P4 (VSS)
I_SENSE: C2.1, R2.2; also elsewhere on the board
METER_ENABLE: Q4.P1 (G), R6.1; also elsewhere on the board
unnamed: R2.1, R37.2, U7.P7 (OUT)
unnamed: L3.2, R14.1, R15.2, R16.2
unnamed: L3.1, R14.2, U2.P1 (IN+)
unnamed: R20.1, R21.2, U6.P1 (IN+)
unnamed: RF.1, RI1.2, RI2.2, U6.P3 (IN-)
unnamed: R17.1, R18.2, U2.P3 (IN-)
unnamed: R37.1, R38.2, U7.P6 (IN-)
unnamed: R35.1, U7.P1 (OUT), U7.P2 (IN-)
unnamed: R39.2, R40.1, U7.P3 (IN+)
VAMP: C39.1, R17.2, U2.P4 (OUT)
VFILT: C39.2, R35.2, U7.P5 (IN+); also elsewhere on the board
VTEST: RI1.1; also elsewhere on the board
V_SENSE: RF.2, U6.P4 (OUT); also elsewhere on the board

Notes on the sheet:
Voltage offset
50uV offset
For zero offset:
R15=NP
R16=0
Current Measurement
Voltage Measurement
Output voltage:
-(RF/RI)*VTEST + VCC/2
R15=1M
R16=15

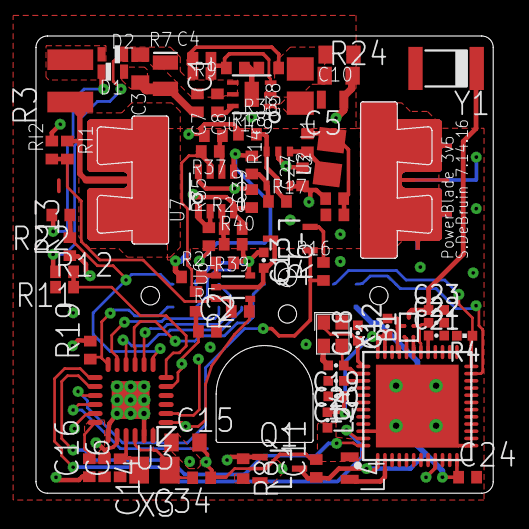
[picture p46: board powerblade_3v5.brd from above]

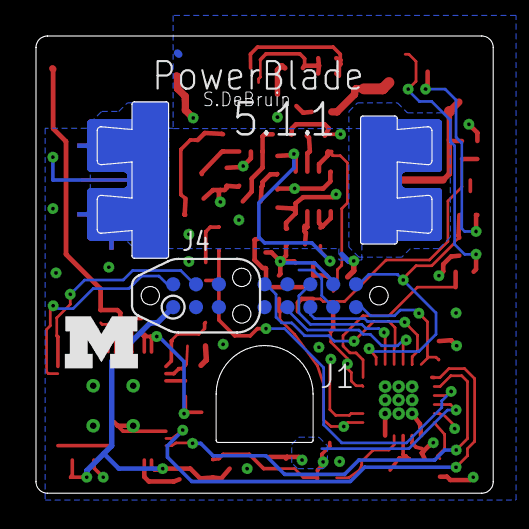
[picture p47: board powerblade_3v5.brd from below]

Board: 4 copper layers, 25.4 x 25.4 mm, 78 parts (3 on the bottom side), 51 nets.

Other parts of the board:
U$1: BLOCK-M
