lab11/powerblade/eagle/inductor_test/inductor_test_2v0.brd

## EAGLE design eagle/inductor_test/inductor_test_2v0.brd (2015-07-02)

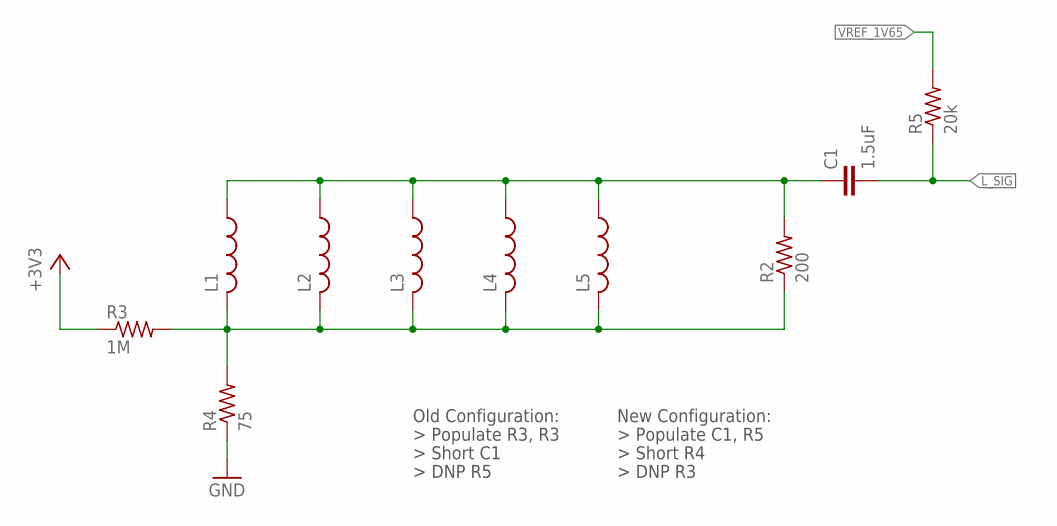
[picture p48: schematic inductor_test_2v0.sch, sheet 1, Inductors]

Parts:
C1: 1.5uF; C0402; DIGIKEY 445-13815-1-ND
L1, L2, L3, L4, L5: L-USL0805; L0805; DIGIKEY 732-3452-1-ND
R2: 200; R0402; DIGIKEY P200LCT-ND
R3: 1M; R0402; DIGIKEY P1.00MLCT-ND
R4: 75; R0402; DIGIKEY P75.0LCT-ND
R5: 20k; R0402; DIGIKEY P20.0KLCT-ND

Connections:
+3V3: R3.1; also elsewhere on the board
GND: R4.1; also elsewhere on the board
L1P2: L1.2, L2.2, L3.2, L4.2, L5.2, R2.1, R3.2, R4.2
L_SIG: C1.2, R5.1; also elsewhere on the board
unnamed: C1.1, L1.1, L2.1, L3.1, L4.1, L5.1, R2.2
VREF_1V65: R5.2; also elsewhere on the board

Notes on the sheet:
Old Configuration:
New Configuration:

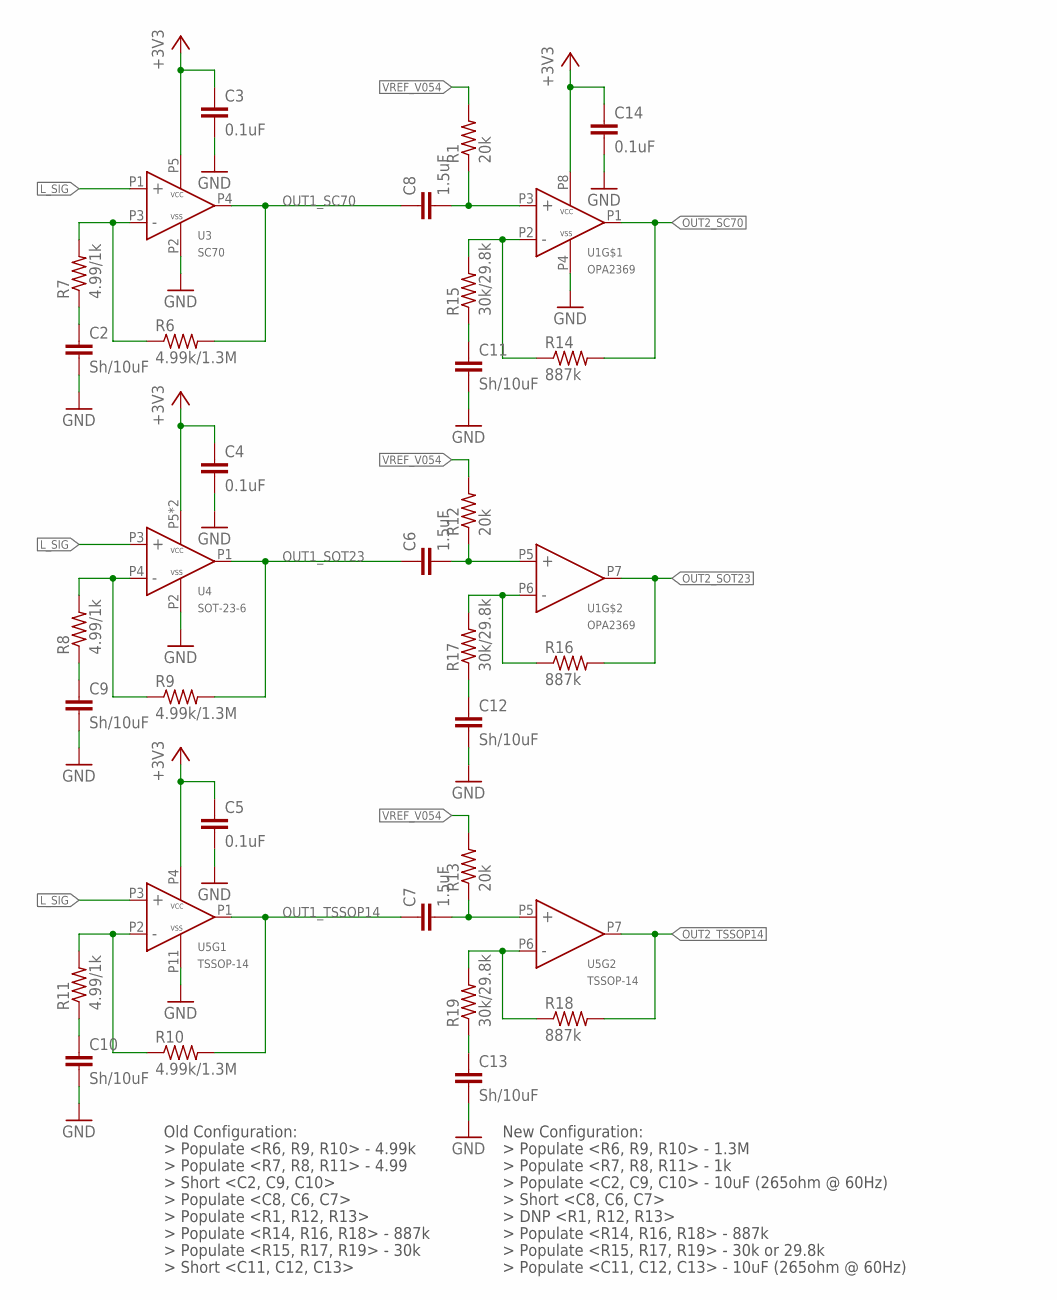
[picture p49: schematic inductor_test_2v0.sch, sheet 2, New Amplifiers]

Parts:
C2, C9, C10, C11, C12, C13: Sh/10uF; C0402; DIGIKEY 1276-1450-1-ND
C3, C4, C5, C14: 0.1uF; C0402; DIGIKEY 445-4952-1-ND
C6, C7, C8: 1.5uF; C0402; DIGIKEY 445-13815-1-ND
R1, R12, R13: 20k; R0402; DIGIKEY P20.0KLCT-ND
R6, R9, R10: 4.99k/1.3M; R0402; DIGIKEY P4.99KLCT-ND
R7, R8, R11: 4.99/1k; R0402; DIGIKEY RMCF0402FT4R99CT-ND
R14, R16, R18: 887k; R0402; DIGIKEY P887KLCT-ND
R15, R17, R19: 30k/29.8k; R0402; DIGIKEY P30.0KLCT-ND
U1: OPA2369; SOT-23-8
U3: SC70; SC70-5; DIGIKEY 296-22191-1-ND
U4: SOT-23-6
U5: TSSOP-14

Connections:
+3V3: C3.1, C4.1, C5.1, C14.1, U1.P8 (VCC), U3.P5 (VCC), U4.P5 (VCC), U4.P6 (VCC), U5.P4 (VCC); also elsewhere on the board
GND: C2.2, C3.2, C4.2, C5.2, C9.2, C10.2, C11.2, C12.2, C13.2, C14.2, U1.P4 (VSS), U3.P2 (VSS), U4.P2 (VSS), U5.P11 (VSS); also elsewhere on the board
L_SIG: U3.P1 (IN+), U4.P3 (IN+), U5.P3 (IN+); also elsewhere on the board
unnamed: C10.1, R11.1
unnamed: C9.1, R8.1
unnamed: R6.1, R7.2, U3.P3 (IN-)
unnamed: R8.2, R9.1, U4.P4 (IN-)
unnamed: C2.1, R7.1
unnamed: C8.2, R1.1, U1.P3 (IN+)
unnamed: R10.1, R11.2, U5.P2 (IN-)
unnamed: R14.1, R15.2, U1.P2 (IN-)
unnamed: C6.2, R12.1, U1.P5 (IN+)
unnamed: C11.1, R15.1
unnamed: C7.2, R13.1, U5.P5 (IN+)
unnamed: R16.1, R17.2, U1.P6 (IN-)
unnamed: C12.1, R17.1
unnamed: R18.1, R19.2, U5.P6 (IN-)
unnamed: C13.1, R19.1
OUT1_SC70: C8.1, R6.2, U3.P4 (OUT); also elsewhere on the board
OUT1_SOT23: C6.1, R9.2, U4.P1 (OUT); also elsewhere on the board
OUT1_TSSOP14: C7.1, R10.2, U5.P1 (OUT); also elsewhere on the board
OUT2_SC70: R14.2, U1.P1 (OUT); also elsewhere on the board
OUT2_SOT23: R16.2, U1.P7 (OUT); also elsewhere on the board
OUT2_TSSOP14: R18.2, U5.P7 (OUT); also elsewhere on the board
VREF_V054: R1.2, R12.2, R13.2; also elsewhere on the board

Notes on the sheet:
Old Configuration:
New Configuration:

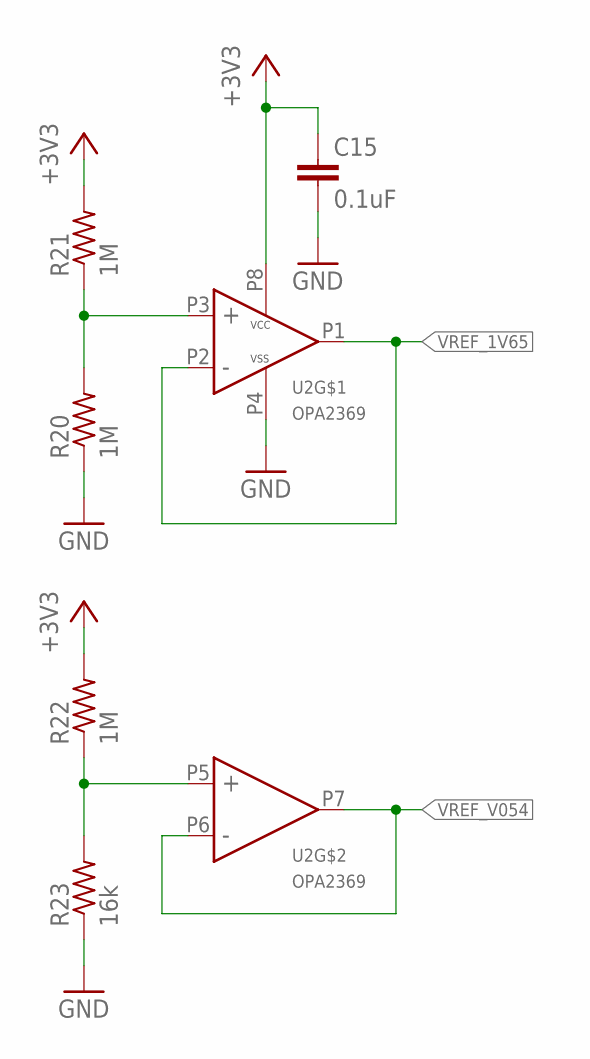
[picture p50: schematic inductor_test_2v0.sch, sheet 3, Voltage reference]

Parts:
C15: 0.1uF; C0402; DIGIKEY 445-4952-1-ND
R20, R21, R22: 1M; R0402; DIGIKEY P1.00MLCT-ND
R23: 16k; R0402; DIGIKEY P16.0KLCT-ND
U2: OPA2369; SOT-23-8

Connections:
+3V3: C15.1, R21.2, R22.2, U2.P8 (VCC); also elsewhere on the board
GND: C15.2, R20.1, R23.1, U2.P4 (VSS); also elsewhere on the board
unnamed: R22.1, R23.2, U2.P5 (IN+)
unnamed: R20.2, R21.1, U2.P3 (IN+)
VREF_1V65: U2.P1 (OUT), U2.P2 (IN-); also elsewhere on the board
VREF_V054: U2.P6 (IN-), U2.P7 (OUT); also elsewhere on the board

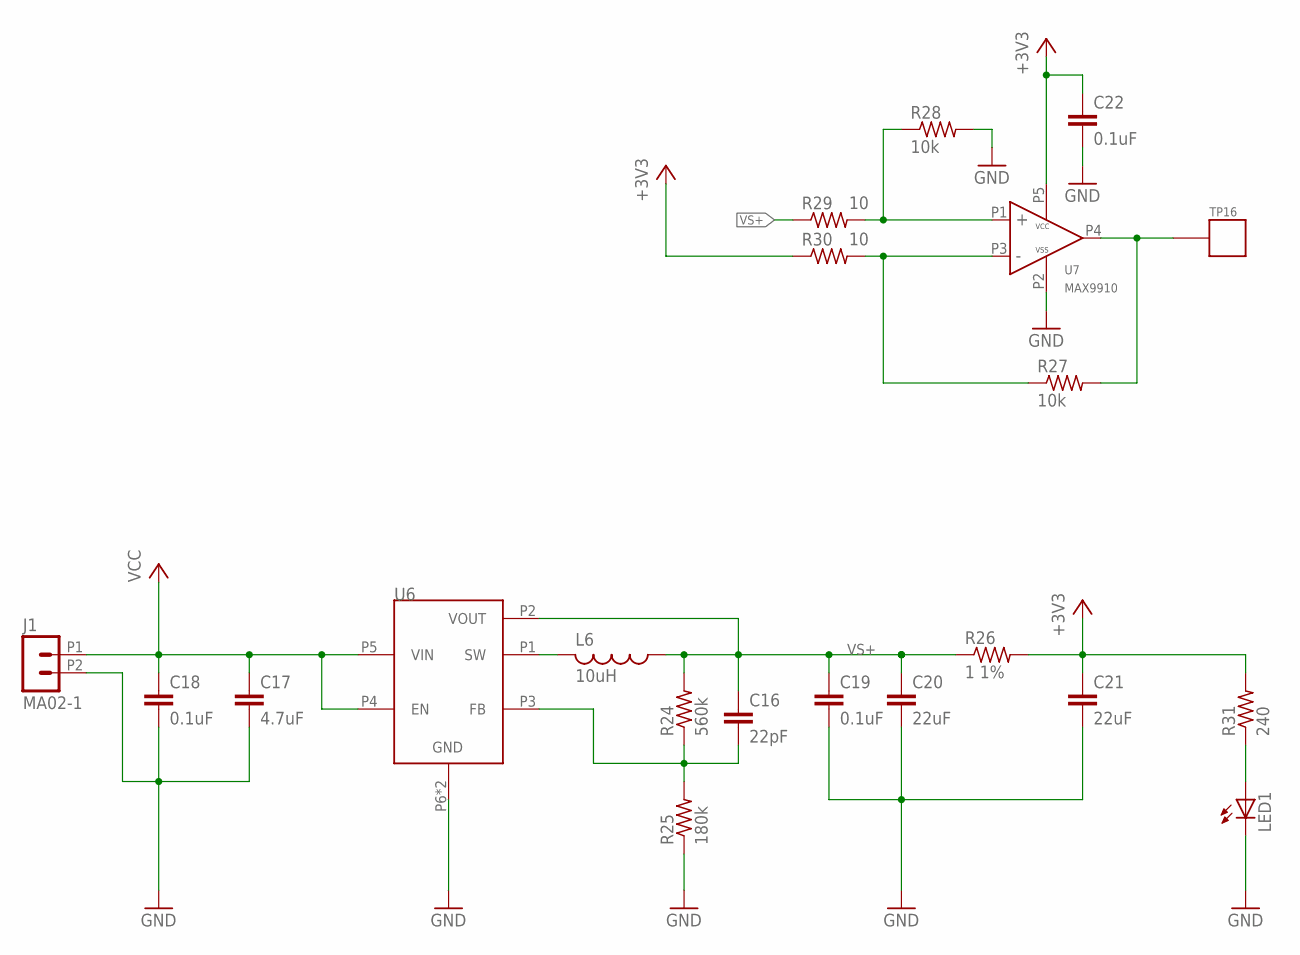
[picture p51: schematic inductor_test_2v0.sch, sheet 4, Power Supply]

Parts:
C16: 22pF; C0402_SM; DIGIKEY 445-1239-1-ND
C17: 4.7uF; C0402_SM; DIGIKEY 445-8023-1-ND
C18, C19: 0.1uF; C0402_SM; DIGIKEY 445-4952-1-ND
C20, C21: 22uF; C0603_SM; DIGIKEY 445-9077-1-ND
C22: 0.1uF; C0603; DIGIKEY 445-4952-1-ND
J1: MA02-1; MA02-1_MOLEX-TH
L6: 10uH; L0805; DIGIKEY 490-4990-1-ND
LED1: LED3MM; DIGIKEY 1125-1181-ND
R24: 560k; R0402_SM; DIGIKEY P560KLCT-ND
R25: 180k; R0402_SM; DIGIKEY P180KLCT-ND
R26: 1 1%; R0603_SM; DIGIKEY P1.0AJCT-ND
R27, R28: 10k; R0603; DIGIKEY P10KGCT-ND
R29, R30: 10; R0603; DIGIKEY P10GCT-ND
R31: 240; R0603; DIGIKEY P240GCT-ND
TP16: TP_MULT; DIGIKEY 36-5013-ND
U6: TPS62122; WDFN-6
U7: MAX9910; SC70-5

Connections:
+3V3: C21.1, C22.1, R26.2, R30.1, R31.2, U7.P5 (VCC); also elsewhere on the board
GND: C17.2, C18.2, C19.2, C20.2, C21.2, C22.2, J1.P2 (2), LED1.K (C), R25.1, R28.2, U6.P6 (GND), U6.PAD (GND), U7.P2 (VSS); also elsewhere on the board
unnamed: C16.2, R24.1, R25.2, U6.P3 (FB)
unnamed: L6.2, U6.P1 (SW)
unnamed: R28.1, R29.2, U7.P1 (IN+)
unnamed: R27.1, R30.2, U7.P3 (IN-)
unnamed: R27.2, TP16.P$1, U7.P4 (OUT)
unnamed: LED1.A, R31.1
VCC: C17.1, C18.1, J1.P1 (1), U6.P4 (EN), U6.P5 (VIN)
VS+: C16.1, C19.1, C20.1, L6.1, R24.2, R26.1, R29.1, U6.P2 (VOUT)

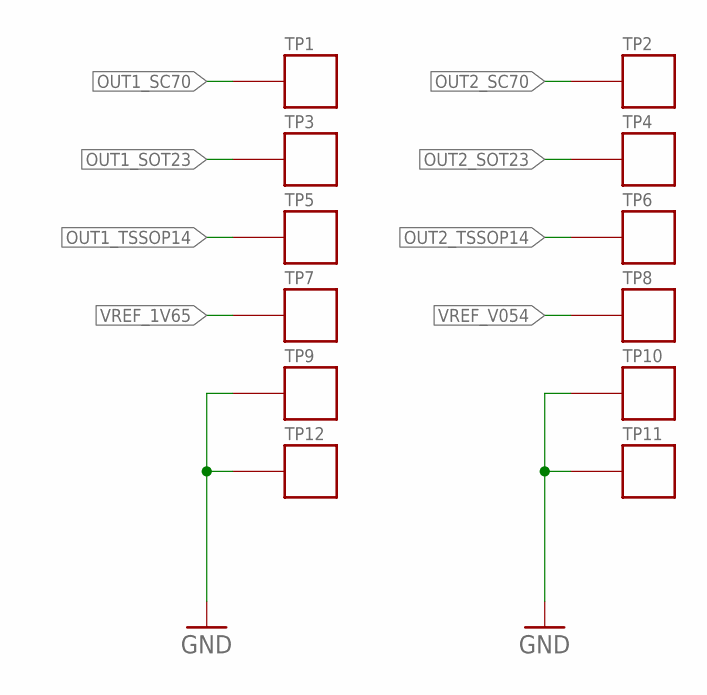
[picture p52: schematic inductor_test_2v0.sch, sheet 5, Test Points]

Parts:
TP1, TP2: TP_MULT; DIGIKEY 36-5126-ND
TP3, TP4: TP_MULT; DIGIKEY 36-5128-ND
TP5, TP6: TP_MULT; DIGIKEY 36-5014-ND
TP7, TP8: TP_MULT; DIGIKEY 36-5010-ND
TP9, TP10, TP11, TP12: TP_MULT; DIGIKEY 36-5011-ND

Connections:
GND: TP9.P$1, TP10.P$1, TP11.P$1, TP12.P$1; also elsewhere on the board
OUT1_SC70: TP1.P$1; also elsewhere on the board
OUT1_SOT23: TP3.P$1; also elsewhere on the board
OUT1_TSSOP14: TP5.P$1; also elsewhere on the board
OUT2_SC70: TP2.P$1; also elsewhere on the board
OUT2_SOT23: TP4.P$1; also elsewhere on the board
OUT2_TSSOP14: TP6.P$1; also elsewhere on the board
VREF_1V65: TP7.P$1; also elsewhere on the board
VREF_V054: TP8.P$1; also elsewhere on the board

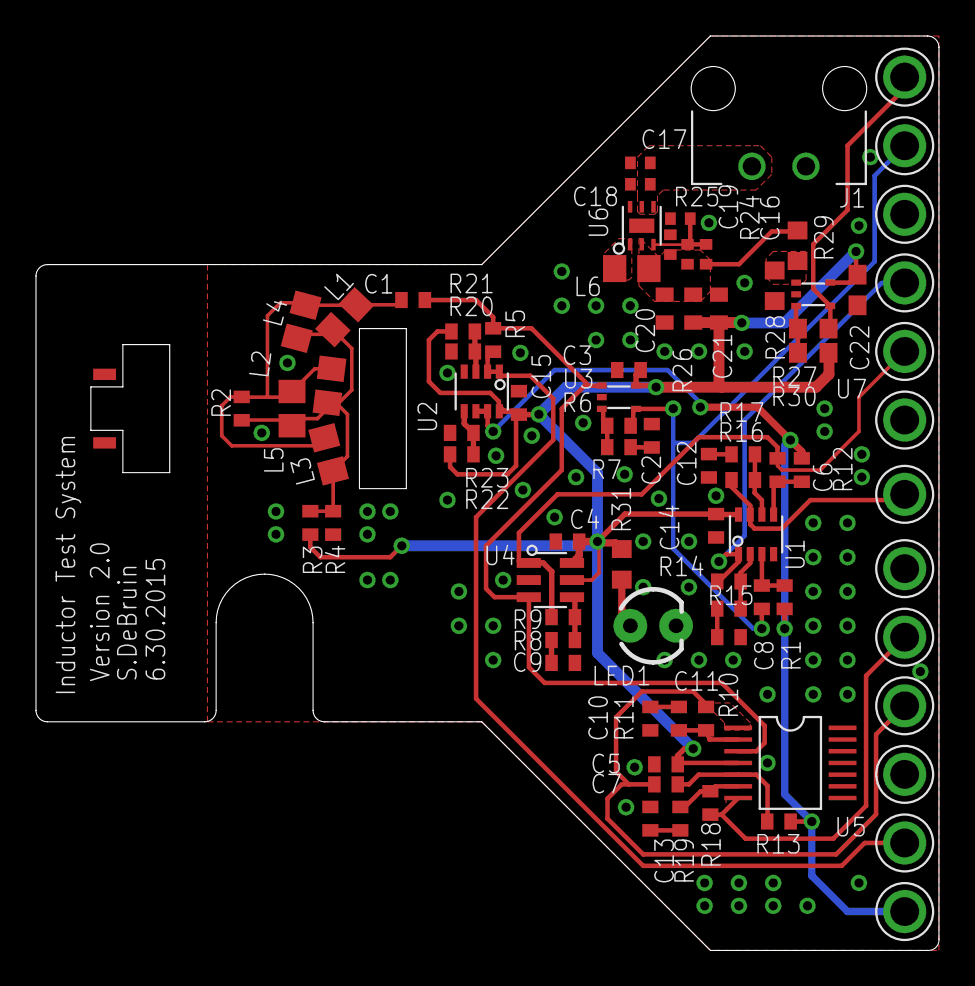
[picture p53: board inductor_test_2v0.brd from above]

Board: 2 copper layers, 50.2 x 50.8 mm, 82 parts (0 on the bottom side), 38 nets.

Other parts of the board:
U$2: NEMA_F2
