lab11/powerblade/eagle/inductor_test/past_rev/inductor_test_1v0.brd

## EAGLE design eagle/inductor_test/past_rev/inductor_test_1v0.brd (2014-11-19)

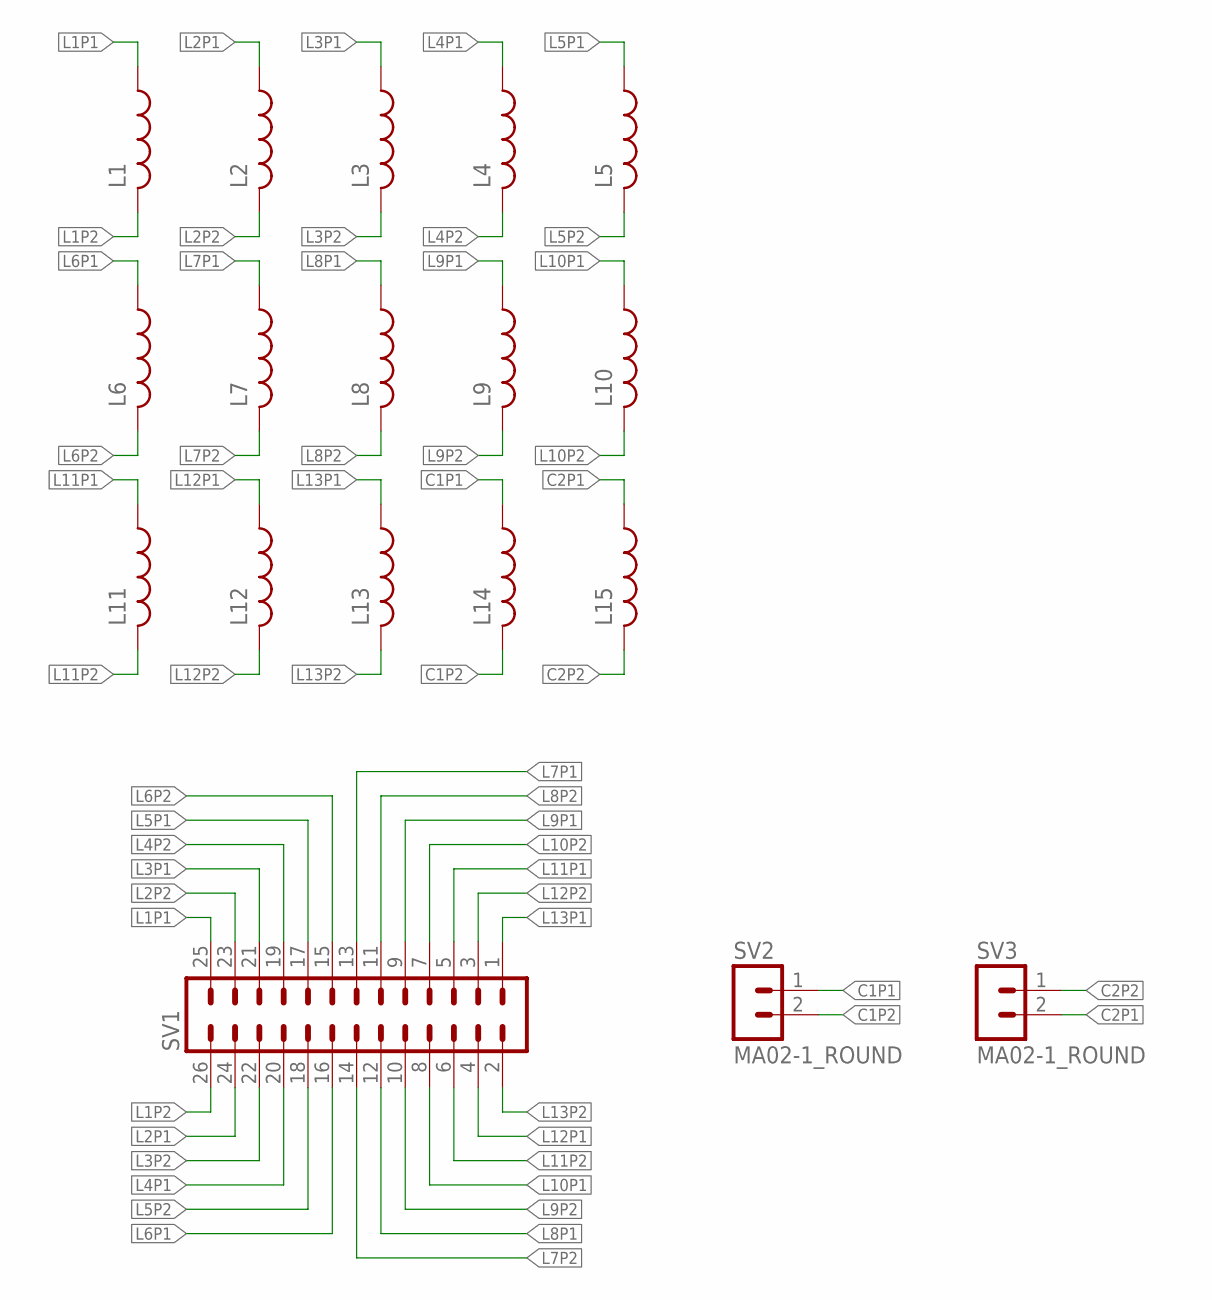
[picture p54: schematic inductor_test_1v0.sch, sheet 1]

Parts:
L1, L2, L3, L4, L5, L6, L7, L8, L9, L10, L11, L12, L13, L14, L15: L-USL0805; L0805
SV1: MA13-2BARE; MA13-2_BARE; DIGIKEY 3M9464-ND
SV2, SV3: MA02-1_ROUND; DIGIKEY NP

Connections:
C1P1: L14.1, SV2.1
C1P2: L14.2, SV2.2
C2P1: L15.1, SV3.2
C2P2: L15.2, SV3.1
L1P1: L1.1, SV1.25
L1P2: L1.2, SV1.26
L2P1: L2.1, SV1.24
L2P2: L2.2, SV1.23
L3P1: L3.1, SV1.21
L3P2: L3.2, SV1.22
L4P1: L4.1, SV1.20
L4P2: L4.2, SV1.19
L5P1: L5.1, SV1.17
L5P2: L5.2, SV1.18
L6P1: L6.1, SV1.16
L6P2: L6.2, SV1.15
L7P1: L7.1, SV1.13
L7P2: L7.2, SV1.14
L8P1: L8.1, SV1.12
L8P2: L8.2, SV1.11
L9P1: L9.1, SV1.9
L9P2: L9.2, SV1.10
L10P1: L10.1, SV1.8
L10P2: L10.2, SV1.7
L11P1: L11.1, SV1.5
L11P2: L11.2, SV1.6
L12P1: L12.1, SV1.4
L12P2: L12.2, SV1.3
L13P1: L13.1, SV1.1
L13P2: L13.2, SV1.2

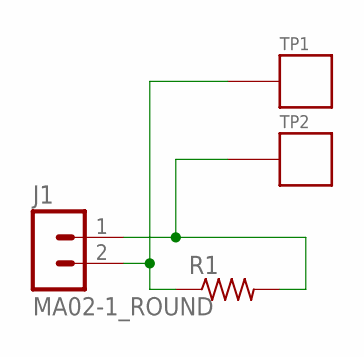
[picture p55: schematic inductor_test_1v0.sch, sheet 2]

Parts:
J1: MA02-1_ROUND; DIGIKEY NP
R1: R-US_R0603; R0603; DIGIKEY P49.9HCT-ND
TP1, TP2: TP_STD; TP; DIGIKEY NP

Connections:
unnamed: J1.2, R1.1, TP1.P$1
unnamed: J1.1, R1.2, TP2.P$1

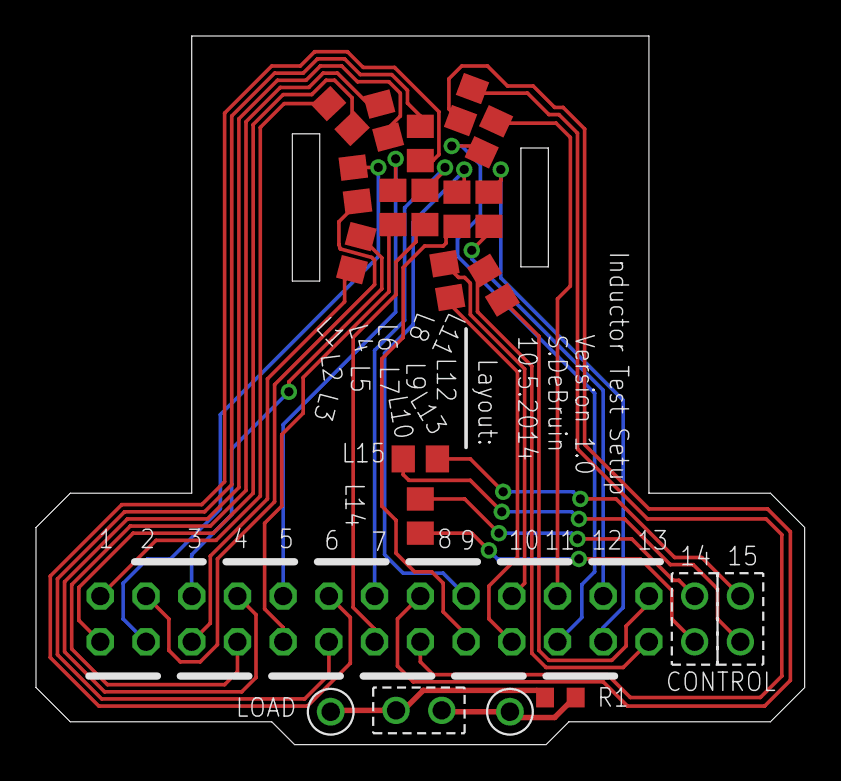
[picture p56: board inductor_test_1v0.brd from above]

Board: 2 copper layers, 42.7 x 39.4 mm, 23 parts (0 on the bottom side), 32 nets.

Other parts of the board:
U$1: NEMA_1-15_TIGHT
