lab11/powerblade/eagle/debug_adapter/pb_debug.brd

## EAGLE design eagle/debug_adapter/pb_debug.brd (2015-06-28)

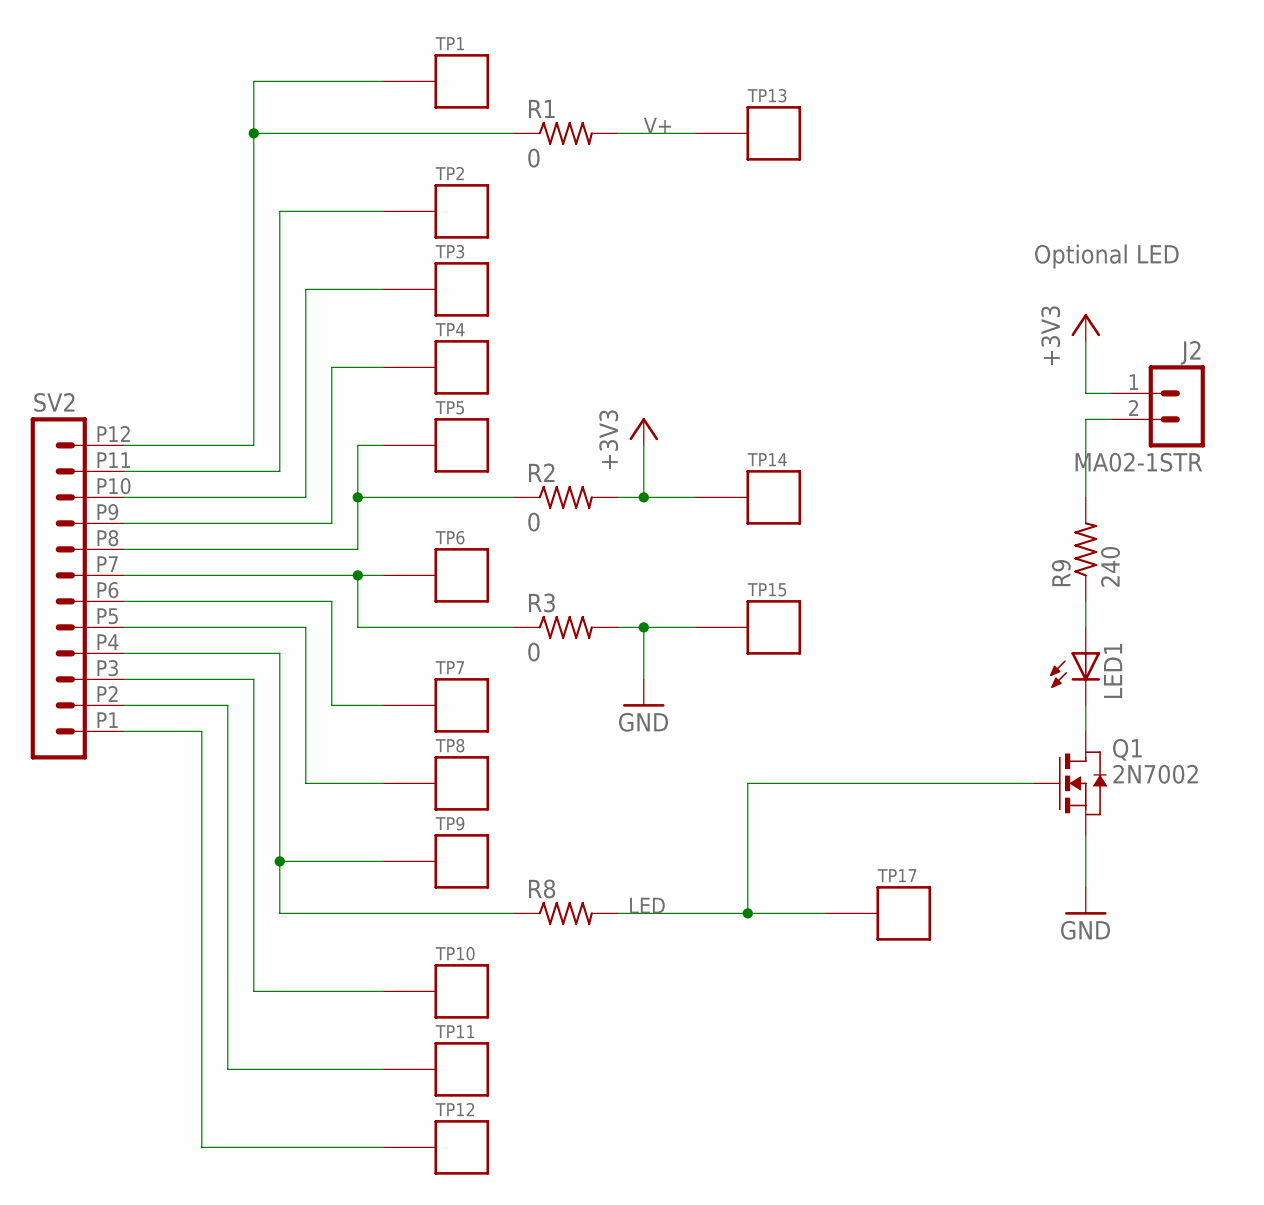
[picture p57: schematic pb_debug.sch, sheet 1, 12-pin 1.27mm Connector]

Parts:
J2: MA02-1STR; MA02-1
LED1: LED0603; LED-0603
Q1: 2N7002; SC-70-3
R1, R2, R3: 0; R0603
R8: R-US_R0603; R0603
R9: 240; R0603
SV2: MA12-11MM27_LONG; MA12-1_1MM27_LONG
TP1, TP2, TP3, TP4, TP5, TP6, TP7, TP8, TP9, TP10, TP11, TP12: TP_MULT
TP13, TP14, TP15, TP17: TP_STD; TP

Connections:
+3V3: J2.1, R2.2, TP14.P$1; also elsewhere on the board
GND: Q1.P2 (S), R3.2, TP15.P$1; also elsewhere on the board
LED: Q1.P1 (G), R8.2, TP17.P$1
unnamed: R1.1, SV2.P12 (12), TP1.P$1
unnamed: SV2.P11 (11), TP2.P$1
unnamed: SV2.P10 (10), TP3.P$1
unnamed: SV2.P9 (9), TP4.P$1
unnamed: R2.1, SV2.P8 (8), TP5.P$1
unnamed: R3.1, SV2.P7 (7), TP6.P$1
unnamed: SV2.P6 (6), TP7.P$1
unnamed: SV2.P5 (5), TP8.P$1
unnamed: R8.1, SV2.P4 (4), TP9.P$1
unnamed: SV2.P3 (3), TP10.P$1
unnamed: SV2.P2 (2), TP11.P$1
unnamed: SV2.P1 (1), TP12.P$1
unnamed: LED1.C, Q1.P3 (D)
unnamed: LED1.A, R9.1
unnamed: J2.2, R9.2
V+: R1.2, TP13.P$1; also elsewhere on the board

Notes on the sheet:
Optional LED

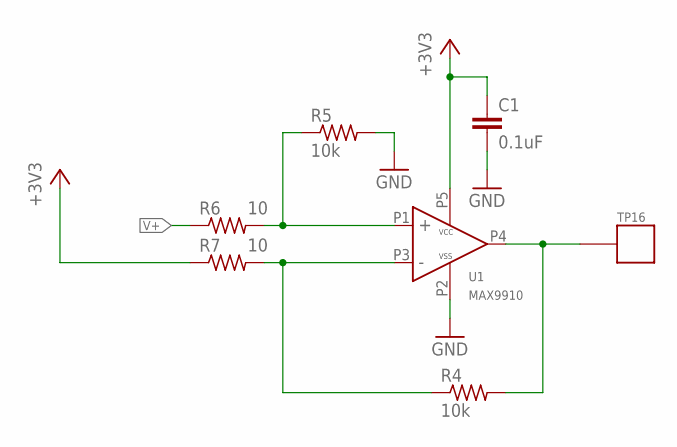
[picture p58: schematic pb_debug.sch, sheet 2, V+ Amplifier]

Parts:
C1: 0.1uF; C0603
R4, R5: 10k; R0603
R6, R7: 10; R0603
TP16: TP_MULT
U1: MAX9910; SC70-5

Connections:
+3V3: C1.1, R7.1, U1.P5 (VCC); also elsewhere on the board
GND: C1.2, R5.2, U1.P2 (VSS); also elsewhere on the board
unnamed: R5.1, R6.2, U1.P1 (IN+)
unnamed: R4.1, R7.2, U1.P3 (IN-)
unnamed: R4.2, TP16.P$1, U1.P4 (OUT)
V+: R6.1; also elsewhere on the board

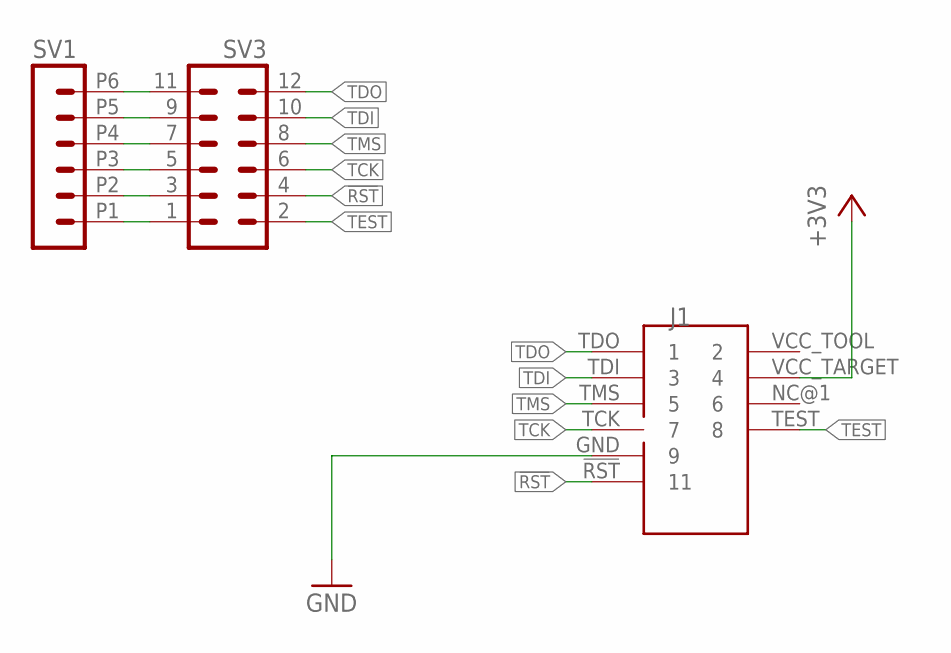
[picture p59: schematic pb_debug.sch, sheet 3, Programmer (future proofing)]

Parts:
J1: JTAG_14PIN_FULL; MA14-JTAG
SV1: MA06-11MM27_LONG; MA06-1_1MM27_LONG
SV3: MA06-2

Connections:
!RST!: J1.!RST! (11), SV3.4
+3V3: J1.VCC_TARGET (4); also elsewhere on the board
GND: J1.GND (9); also elsewhere on the board
unnamed: SV1.P6 (6), SV3.11
unnamed: SV1.P5 (5), SV3.9
unnamed: SV1.P4 (4), SV3.7
unnamed: SV1.P3 (3), SV3.5
unnamed: SV1.P2 (2), SV3.3
unnamed: SV1.P1 (1), SV3.1
TCK: J1.TCK (7), SV3.6
TDI: J1.TDI (3), SV3.10
TDO: J1.TDO (1), SV3.12
TEST: J1.TEST (8), SV3.2
TMS: J1.TMS (5), SV3.8

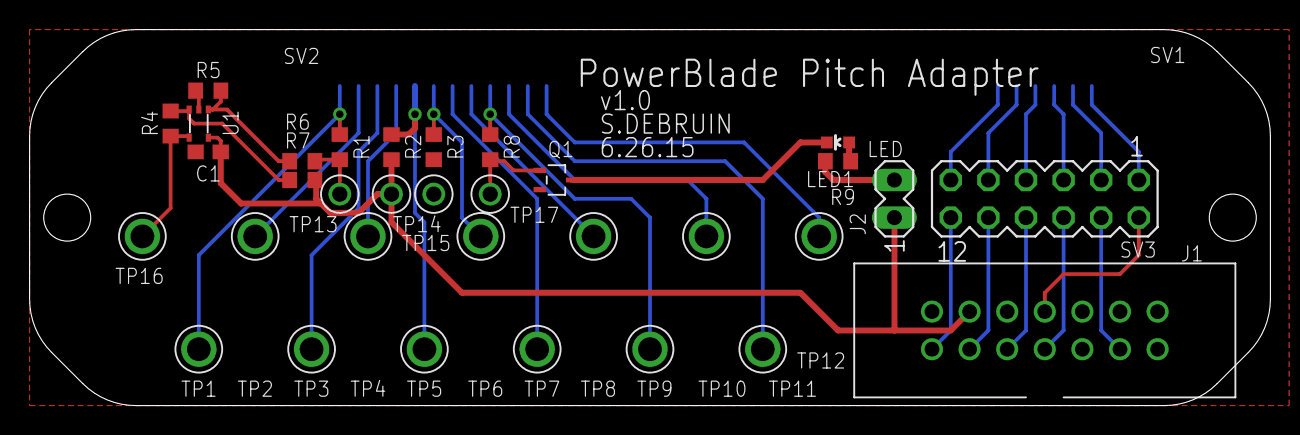
[picture p60: board pb_debug.brd from above]

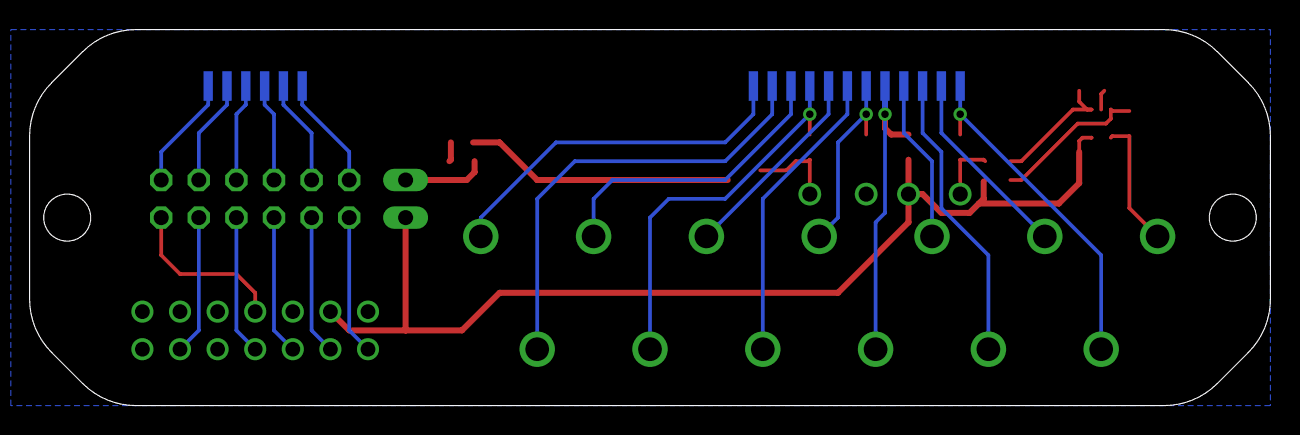
[picture p61: board pb_debug.brd from below]

Board: 2 copper layers, 83.8 x 25.4 mm, 35 parts (2 on the bottom side), 34 nets.
