lab11/powerblade/eagle/powerblade/past_rev/3v0/powerblade_test.brd

## EAGLE design eagle/powerblade/past_rev/3v0/powerblade_test.brd (2015-05-24)

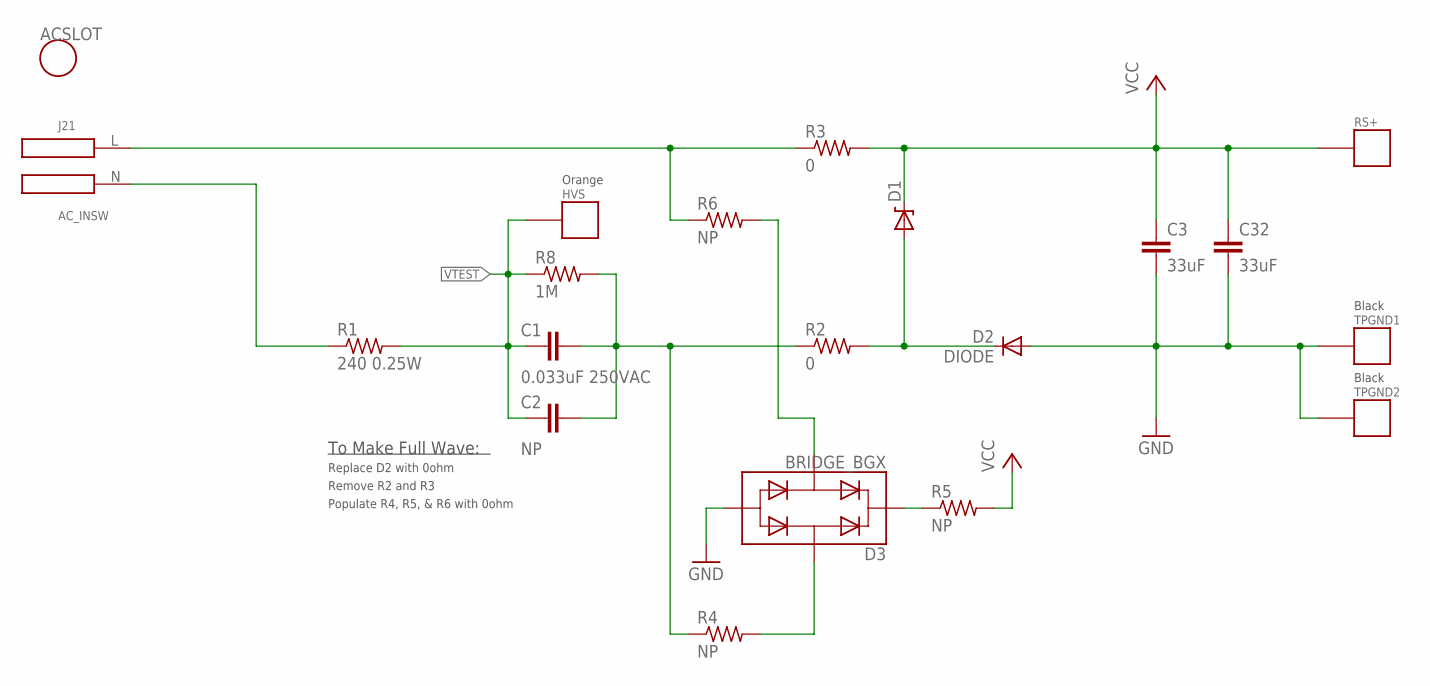
[picture p62: schematic powerblade_test.sch, sheet 1, AC-DC Power Supply]

Parts:
ACSLOT: AC_NODIM; AC3_NODIM; DIGIKEY NP
C1: 0.033uF 250VAC; C2220K; DIGIKEY 490-5919-1-ND
C2: NP; C2220K; DIGIKEY NP
C3, C32: 33uF; C0603; DIGIKEY 718-1672-1-ND
D1: ZENERBZT52; BZT52; DIGIKEY NP
D2: DIODE; BAS521; DIGIKEY NP
D3: BRIDGE_BGX; TO-253-4; DIGIKEY NP
HVS: TP_MULT; DIGIKEY 5013K-ND
J21: AC_INSW; AC_DC21; DIGIKEY NP
R1: 240 0.25W; R0603; DIGIKEY RHM240DCT-ND
R2, R3: 0; R0603; DIGIKEY P0.0GCT-ND
R4, R5, R6: NP; R0603; DIGIKEY NP
R8: 1M; R0603; DIGIKEY MCT0603-1.00M-CFCT-ND
RS+: TP_MULT; DIGIKEY 5014K-ND
TPGND1, TPGND2: TP_MULT; DIGIKEY 5011K-ND

Connections:
GND: C3.2, C32.2, D2.A, D3.P3, TPGND1.P$1, TPGND2.P$1; also elsewhere on the board
N: J21.N, R1.1
unnamed: D1.A, D2.C, R2.2
unnamed: C1.1, C2.1, R2.1, R4.1, R8.2
unnamed: D3.P4, R4.2
unnamed: D3.P1, R5.1
unnamed: D3.P2, R6.2
P: J21.L, R3.1, R6.1
VCC: C3.1, C32.1, D1.C, R3.2, R5.2, RS+.P$1; also elsewhere on the board
VTEST: C1.2, C2.2, HVS.P$1, R1.2, R8.1; also elsewhere on the board

Notes on the sheet:
To Make Full Wave:
Replace D2 with 0ohm
Remove R2 and R3
Populate R4, R5, & R6 with 0ohm
Orange
Black

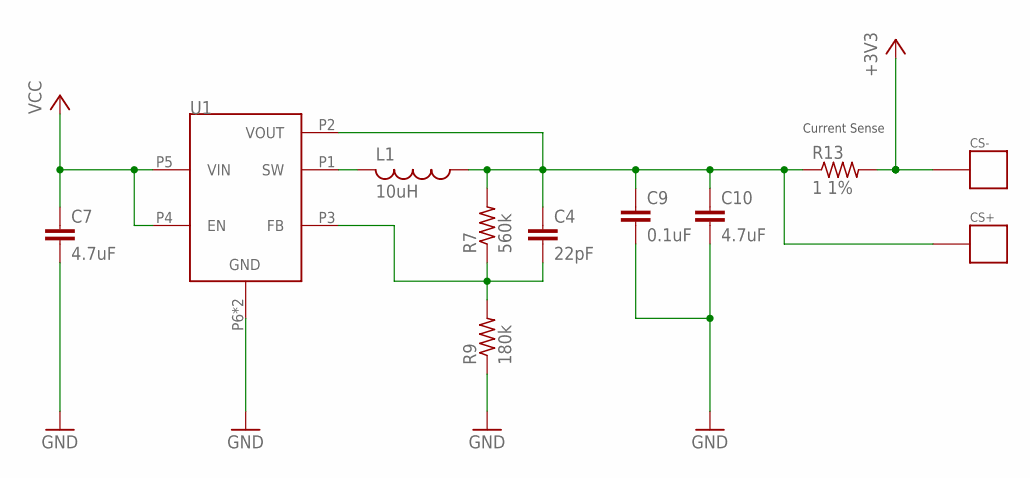
[picture p63: schematic powerblade_test.sch, sheet 2, Load Supply Regulation]

Parts:
C4: 22pF; C0402; DIGIKEY 1276-1116-1-ND
C7: 4.7uF; C0603; DIGIKEY 1276-1784-1-ND
C9: 0.1uF; C0402; DIGIKEY 1276-1001-1-ND
C10: 4.7uF; C0402; DIGIKEY 490-5915-1-ND
CS+: TP_MULT; DIGIKEY 5012K-ND
CS-: TP_MULT; DIGIKEY 5010K-ND
L1: 10uH; L0805; DIGIKEY 490-4990-1-ND
R7: 560k; R0402; DIGIKEY P560KLCT-ND
R9: 180k; R0402; DIGIKEY P180KLCT-ND
R13: 1 1%; R0603; DIGIKEY P1.0AJCT-ND
U1: TPS62122; WDFN-6

Connections:
+3V3: CS-.P$1, R13.2; also elsewhere on the board
GND: C7.2, C9.2, C10.2, R9.1, U1.P6 (GND), U1.PAD (GND); also elsewhere on the board
unnamed: L1.2, U1.P1 (SW)
unnamed: C4.1, C9.1, C10.1, CS+.P$1, L1.1, R7.2, R13.1, U1.P2 (VOUT)
unnamed: C4.2, R7.1, R9.2, U1.P3 (FB)
VCC: C7.1, U1.P4 (EN), U1.P5 (VIN); also elsewhere on the board

Notes on the sheet:
Current Sense

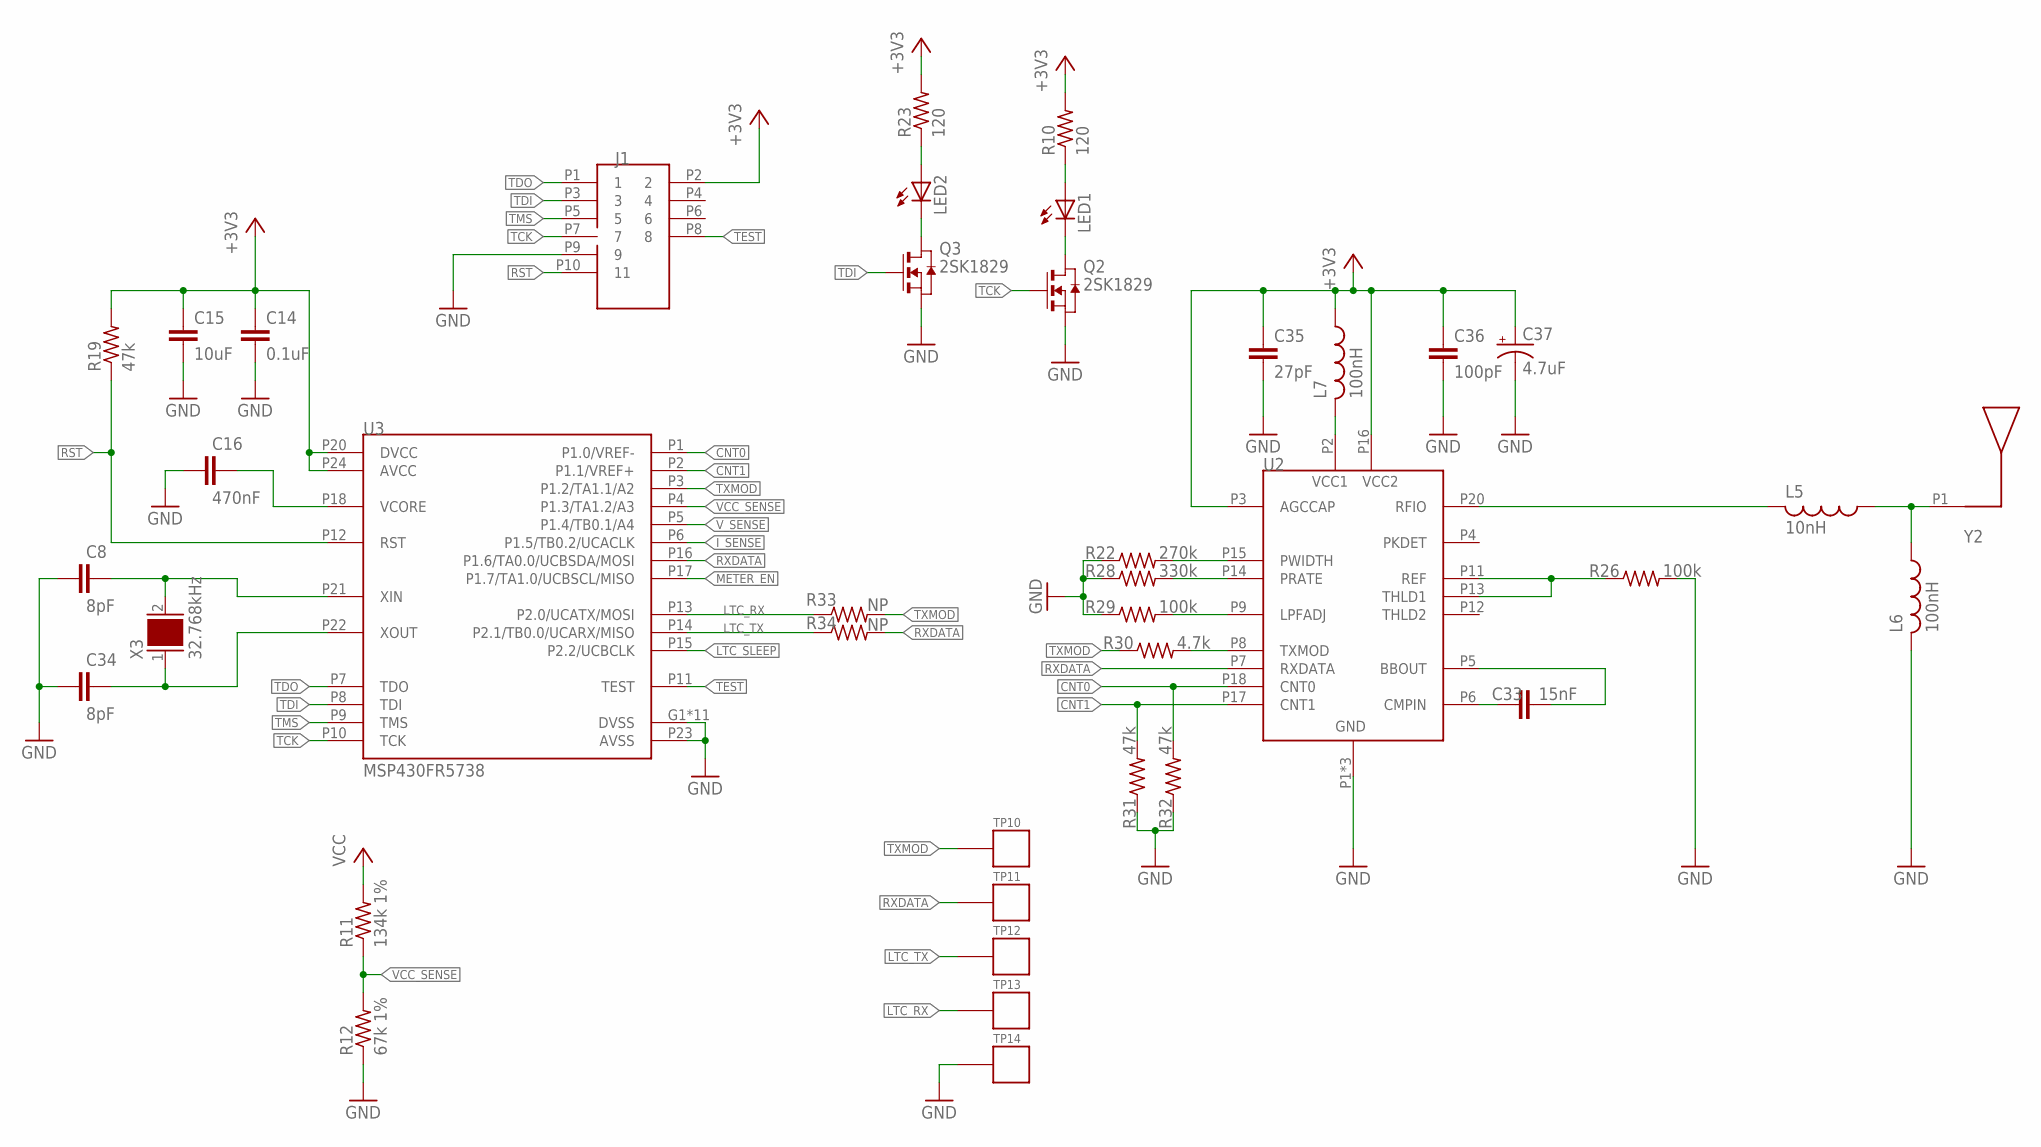
[picture p64: schematic powerblade_test.sch, sheet 3, Load 1: TR1000]

Parts:
C8, C34: 8pF; C0603; DIGIKEY 1276-1817-1-ND
C14: 0.1uF; C0603; DIGIKEY 445-1316-1-ND
C15: 10uF; C0603; DIGIKEY 1276-1119-1-ND
C16: 470nF; C0603; DIGIKEY 445-5192-1-ND
C33: 15nF; C0603; DIGIKEY 445-5091-1-ND
C35: 27pF; C0603; DIGIKEY 445-1274-1-ND
C36: 100pF; C0603; DIGIKEY 445-1281-1-ND
C37: 4.7uF; CPOL-0805; DIGIKEY 478-8120-1-ND
J1: JTAG_14PIN_IDC; TC2050-IDC-430; DIGIKEY NP
L5: 10nH; L0402; DIGIKEY 732-2924-1-ND
L6: 100nH; L0402; DIGIKEY CW100505-R10JCT-ND
L7: 100nH; L0603; DIGIKEY 587-1566-1-ND
LED1, LED2: LED0603; LED-0603; DIGIKEY 160-1183-1-ND
Q2, Q3: 2SK1829; SC-70-3
R10, R23: 120; R0603; DIGIKEY P120GCT-ND
R11: 134k 1%; R0603; DIGIKEY P133KHCT-ND
R12: 67k 1%; R0603; DIGIKEY P66.5KHCT-ND
R19, R31, R32: 47k; R0603; DIGIKEY P47KGCT-ND
R22: 270k; R0603; DIGIKEY P270KGCT-ND
R26, R29: 100k; R0603; DIGIKEY P100KGCT-ND
R28: 330k; R0603; DIGIKEY P330KGCT-ND
R30: 4.7k; R0603; DIGIKEY P4.7KGCT-ND
R33, R34: NP; R0603; DIGIKEY NP
TP10, TP11, TP12, TP13, TP14: TP_STD; TP; DIGIKEY NP
U2: TR1000; SM-20H
U3: MSP430FR5738; VQFN-24
X3: 32.768kHz; 0805; DIGIKEY 535-12373-1-ND
Y2: ANT-916

Connections:
+3V3: C14.1, C15.1, C35.1, C36.1, C37.+, J1.P2 (2), L7.1, R10.2, R19.2, R23.2, U2.P3 (AGCCAP), U2.P16 (VCC2), U3.P20 (DVCC), U3.P24 (AVCC); also elsewhere on the board
CNT0: R32.2, U2.P18 (CNT0), U3.P1 (P1.0/VREF-)
CNT1: R31.2, U2.P17 (CNT1), U3.P2 (P1.1/VREF+)
GND: C8.1, C14.2, C15.2, C16.1, C34.1, C35.2, C36.2, C37.-, J1.P9 (9), L6.2, Q2.P2 (S), Q3.P2 (S), R12.1, R22.1, R26.2, R28.1, R29.1, R31.1, R32.1, TP14.P$1, U2.P1 (GND), U2.P10 (GND), U2.P19 (GND), U3.G1 (DVSS), U3.G2 (DVSS), U3.G3 (DVSS), U3.G4 (DVSS), U3.G5 (DVSS), U3.G6 (DVSS), U3.G7 (DVSS), U3.G8 (DVSS), U3.G9 (DVSS), U3.P19 (DVSS), U3.P23 (AVSS), U3.PAD (DVSS); also elsewhere on the board
I_SENSE: U3.P6 (P1.5/TB0.2/UCACLK); also elsewhere on the board
LTC_RX: R33.1, TP13.P$1, U3.P13 (P2.0/UCATX/MOSI); also elsewhere on the board
LTC_SLEEP: U3.P15 (P2.2/UCBCLK); also elsewhere on the board
LTC_TX: R34.1, TP12.P$1, U3.P14 (P2.1/TB0.0/UCARX/MISO); also elsewhere on the board
METER_EN: U3.P17 (P1.7/TA1.0/UCBSCL/MISO); also elsewhere on the board
unnamed: C34.2, U3.P22 (XOUT), X3.1
unnamed: C33.2, U2.P5 (BBOUT)
unnamed: L7.2, U2.P2 (VCC1)
unnamed: C16.2, U3.P18 (VCORE)
unnamed: LED1.A, R10.1
unnamed: R22.2, U2.P15 (PWIDTH)
unnamed: R28.2, U2.P14 (PRATE)
unnamed: R29.2, U2.P9 (LPFADJ)
unnamed: R30.2, U2.P8 (TXMOD)
unnamed: LED1.C, Q2.P3 (D)
unnamed: C33.1, U2.P6 (CMPIN)
unnamed: C8.2, U3.P21 (XIN), X3.2
unnamed: R26.1, U2.P11 (REF), U2.P13 (THLD1)
unnamed: LED2.A, R23.1
unnamed: LED2.C, Q3.P3 (D)
unnamed: L5.2, U2.P20 (RFIO)
unnamed: L5.1, L6.1, Y2.P1
RST: J1.P10 (11), R19.1, U3.P12 (RST)
RXDATA: R34.2, TP11.P$1, U2.P7 (RXDATA), U3.P16 (P1.6/TA0.0/UCBSDA/MOSI)
TCK: J1.P7 (7), Q2.P1 (G), U3.P10 (TCK)
TDI: J1.P3 (3), Q3.P1 (G), U3.P8 (TDI)
TDO: J1.P1 (1), U3.P7 (TDO)
TEST: J1.P8 (8), U3.P11 (TEST)
TMS: J1.P5 (5), U3.P9 (TMS)
TXMOD: R30.1, R33.2, TP10.P$1, U3.P3 (P1.2/TA1.1/A2)
VCC: R11.2; also elsewhere on the board
VCC_SENSE: R11.1, R12.2, U3.P4 (P1.3/TA1.2/A3)
V_SENSE: U3.P5 (P1.4/TB0.1/A4); also elsewhere on the board

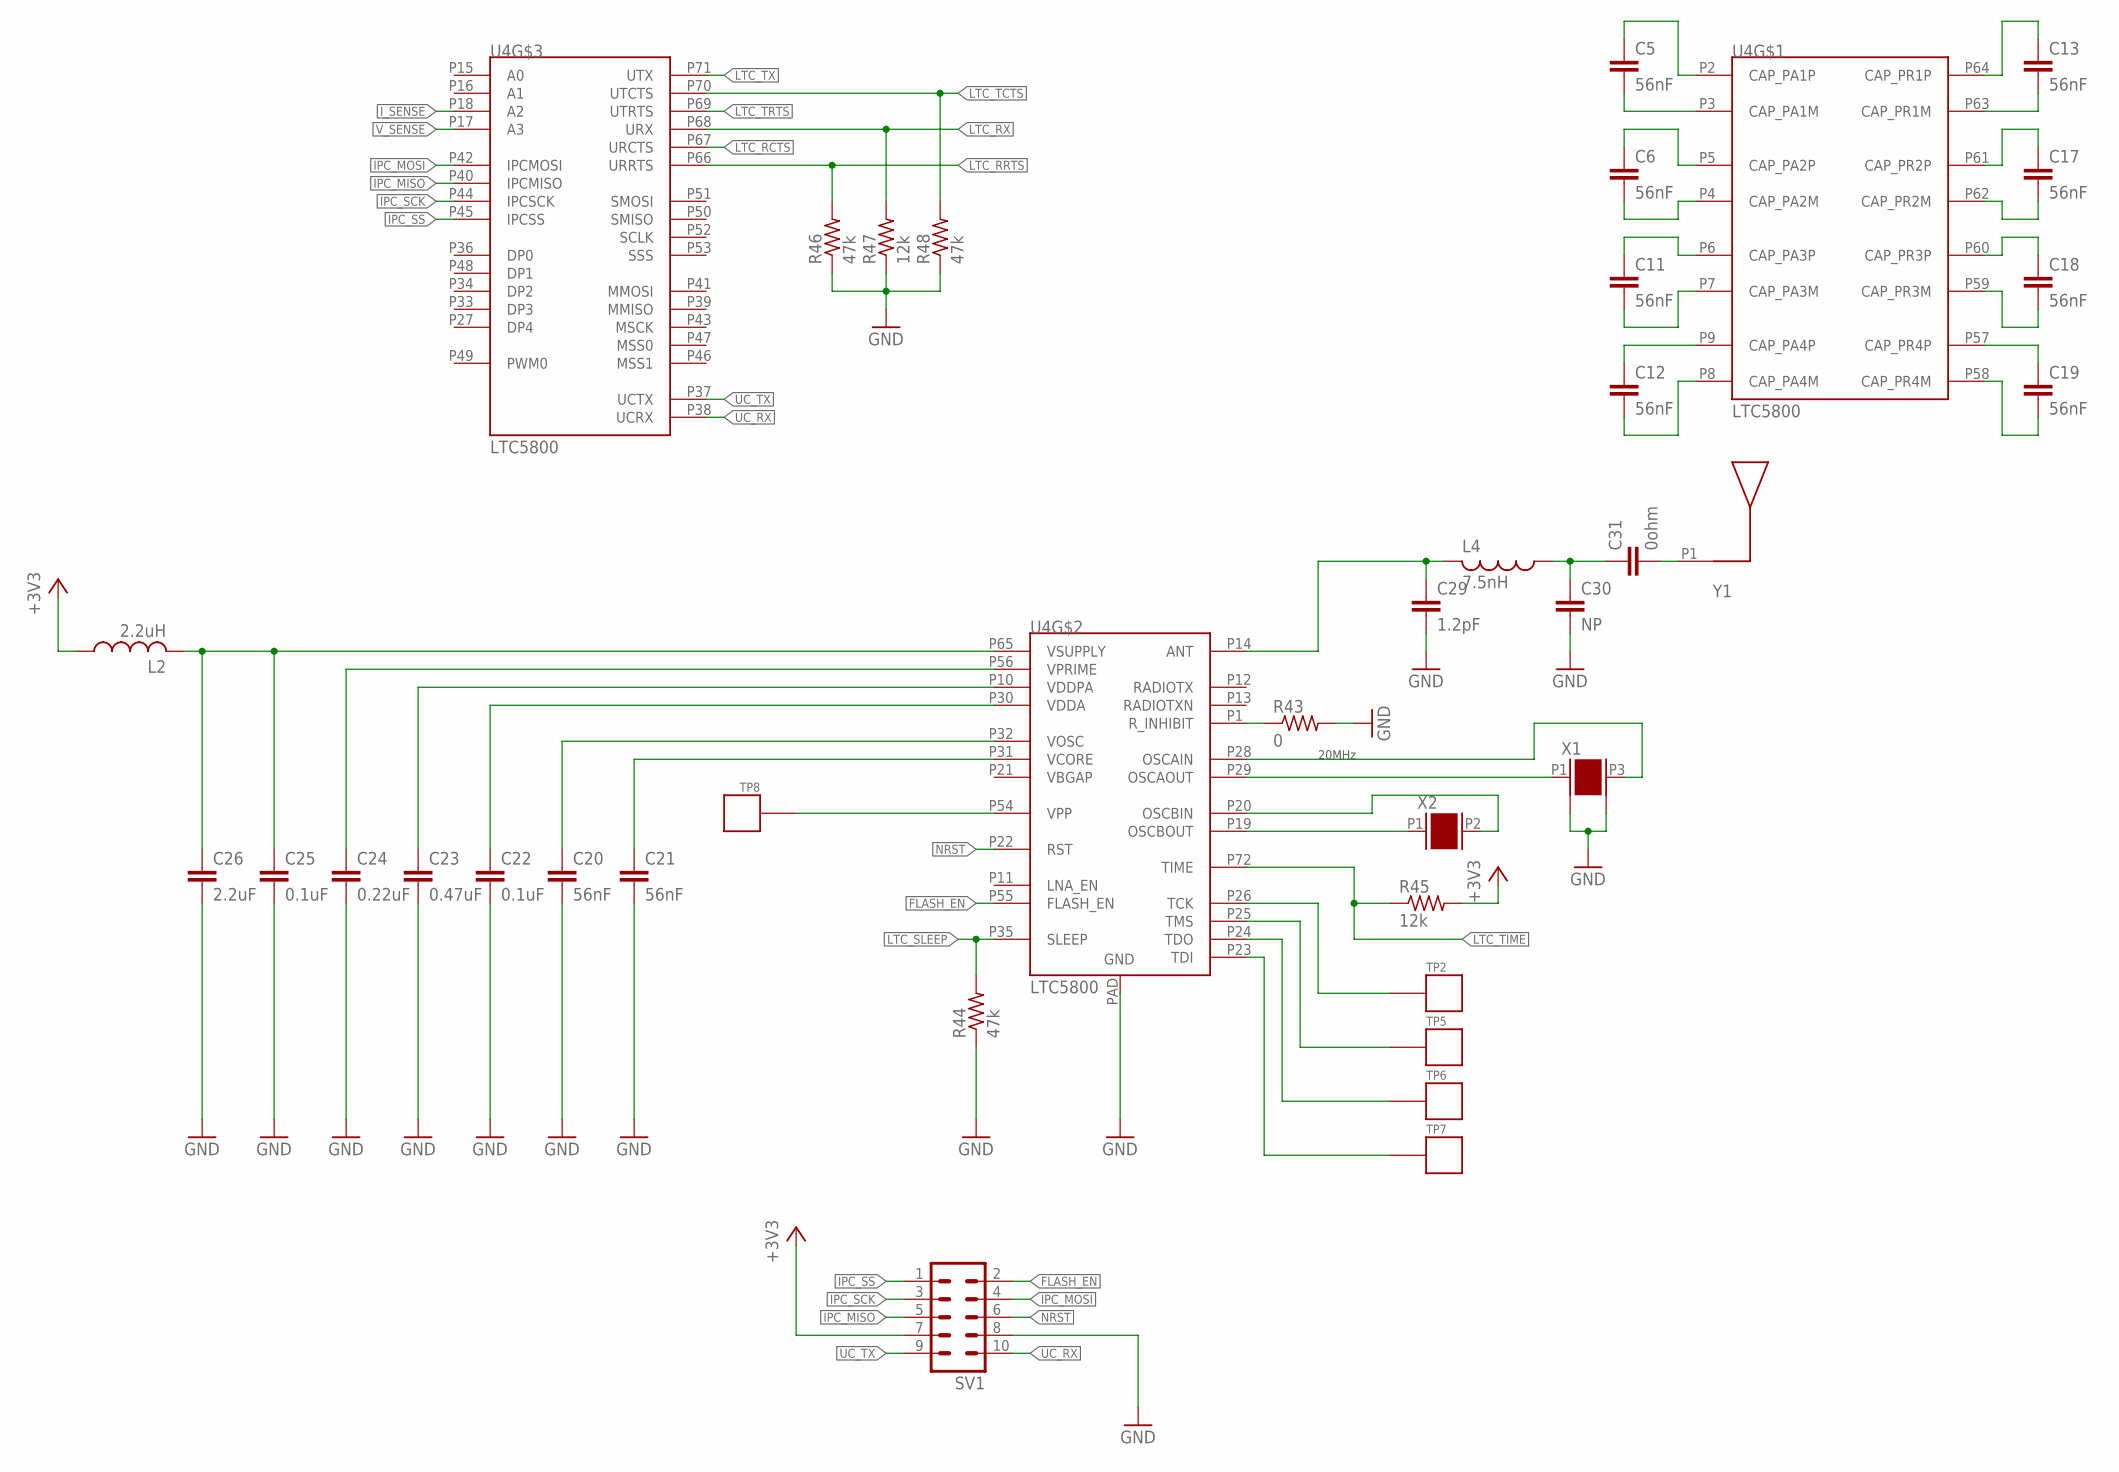
[picture p65: schematic powerblade_test.sch, sheet 4, Load 2: LTC5800]

Parts:
C5, C6, C11, C12, C13, C17, C18, C19, C20, C21: 56nF; C0402; DIGIKEY 490-6324-1-ND
C22, C25: 0.1uF; C0603; DIGIKEY 445-1316-1-ND
C23: 0.47uF; C0603; DIGIKEY 1276-2377-1-ND
C24: 0.22uF; C0603; DIGIKEY 445-1318-1-ND
C26: 2.2uF; C0603; DIGIKEY 1276-2368-1-ND
C29: 1.2pF; C0402; DIGIKEY 490-6209-1-ND
C30: NP; C0402; DIGIKEY NP
C31: 0ohm; C0402; DIGIKEY P0.0JCT-ND
L2: 2.2uH; L0603; DIGIKEY 490-4023-1-ND
L4: 7.5nH; L0402; DIGIKEY 490-6760-1-ND
R43: 0; R0402; DIGIKEY P0.0JCT-ND
R44, R46, R48: 47k; R0402; DIGIKEY P47KJCT-ND
R45, R47: 12k; R0402; DIGIKEY P12KJCT-ND
SV1: MA05-2KEY; MA05-2_KEY
TP2, TP5, TP6, TP7: TP_SMD; DIGIKEY NP
TP8: TP_STD; TP; DIGIKEY NP
U4: LTC5800; QFN-72
X1: ABM8G
X2: ABS07
Y1: UREACH_XTEND

Connections:
+3V3: L2.1, R45.2, SV1.7; also elsewhere on the board
FLASH_EN: SV1.2, U4.P55 (FLASH_EN)
GND: C20.2, C21.2, C22.2, C23.2, C24.2, C25.2, C26.2, C29.2, C30.2, R43.2, R44.1, R46.1, R47.1, R48.1, SV1.8, U4.PAD (GND), X1.P2 (G1), X1.P4 (G2); also elsewhere on the board
IPC_MISO: SV1.5, U4.P40 (IPCMISO)
IPC_MOSI: SV1.4, U4.P42 (IPCMOSI)
IPC_SCK: SV1.3, U4.P44 (IPCSCK)
IPC_SS: SV1.1, U4.P45 (IPCSS)
I_SENSE: U4.P18 (A2); also elsewhere on the board
LTC_RCTS: U4.P67 (URCTS)
LTC_RRTS: R46.2, U4.P66 (URRTS)
LTC_RX: R47.2, U4.P68 (URX); also elsewhere on the board
LTC_SLEEP: R44.2, U4.P35 (SLEEP); also elsewhere on the board
LTC_TCTS: R48.2, U4.P70 (UTCTS)
LTC_TIME: R45.1, U4.P72 (TIME)
LTC_TRTS: U4.P69 (UTRTS)
LTC_TX: U4.P71 (UTX); also elsewhere on the board
unnamed: C5.1, U4.P2 (CAP_PA1P)
unnamed: C5.2, U4.P3 (CAP_PA1M)
unnamed: C6.1, U4.P5 (CAP_PA2P)
unnamed: C6.2, U4.P4 (CAP_PA2M)
unnamed: C11.1, U4.P6 (CAP_PA3P)
unnamed: C11.2, U4.P7 (CAP_PA3M)
unnamed: C12.1, U4.P9 (CAP_PA4P)
unnamed: C12.2, U4.P8 (CAP_PA4M)
unnamed: C13.1, U4.P64 (CAP_PR1P)
unnamed: C13.2, U4.P63 (CAP_PR1M)
unnamed: C17.1, U4.P61 (CAP_PR2P)
unnamed: C17.2, U4.P62 (CAP_PR2M)
unnamed: C18.1, U4.P60 (CAP_PR3P)
unnamed: C18.2, U4.P59 (CAP_PR3M)
unnamed: C19.1, U4.P57 (CAP_PR4P)
unnamed: C19.2, U4.P58 (CAP_PR4M)
unnamed: C21.1, U4.P31 (VCORE)
unnamed: C20.1, U4.P32 (VOSC)
unnamed: C25.1, C26.1, L2.2, U4.P65 (VSUPPLY)
unnamed: C24.1, U4.P56 (VPRIME)
unnamed: C23.1, U4.P10 (VDDPA)
unnamed: C22.1, U4.P30 (VDDA)
unnamed: U4.P29 (OSCAOUT), X1.P1
unnamed: U4.P28 (OSCAIN), X1.P3 (P2)
unnamed: U4.P20 (OSCBIN), X2.P2
unnamed: U4.P19 (OSCBOUT), X2.P1
unnamed: C29.1, L4.2, U4.P14 (ANT)
unnamed: C30.1, C31.1, L4.1
unnamed: C31.2, Y1.P1
unnamed: TP8.P$1, U4.P54 (VPP)
unnamed: TP7.P$1, U4.P23 (TDI)
unnamed: TP6.P$1, U4.P24 (TDO)
unnamed: TP5.P$1, U4.P25 (TMS)
unnamed: TP2.P$1, U4.P26 (TCK)
unnamed: R43.1, U4.P1 (R_INHIBIT)
NRST: SV1.6, U4.P22 (RST)
UC_RX: SV1.10, U4.P38 (UCRX)
UC_TX: SV1.9, U4.P37 (UCTX)
V_SENSE: U4.P17 (A3); also elsewhere on the board

Notes on the sheet:
20MHz

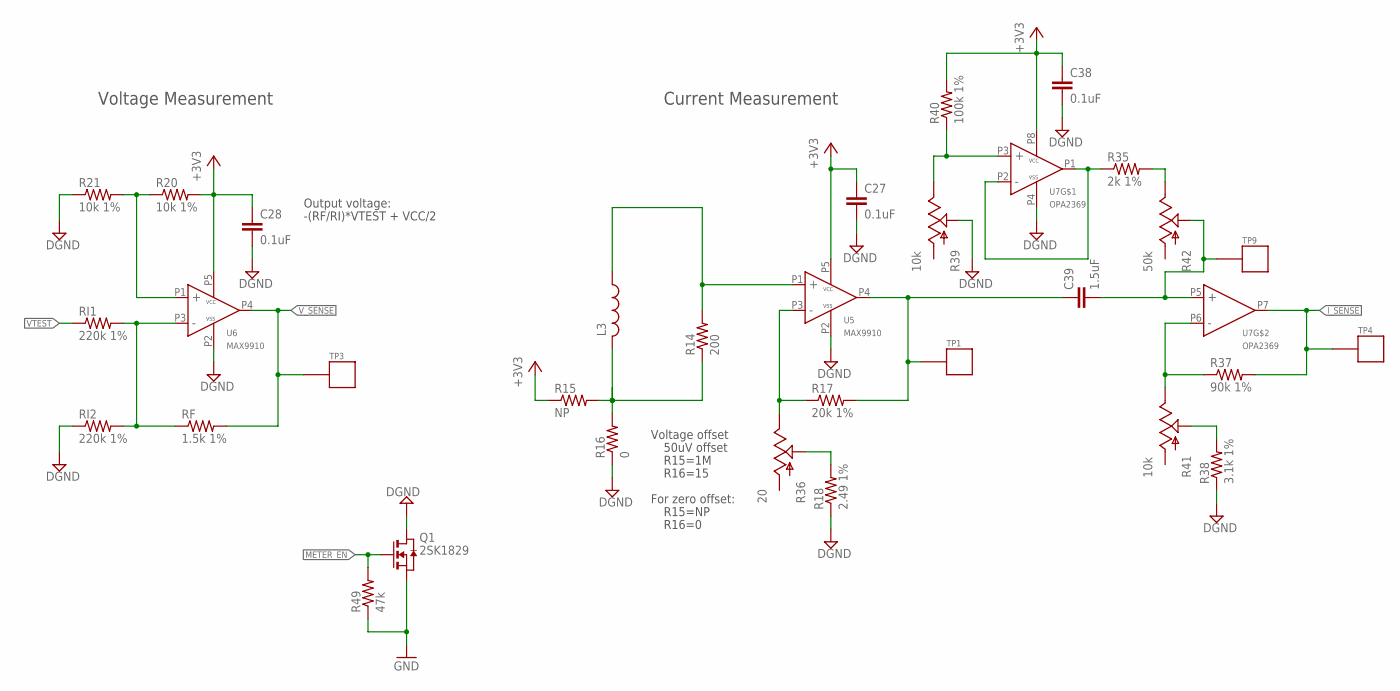
[picture p66: schematic powerblade_test.sch, sheet 5, Power Measurement]

Parts:
C27, C28, C38: 0.1uF; C0402; DIGIKEY 445-1265-1-ND
C39: 1.5uF; C0402; DIGIKEY 445-13874-1-ND
L3: L-USL0805; L0805; DIGIKEY 732-3452-1-ND
Q1: 2SK1829; SC-70-3
R14: 200; R0402; DIGIKEY P200LCT-ND
R15: NP; R0402; DIGIKEY NP
R16: 0; R0402; DIGIKEY P0.0JCT-ND
R17: 20k 1%; R0402; DIGIKEY P20.0KLCT-ND
R18: 2.49 1%; R0402; DIGIKEY 541-2.49LLCT-ND
R20, R21: 10k 1%; R0402; DIGIKEY P10.0KLCT-ND
R35: 2k 1%; R0402; DIGIKEY P2.00KLCT-ND
R36: 20; 3313_POT; DIGIKEY 3313J-1-200ECT-ND
R37: 90k 1%; R0402; DIGIKEY P90.9KLCT-ND
R38: 3.1k 1%; R0603; DIGIKEY P3.09KHCT-ND
R39, R41: 10k; 3313_POT; DIGIKEY 3313J-103ECT-ND
R40: 100k 1%; R0402; DIGIKEY P100KLCT-ND
R42: 50k; 3313_POT; DIGIKEY 3313J-503ECT-ND
R49: 47k; R0603; DIGIKEY P47KGCT-ND
RF: 1.5k 1%; R0402; DIGIKEY P1.50KLCT-ND
RI1, RI2: 220k 1%; R0402; DIGIKEY P220KLCT-ND
TP1, TP4, TP9: TP_MULT; DIGIKEY 5126K-ND
TP3: TP_MULT; DIGIKEY 5129K-ND
U5, U6: MAX9910; SC70-5
U7: OPA2369; SOT-23-8

Connections:
+3V3: C27.1, C28.1, C38.1, R15.1, R20.2, R40.2, U5.P5 (VCC), U6.P5 (VCC), U7.P8 (VCC); also elsewhere on the board
DGND: C27.2, C28.2, C38.2, Q1.P3 (D), R16.1, R18.1, R21.1, R38.1, R39.PW, RI2.1, U5.P2 (VSS), U6.P2 (VSS), U7.P4 (VSS)
GND: Q1.P2 (S), R49.1; also elsewhere on the board
I_SENSE: R37.2, TP4.P$1, U7.P7 (OUT); also elsewhere on the board
METER_EN: Q1.P1 (G), R49.2; also elsewhere on the board
unnamed: L3.2, R14.1, R15.2, R16.2
unnamed: L3.1, R14.2, U5.P1 (IN+)
unnamed: R17.1, R36.P2, U5.P3 (IN-)
unnamed: R20.1, R21.2, U6.P1 (IN+)
unnamed: RF.1, RI1.2, RI2.2, U6.P3 (IN-)
unnamed: C39.1, R17.2, TP1.P$1, U5.P4 (OUT)
unnamed: R18.2, R36.PW
unnamed: R37.1, R41.P2, U7.P6 (IN-)
unnamed: C39.2, R42.PW, TP9.P$1, U7.P5 (IN+)
unnamed: R35.1, U7.P1 (OUT), U7.P2 (IN-)
unnamed: R38.2, R41.PW
unnamed: R39.P2, R40.1, U7.P3 (IN+)
unnamed: R35.2, R42.P2
VTEST: RI1.1; also elsewhere on the board
V_SENSE: RF.2, TP3.P$1, U6.P4 (OUT); also elsewhere on the board

Notes on the sheet:
Voltage offset
50uV offset
For zero offset:
R15=NP
R16=0
Current Measurement
Voltage Measurement
Output voltage:
-(RF/RI)*VTEST + VCC/2
R15=1M
R16=15

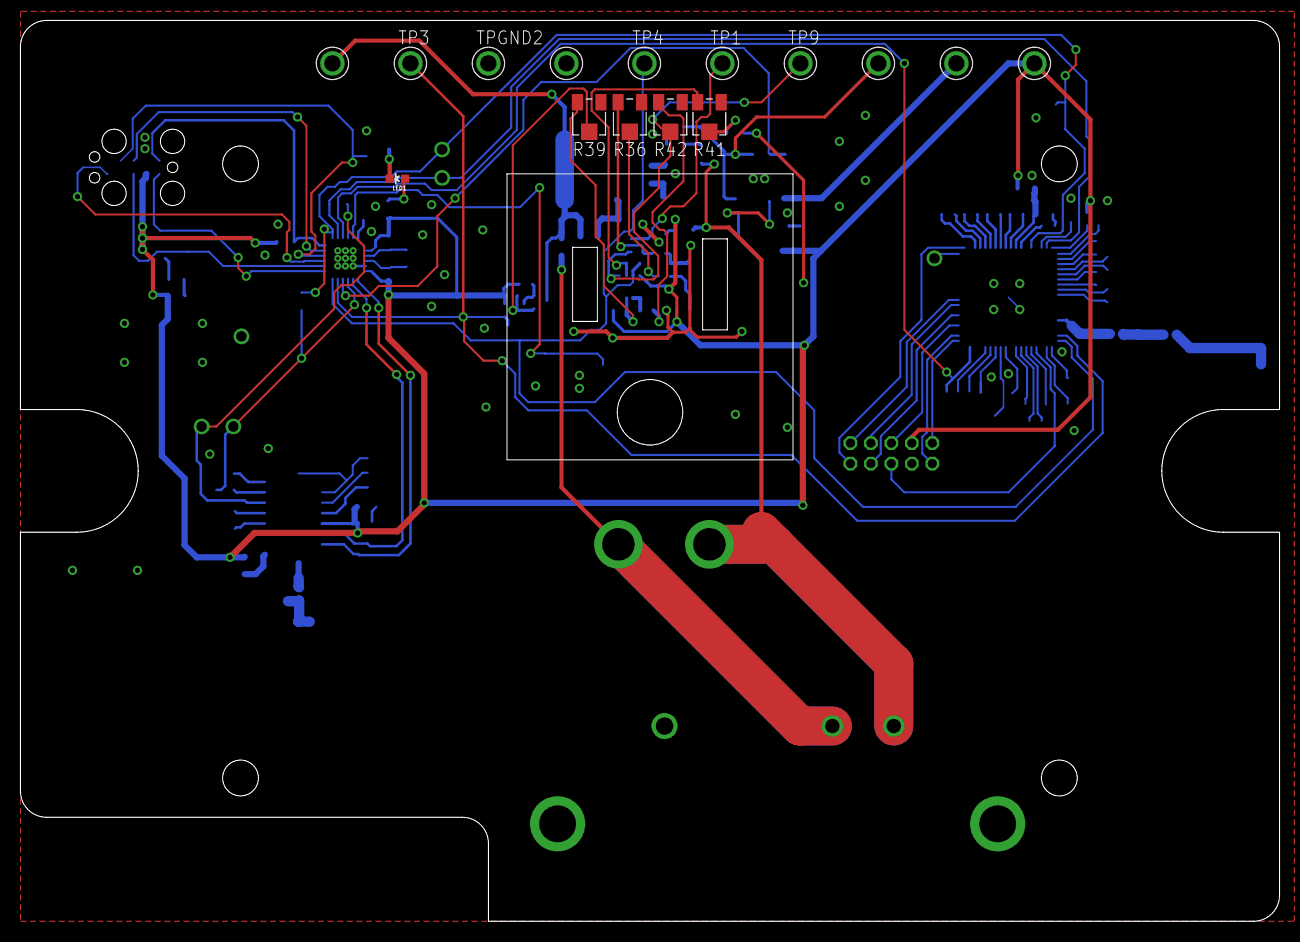
[picture p67: board powerblade_test.brd from above]

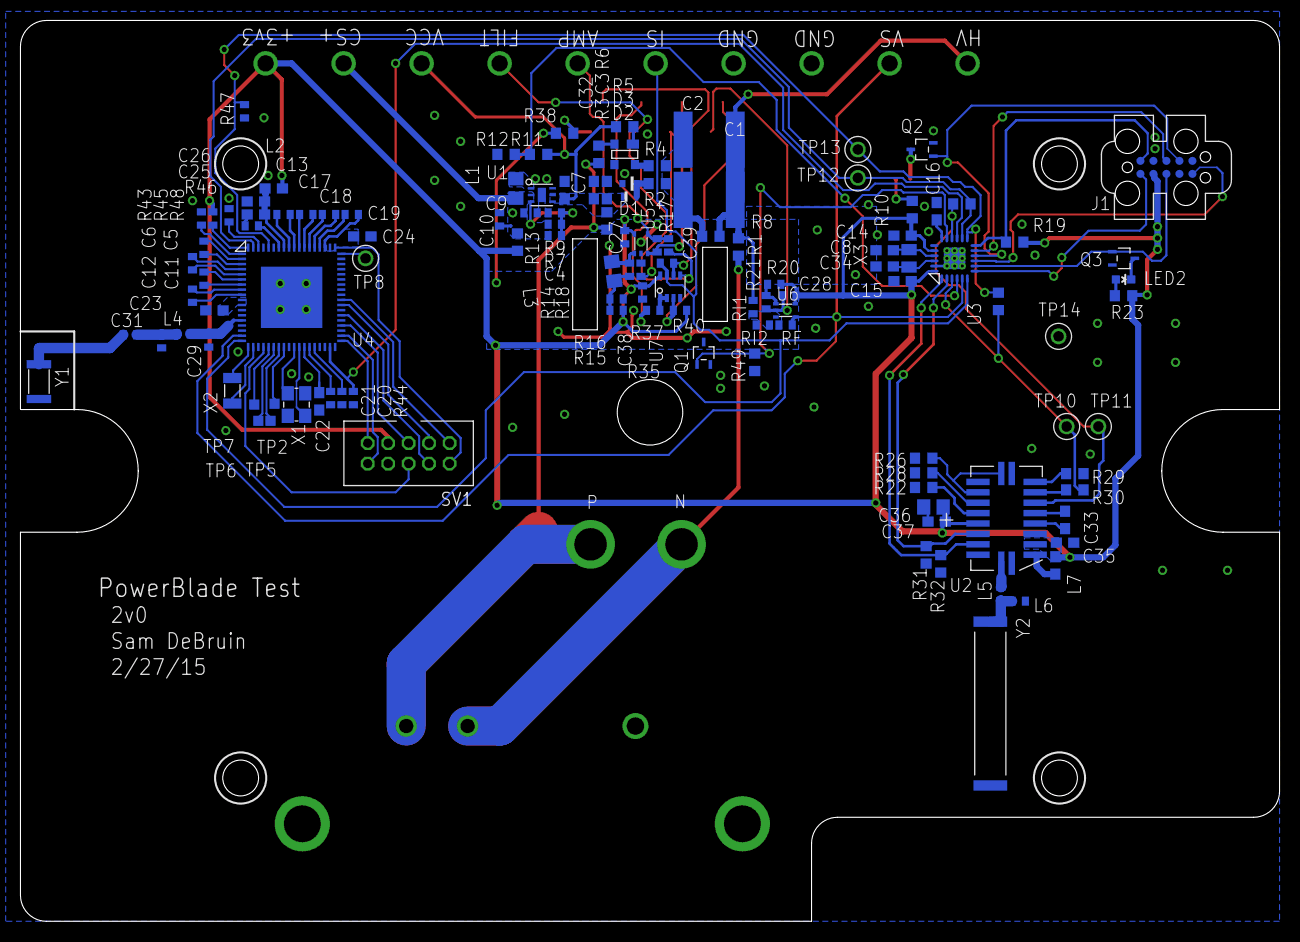
[picture p68: board powerblade_test.brd from below]

Board: 2 copper layers, 123.0 x 88.0 mm, 139 parts (123 on the bottom side), 108 nets.
