lab11/powerblade/eagle/supply_test/past_rev/1v0/supply_test_1v0.brd

## EAGLE design eagle/supply_test/past_rev/1v0/supply_test_1v0.brd (2014-11-19)

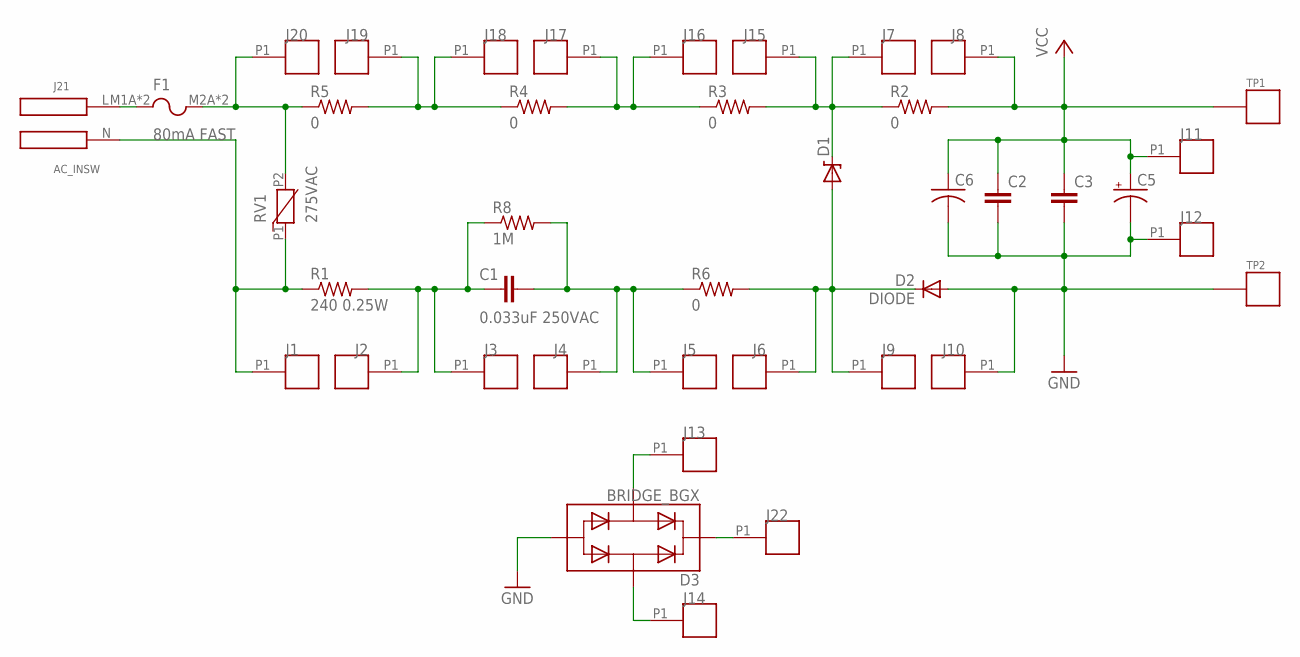
[picture p69: schematic supply_test_1v0.sch, sheet 1, AC-DC Power Supply]

Parts:
C1: 0.033uF 250VAC; C2220K; DIGIKEY 490-4238-1-ND
C2: C-EUC0805; C0805; DIGIKEY 445-8238-1-ND
C3: C-EUC0603; C0603; DIGIKEY 718-1672-1-ND
C5: CAP_POL1206; EIA3216; DIGIKEY NP
C6: C-USC1210; C1210; DIGIKEY 478-8408-1-ND
D1: ZENERBZT52; BZT52; DIGIKEY_2 BZT585B5V1T-7DICT-ND
D2: DIODE; BAS521
D3: BRIDGE_BGX; TO-253-4
F1: 80mA FAST; FUSE
J1, J2, J3, J4, J5, J6, J7, J8, J9, J10, J11, J12, J15, J16, J17, J18, J19, J20: SOCKET; SOCKET_1MM
J13, J14, J22: SOCKET; SOCKET_1MM; DIGIKEY ED90076-ND
J21: AC_INSW; AC_DC21; DIGIKEY_2 AE9888-ND
R1: 240 0.25W; R0603; DIGIKEY RHM240DCT-ND
R2, R3, R4, R5, R6: 0; R0603; DIGIKEY P0.0GCT-ND
R8: 1M; R0603; DIGIKEY MCT0603-1.00M-CFCT-ND
RV1: 275VAC; MOV_4032
TP1: TP_STD; TP; DIGIKEY 5000K-ND
TP2: TP_STD; TP; DIGIKEY 5001K-ND

Connections:
GND: C2.2, C3.2, C5.C (-), C6.2, D2.A, D3.P3, J10.P1, J12.P1, TP2.P$1; also elsewhere on the board
unnamed: C1.2, J2.P1, J3.P1, R1.2, R8.1
unnamed: J1.P1, J21.N, R1.1, RV1.P1
unnamed: C1.1, J4.P1, J5.P1, R6.1, R8.2
unnamed: D1.A, D2.C, J6.P1, J9.P1, R6.2
unnamed: D1.C, J7.P1, J15.P1, R2.1, R3.2
unnamed: D3.P2, J13.P1
unnamed: D3.P1, J22.P1
unnamed: D3.P4, J14.P1
unnamed: F1.M1A (P1), F1.M1B (P1), J21.L
unnamed: J16.P1, J17.P1, R3.1, R4.2
unnamed: F1.M2A (P2), F1.M2B (P2), J20.P1, R5.1, RV1.P2
unnamed: J18.P1, J19.P1, R4.1, R5.2
VCC: C2.1, C3.1, C5.A (+), C6.1, J8.P1, J11.P1, R2.2, TP1.P$1; also elsewhere on the board

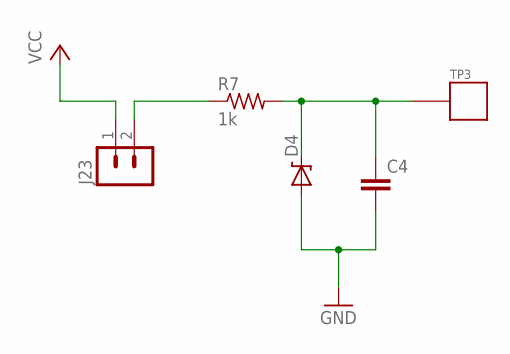
[picture p70: schematic supply_test_1v0.sch, sheet 2, Load Supply Regulation]

Parts:
C4: C-EUC0603; C0603; DIGIKEY 445-8028-1-ND
D4: ZENERBZT52; BZT52
J23: MA02-1STR; MA02-1; DIGIKEY 609-4434-ND
R7: 1k; R0603; DIGIKEY P1.0KGCT-ND
TP3: TP_STD; TP; DIGIKEY 5000K-ND

Connections:
GND: C4.2, D4.A; also elsewhere on the board
unnamed: J23.2, R7.1
unnamed: C4.1, D4.C, R7.2, TP3.P$1
VCC: J23.1; also elsewhere on the board

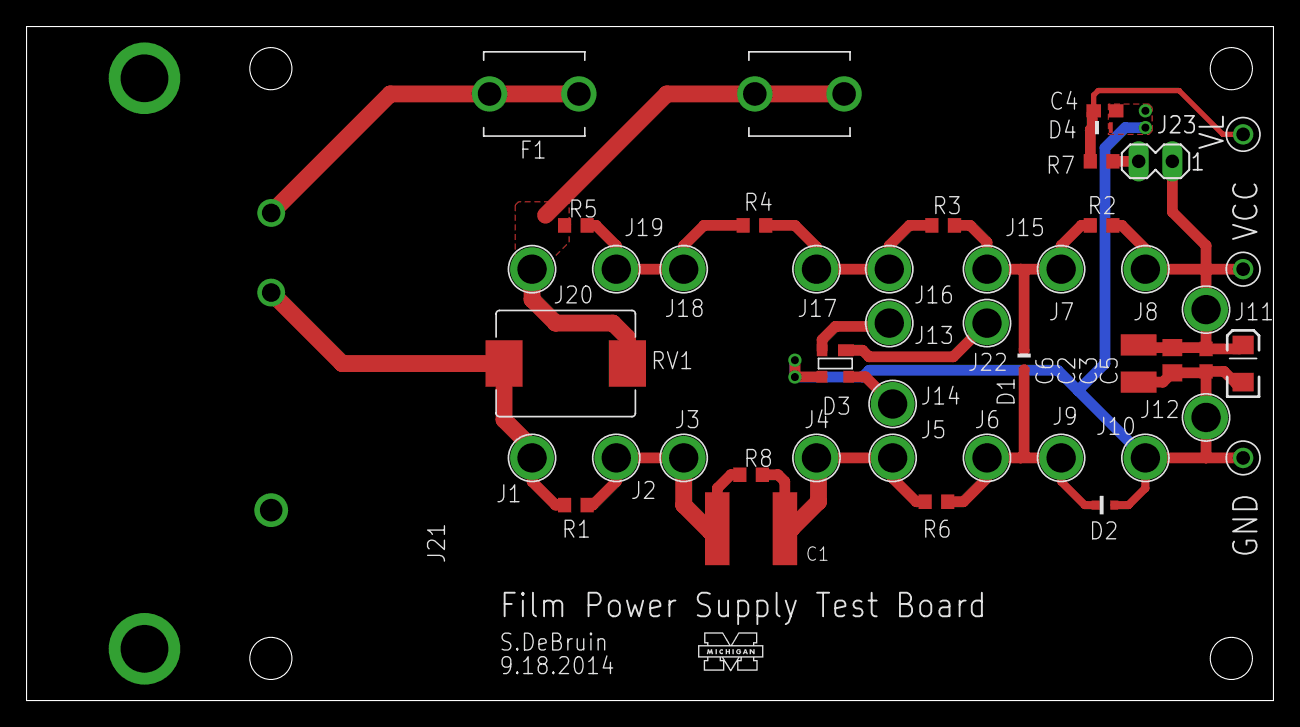
[picture p71: board supply_test_1v0.brd from above]

Board: 2 copper layers, 94.0 x 50.8 mm, 47 parts (0 on the bottom side), 16 nets.

Other parts of the board:
U$1: UMICH
