lab11/powerblade/eagle/powerblade/past_rev/2v0/powerblade_2v0.brd

## EAGLE design eagle/powerblade/past_rev/2v0/powerblade_2v0.brd (2014-11-25)

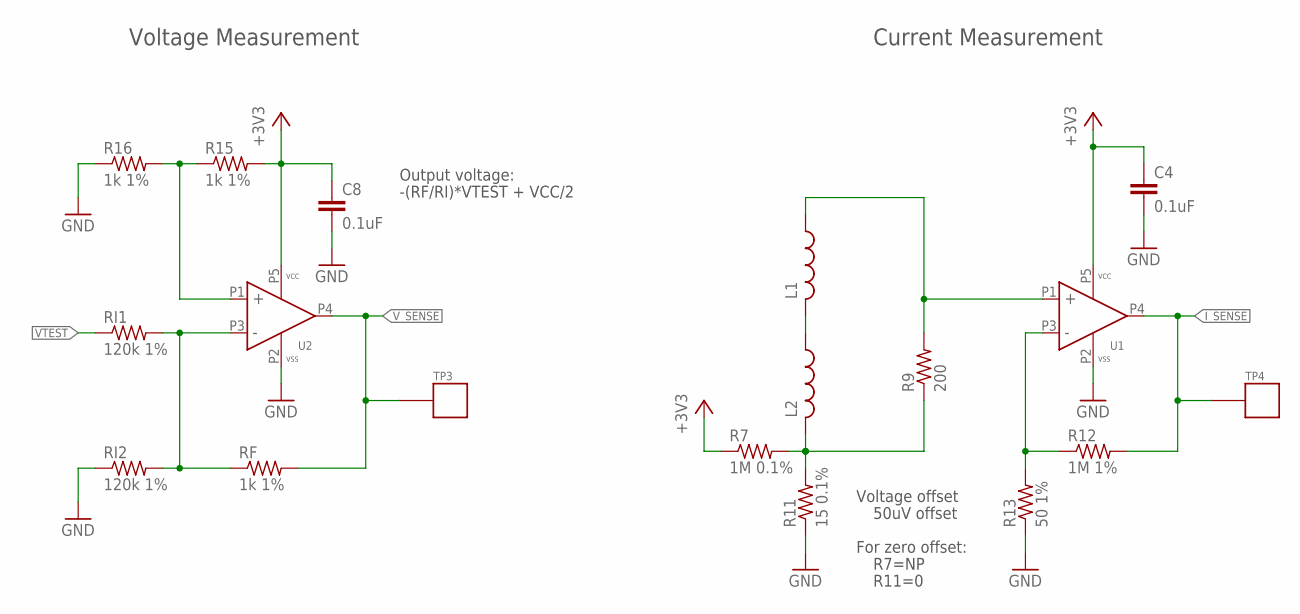
[picture p72: schematic powerblade_2v0.sch, sheet 1, Current & Voltage Measurement]

Parts:
C4, C8: 0.1uF; C0402; DIGIKEY 445-1265-1-ND
L1, L2: L-USL0805; L0805
R7: 1M 0.1%; R0603; DIGIKEY A102234CT-ND
R9: 200; R0603; DIGIKEY P200HCT-ND
R11: 15 0.1%; R0603; DIGIKEY A109933CT-ND
R12: 1M 1%; R0603; DIGIKEY A102234CT-ND
R13: 50 1%; R0603; DIGIKEY P49.9HCT-ND
R15, R16: 1k 1%; R0603; DIGIKEY P1.00KHCT-ND
RF: 1k 1%; R0603; DIGIKEY P1.00KHCT-ND
RI1, RI2: 120k 1%; R0603; DIGIKEY P120KHCT-ND
TP3, TP4: TP_STD; TP
U1, U2: MAX9910; SC70-5

Connections:
+3V3: C4.1, C8.1, R7.1, R15.2, U1.P5 (VCC), U2.P5 (VCC); also elsewhere on the board
GND: C4.2, C8.2, R11.1, R13.1, R16.1, RI2.1, U1.P2 (VSS), U2.P2 (VSS); also elsewhere on the board
I_SENSE: R12.2, TP4.P$1, U1.P4 (OUT); also elsewhere on the board
unnamed: R15.1, R16.2, U2.P1 (IN+)
unnamed: R12.1, R13.2, U1.P3 (IN-)
unnamed: RF.1, RI1.2, RI2.2, U2.P3 (IN-)
unnamed: L2.2, R7.2, R9.1, R11.2
unnamed: L1.1, R9.2, U1.P1 (IN+)
unnamed: L1.2, L2.1
VTEST: RI1.1; also elsewhere on the board
V_SENSE: RF.2, TP3.P$1, U2.P4 (OUT); also elsewhere on the board

Notes on the sheet:
Voltage offset
50uV offset
For zero offset:
R7=NP
R11=0
Current Measurement
Voltage Measurement
Output voltage:
-(RF/RI)*VTEST + VCC/2

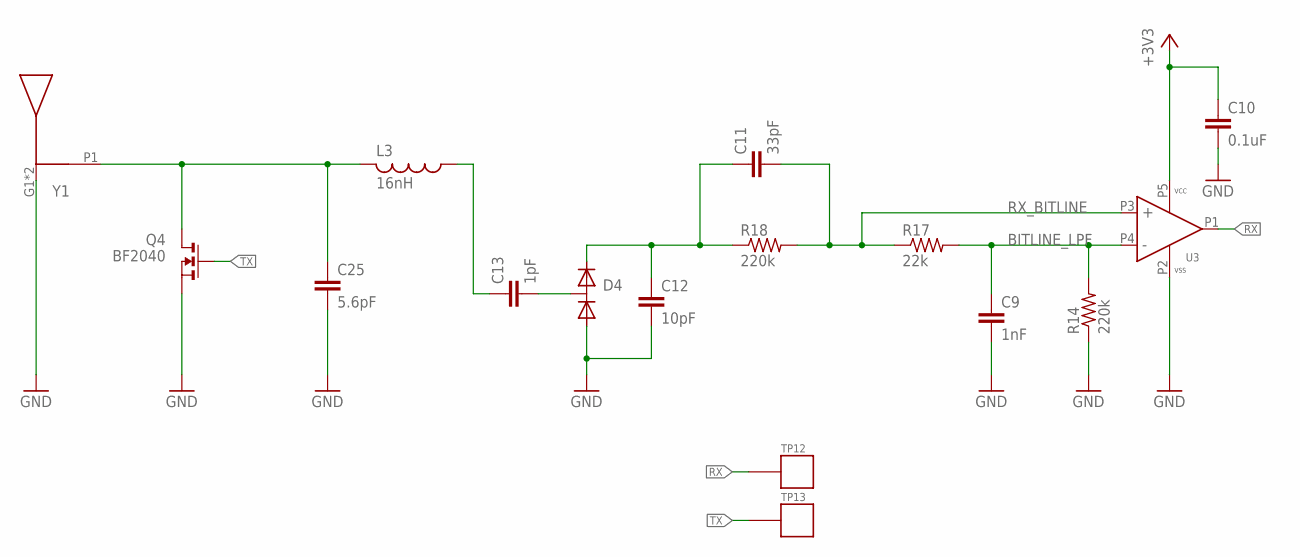
[picture p73: schematic powerblade_2v0.sch, sheet 2, WISP 5.0 Front End]

Parts:
C9: 1nF; C0603; DIGIKEY 490-6377-1-ND
C10: 0.1uF; C0603; DIGIKEY 445-1316-1-ND
C11: 33pF; C0603; DIGIKEY 399-7894-1-ND
C12: 10pF; C0603; DIGIKEY 1276-2151-1-ND
C13: 1pF; C0603; DIGIKEY 712-1323-1-ND
C25: 5.6pF; C0603; DIGIKEY 712-1360-1-ND
D4: HSMS-285C; SOT-323
L3: 16nH; L0603; DIGIKEY 732-1728-1-ND
Q4: BF2040; SOT-143
R14, R18: 220k; R0603; DIGIKEY P220KDBCT-ND
R17: 22k; R0603; DIGIKEY P22KDBCT-ND
TP12, TP13: TP_STD; TP
U3: NCS2200S; SC70-5
Y1: ANT-USP; DIGIKEY ANT-916-USP-ND

Connections:
+3V3: C10.1, U3.P5 (VCC); also elsewhere on the board
ANT: C25.1, L3.2, Q4.P2 (D), Y1.P1
BITLINE_LPF: C9.1, R14.2, R17.2, U3.P4 (IN-)
GND: C9.2, C10.2, C12.2, C25.2, D4.P1, Q4.P1 (S), R14.1, U3.P2 (VSS), Y1.G1 (G), Y1.G2 (G); also elsewhere on the board
unnamed: C13.1, L3.1
unnamed: C13.2, D4.P3
unnamed: C11.1, C12.1, D4.P2, R18.1
RX: TP12.P$1, U3.P1 (OUT); also elsewhere on the board
RX_BITLINE: C11.2, R17.1, R18.2, U3.P3 (IN+)
TX: Q4.P3 (G), Q4.P4 (G), TP13.P$1; also elsewhere on the board

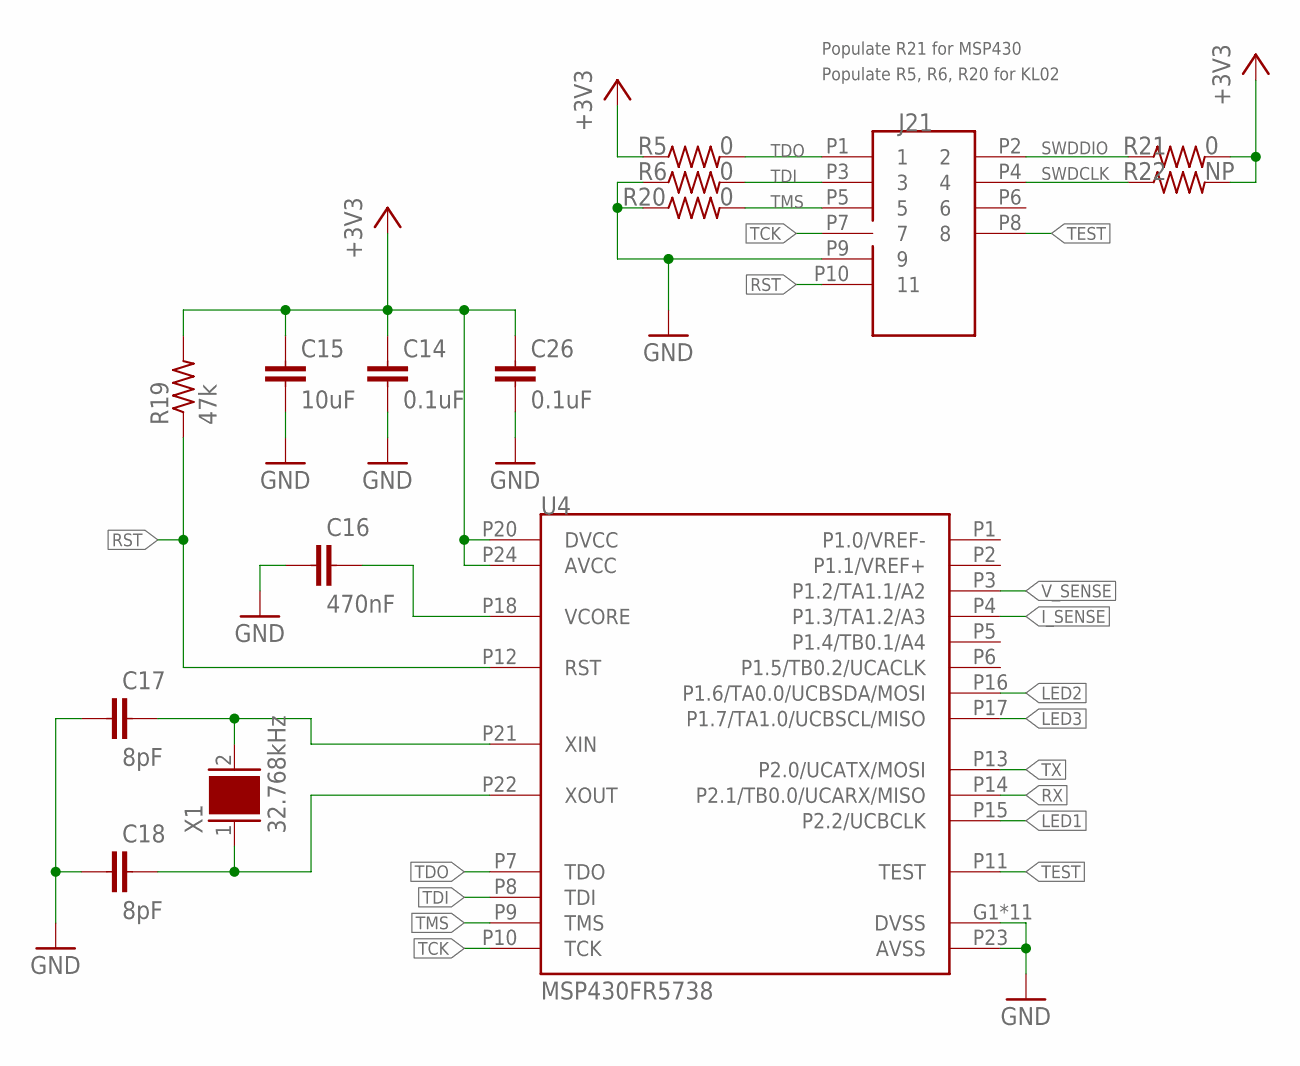
[picture p74: schematic powerblade_2v0.sch, sheet 3, MSP430]

Parts:
C14, C26: 0.1uF; C0603; DIGIKEY 445-1316-1-ND
C15: 10uF; C0603; DIGIKEY 1276-1119-1-ND
C16: 470nF; C0603; DIGIKEY 445-5192-1-ND
C17, C18: 8pF; C0603; DIGIKEY 1276-1817-1-ND
J21: JTAG_14PIN_IDC-NL; TC2050-IDC-NL-430; DIGIKEY NP
R5, R6, R20, R21: 0; R0603; DIGIKEY P0.0GCT-ND
R19: 47k; R0603; DIGIKEY P47KGCT-ND
R22: NP; R0603; DIGIKEY NP
U4: MSP430FR5738; VQFN-24
X1: 32.768kHz; 0805; DIGIKEY 535-12373-1-ND

Connections:
+3V3: C14.1, C15.1, C26.1, R5.1, R19.2, R21.2, R22.2, U4.P20 (DVCC), U4.P24 (AVCC); also elsewhere on the board
GND: C14.2, C15.2, C16.1, C17.1, C18.1, C26.2, J21.P9 (9), R6.1, R20.1, U4.G1 (DVSS), U4.G2 (DVSS), U4.G3 (DVSS), U4.G4 (DVSS), U4.G5 (DVSS), U4.G6 (DVSS), U4.G7 (DVSS), U4.G8 (DVSS), U4.G9 (DVSS), U4.P19 (DVSS), U4.P23 (AVSS), U4.PAD (DVSS); also elsewhere on the board
I_SENSE: U4.P4 (P1.3/TA1.2/A3); also elsewhere on the board
LED1: U4.P15 (P2.2/UCBCLK); also elsewhere on the board
LED2: U4.P16 (P1.6/TA0.0/UCBSDA/MOSI); also elsewhere on the board
LED3: U4.P17 (P1.7/TA1.0/UCBSCL/MISO); also elsewhere on the board
unnamed: C18.2, U4.P22 (XOUT), X1.1
unnamed: C16.2, U4.P18 (VCORE)
unnamed: C17.2, U4.P21 (XIN), X1.2
RST: J21.P10 (11), R19.1, U4.P12 (RST); also elsewhere on the board
RX: U4.P14 (P2.1/TB0.0/UCARX/MISO); also elsewhere on the board
SWDCLK: J21.P4 (4), R22.1; also elsewhere on the board
SWDDIO: J21.P2 (2), R21.1; also elsewhere on the board
TCK: J21.P7 (7), U4.P10 (TCK)
TDI: J21.P3 (3), R6.2, U4.P8 (TDI)
TDO: J21.P1 (1), R5.2, U4.P7 (TDO)
TEST: J21.P8 (8), U4.P11 (TEST)
TMS: J21.P5 (5), R20.2, U4.P9 (TMS)
TX: U4.P13 (P2.0/UCATX/MOSI); also elsewhere on the board
V_SENSE: U4.P3 (P1.2/TA1.1/A2); also elsewhere on the board

Notes on the sheet:
Populate R21 for MSP430
Populate R5, R6, R20 for KL02

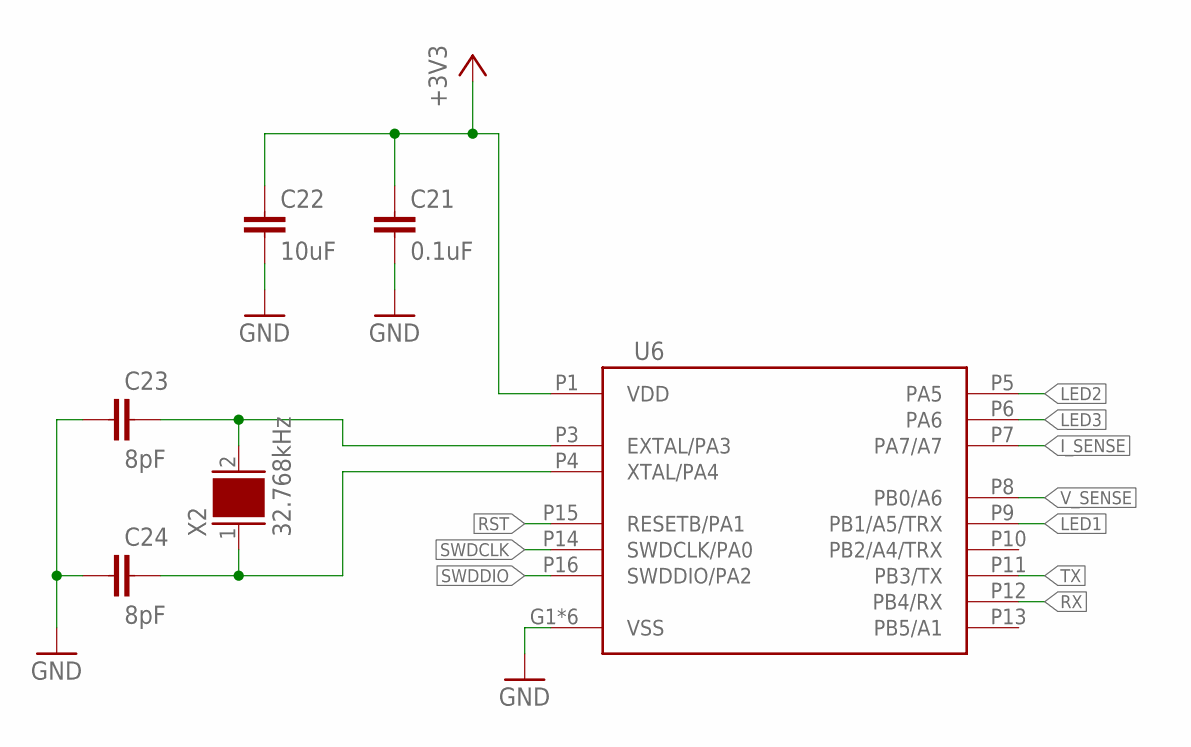
[picture p75: schematic powerblade_2v0.sch, sheet 4, KL02]

Parts:
C21: 0.1uF; C0603; DIGIKEY 445-1316-1-ND
C22: 10uF; C0603; DIGIKEY 1276-1119-1-ND
C23, C24: 8pF; C0603; DIGIKEY 1276-1817-1-ND
U6: KL02; WQFN-16
X2: 32.768kHz; 0805; DIGIKEY 535-12373-1-ND

Connections:
+3V3: C21.1, C22.1, U6.P1 (VDD); also elsewhere on the board
GND: C21.2, C22.2, C23.1, C24.1, U6.G1 (VSS), U6.G3 (VSS), U6.G7 (VSS), U6.G9 (VSS), U6.P2 (VSS), U6.PAD (VSS); also elsewhere on the board
I_SENSE: U6.P7 (PA7/A7); also elsewhere on the board
LED1: U6.P9 (PB1/A5/TRX); also elsewhere on the board
LED2: U6.P5 (PA5); also elsewhere on the board
LED3: U6.P6 (PA6); also elsewhere on the board
unnamed: C24.2, U6.P4 (XTAL/PA4), X2.1
unnamed: C23.2, U6.P3 (EXTAL/PA3), X2.2
RST: U6.P15 (RESETB/PA1); also elsewhere on the board
RX: U6.P12 (PB4/RX); also elsewhere on the board
SWDCLK: U6.P14 (SWDCLK/PA0); also elsewhere on the board
SWDDIO: U6.P16 (SWDDIO/PA2); also elsewhere on the board
TX: U6.P11 (PB3/TX); also elsewhere on the board
V_SENSE: U6.P8 (PB0/A6); also elsewhere on the board

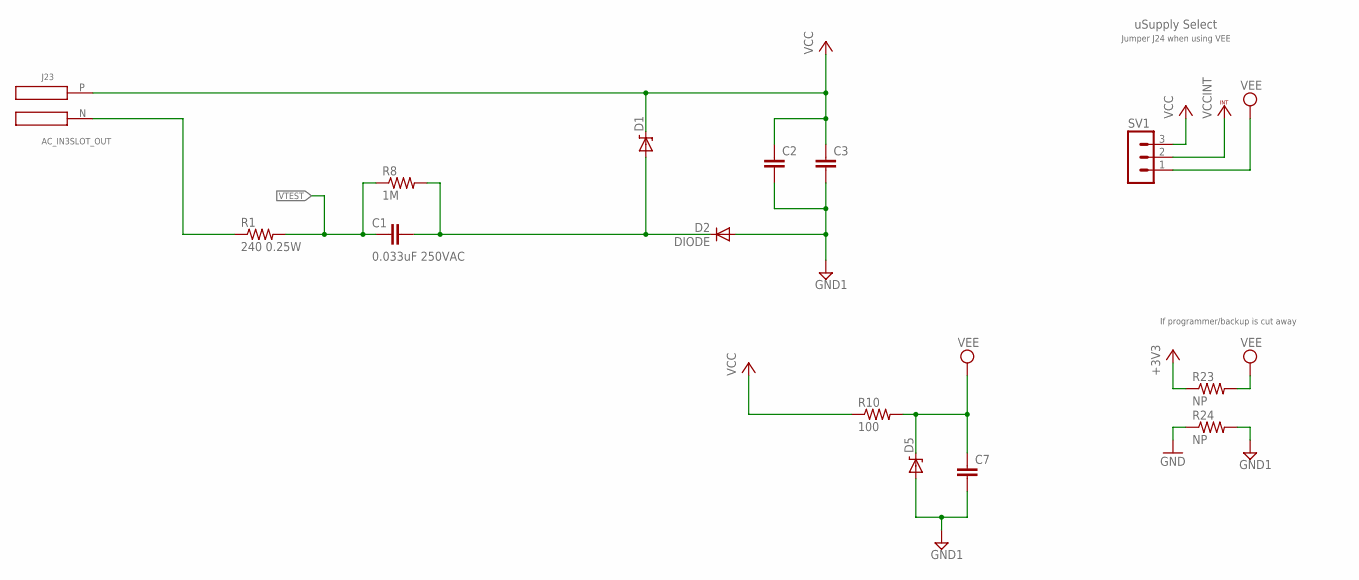
[picture p76: schematic powerblade_2v0.sch, sheet 5, AC-DC Power Supply]

Parts:
C1: 0.033uF 250VAC; C2220K; DIGIKEY 490-4238-1-ND
C2: C-EUC0805; C0805; DIGIKEY 445-8238-1-ND
C3: C-EUC0603; C0603; DIGIKEY 445-9077-1-ND
C7: C-EUC0603; C0603; DIGIKEY 1276-2383-1-ND
D1: ZENERBZT52; BZT52; DIGIKEY_2 BZT585B5V1T-7DICT-ND
D2: DIODE; BAS521
D5: ZENERBZT52; BZT52
J23: AC_IN3SLOT_OUT; AC3_SLOT_OUT; DIGIKEY 3M11307-ND
R1: 240 0.25W; R0603; DIGIKEY RHM240DCT-ND
R8: 1M; R0603; DIGIKEY MCT0603-1.00M-CFCT-ND
R10: 100; R0603; DIGIKEY P100GCT-ND
R23, R24: NP; R0603; DIGIKEY NP
SV1: MA03-1STR; MA03-1; DIGIKEY 3M9448-ND

Connections:
+3V3: R23.1; also elsewhere on the board
GND: R24.1; also elsewhere on the board
GND1: C2.2, C3.2, C7.2, D2.A, D5.A, R24.2; also elsewhere on the board
unnamed: J23.N, R1.1
unnamed: C1.1, D1.A, D2.C, R8.2
VCC: C2.1, C3.1, D1.C, J23.P, R10.1, SV1.3
VCCINT: SV1.2; also elsewhere on the board
VEE: C7.1, D5.C, R10.2, R23.2, SV1.1
VTEST: C1.2, R1.2, R8.1; also elsewhere on the board

Notes on the sheet:
uSupply Select
Jumper J24 when using VEE
If programmer/backup is cut away

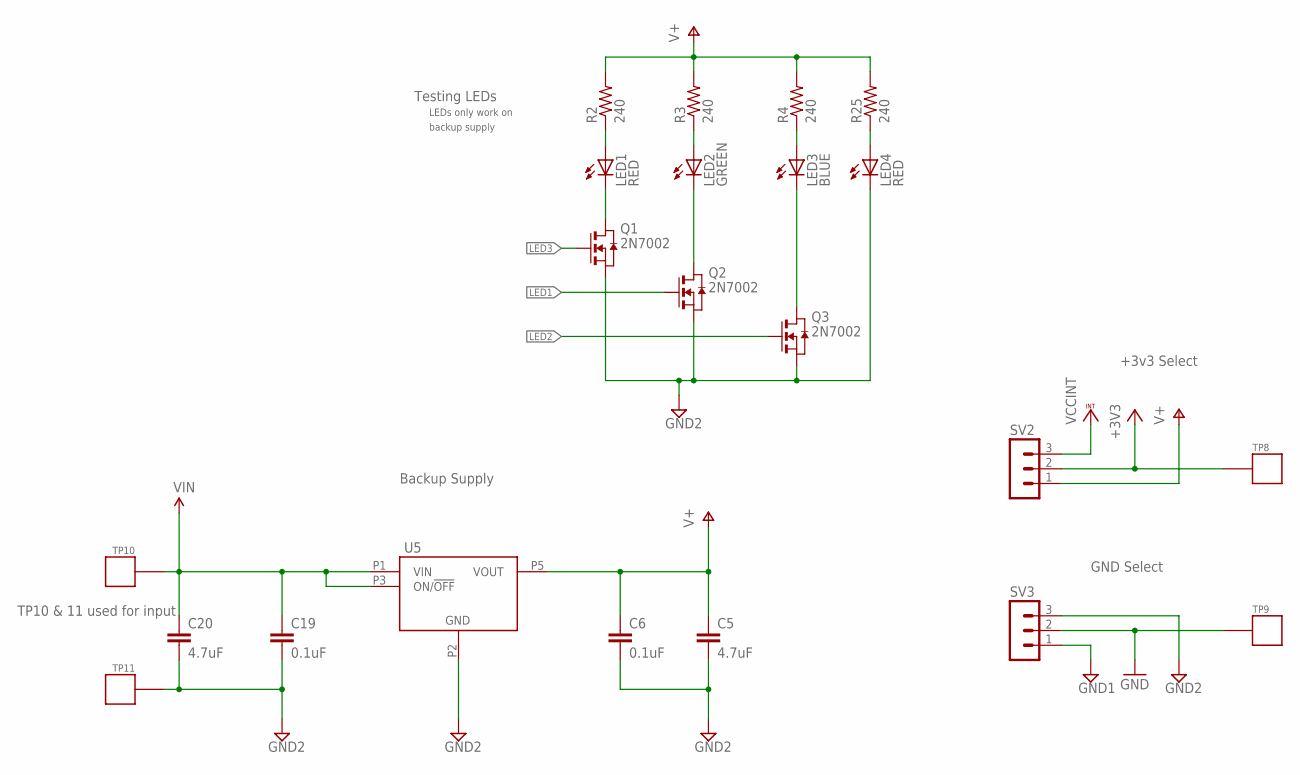
[picture p77: schematic powerblade_2v0.sch, sheet 6, Other Power]

Parts:
C5, C20: 4.7uF; C0603; DIGIKEY 490-3302-1-ND
C6, C19: 0.1uF; C0603; DIGIKEY 445-1316-1-ND
LED1, LED4: RED; LED-0603; DIGIKEY 1080-1400-1-ND
LED2: GREEN; LED-0603; DIGIKEY 1080-1402-1-ND
LED3: BLUE; LED-0603; DIGIKEY 1080-1401-1-ND
Q1, Q2, Q3: 2N7002; SC-70-3
R2, R3, R4, R25: 240; R0603; DIGIKEY P240GCT-ND
SV2, SV3: MA03-1STR; MA03-1; DIGIKEY 3M9448-ND
TP8, TP9, TP10, TP11: TP_STD; TP
U5: LP2980; SOT-23-5

Connections:
+3V3: SV2.2, TP8.P$1; also elsewhere on the board
GND: SV3.2, TP9.P$1; also elsewhere on the board
GND1: SV3.1; also elsewhere on the board
GND2: C5.2, C6.2, C19.2, C20.2, LED4.C, Q1.P2 (S), Q2.P2 (S), Q3.P2 (S), SV3.3, TP11.P$1, U5.P2 (GND)
LED1: Q2.P1 (G); also elsewhere on the board
LED2: Q3.P1 (G); also elsewhere on the board
LED3: Q1.P1 (G); also elsewhere on the board
unnamed: LED1.A, R2.1
unnamed: LED1.C, Q1.P3 (D)
unnamed: LED2.C, Q2.P3 (D)
unnamed: LED2.A, R3.1
unnamed: LED3.A, R4.1
unnamed: LED3.C, Q3.P3 (D)
unnamed: LED4.A, R25.1
V+: C5.1, C6.1, R2.2, R3.2, R4.2, R25.2, SV2.1, U5.P5 (VOUT)
VCCINT: SV2.3; also elsewhere on the board
VIN: C19.1, C20.1, TP10.P$1, U5.P1 (VIN), U5.P3 (ON/!OFF!)

Notes on the sheet:
+3v3 Select
GND Select
Backup Supply
Testing LEDs
LEDs only work on
backup supply
TP10 & 11 used for input

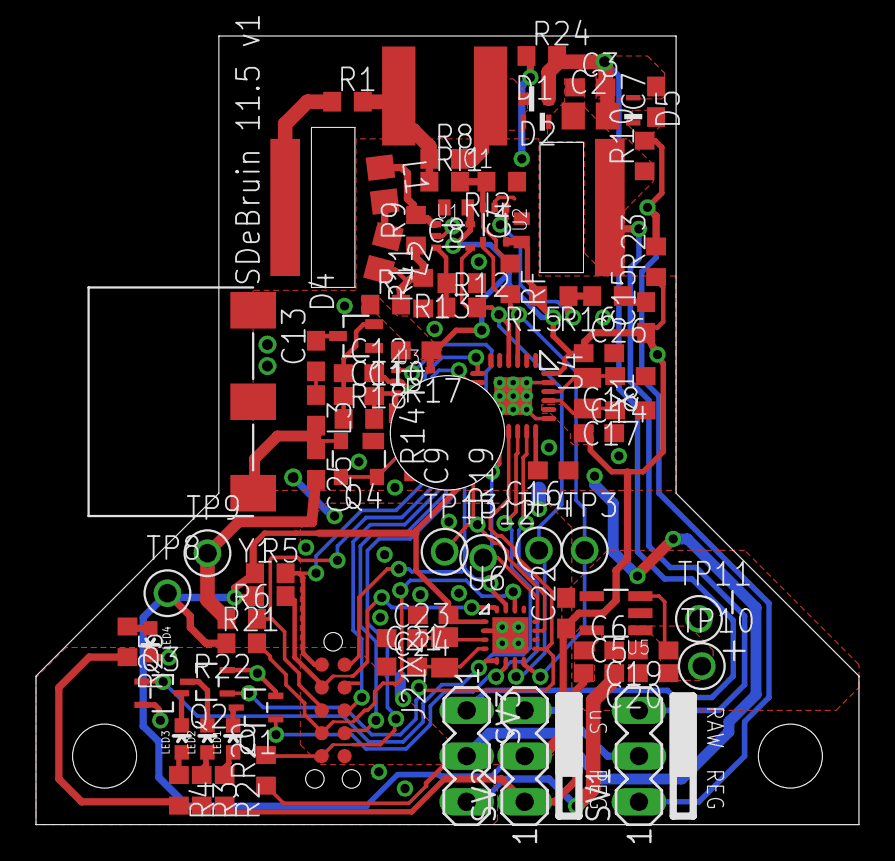
[picture p78: board powerblade_2v0.brd from above]

Board: 2 copper layers, 45.7 x 43.8 mm, 91 parts (0 on the bottom side), 51 nets.
