lab11/powerblade/eagle/supply_test/supply_test_2v1.brd

## EAGLE design eagle/supply_test/supply_test_2v1.brd (2015-05-24)

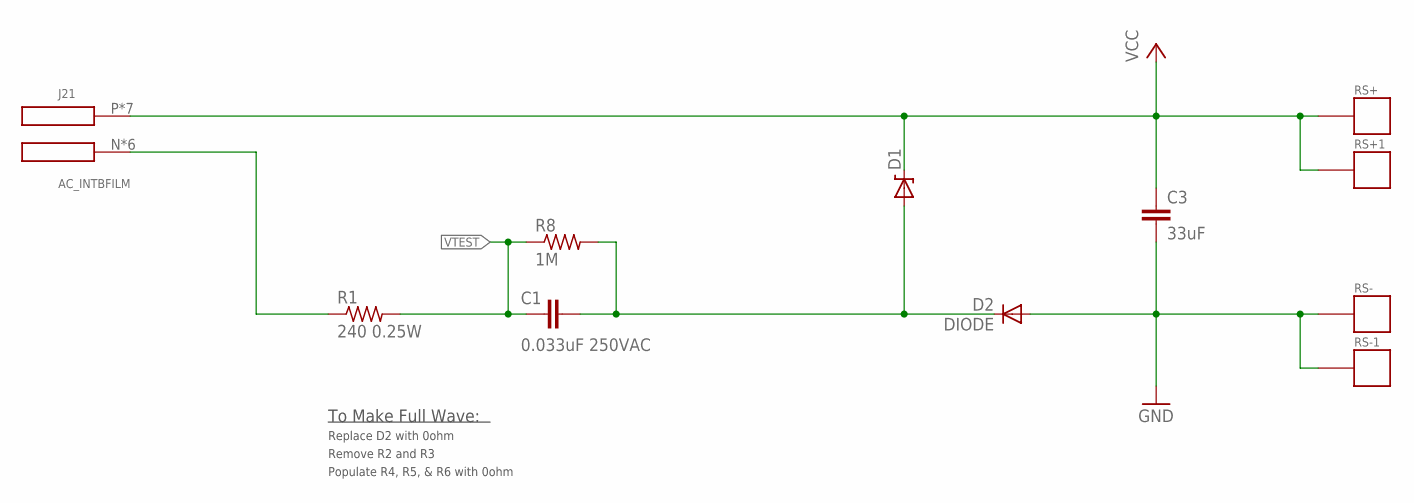
[picture p79: schematic supply_test_2v1.sch, sheet 1, AC-DC Power Supply]

Parts:
C1: 0.033uF 250VAC; C2220-EDGE; DIGIKEY 490-4238-1-ND
C3: 33uF; C0603; DIGIKEY 718-1672-1-ND
D1: ZENERBZT52; BZT52; DIGIKEY BZT52C10T-7DICT-ND
D2: DIODE; BAS521
J21: AC_INTBFILM; AC3_TBFILM; DIGIKEY NP
R1: 240 0.25W; R0603; DIGIKEY RHM240DCT-ND
R8: 1M; R0603; DIGIKEY MCT0603-1.00M-CFCT-ND
RS+: TP_LONG; DIGIKEY NP
RS+1: TP_SMD; DIGIKEY NP
RS-: TP_LONG; DIGIKEY NP
RS-1: TP_SMD; DIGIKEY NP

Connections:
GND: C3.2, D2.A, RS-.P$1, RS-1.P$1; also elsewhere on the board
unnamed: J21.N, J21.N1 (N), J21.N2 (N), J21.N3 (N), J21.N4 (N), J21.N5 (N), R1.1
unnamed: C1.1, D1.A, D2.C, R8.2
VCC: C3.1, D1.C, J21.P, J21.P1, J21.P2, J21.P3, J21.P4, J21.P5, J21.P6, RS+.P$1, RS+1.P$1; also elsewhere on the board
VTEST: C1.2, R1.2, R8.1; also elsewhere on the board

Notes on the sheet:
To Make Full Wave:
Replace D2 with 0ohm
Remove R2 and R3
Populate R4, R5, & R6 with 0ohm

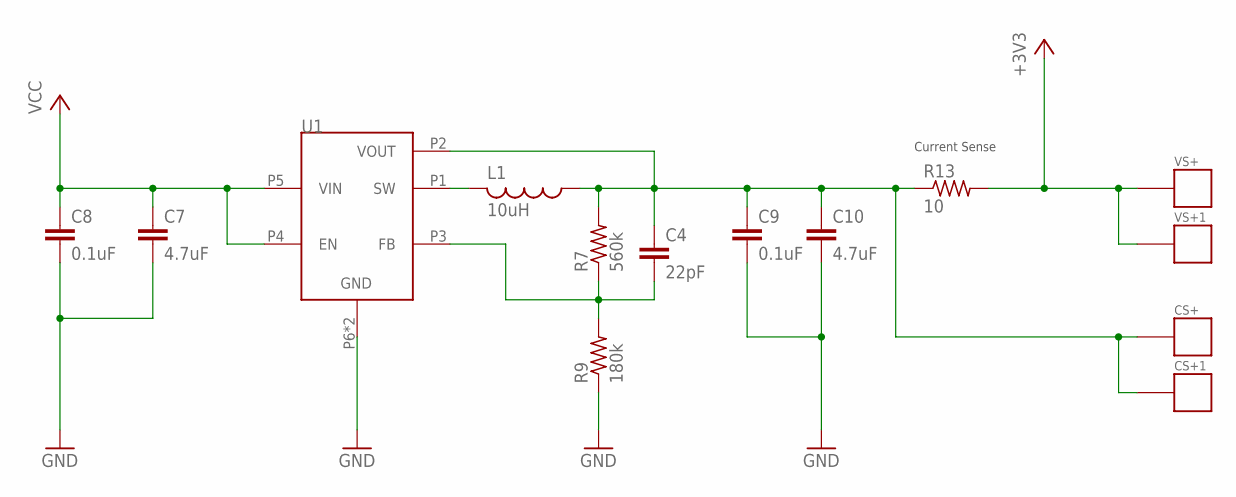
[picture p80: schematic supply_test_2v1.sch, sheet 2, Load Supply Regulation]

Parts:
C4: 22pF; C0402
C7: 4.7uF; C0402; DIGIKEY 587-2786-1-ND
C8, C9: 0.1uF; C0402; DIGIKEY 1276-1001-1-ND
C10: 4.7uF; C0603; DIGIKEY 587-2786-1-ND
CS+: TP_LONG; DIGIKEY NP
CS+1: TP_SMD; DIGIKEY NP
L1: 10uH; L0805; DIGIKEY 490-4990-1-ND
R7: 560k; R0402
R9: 180k; R0402
R13: 10; R0603; DIGIKEY CRT0603-BY-10R0ELFCT-ND
U1: TPS62122; WDFN-6
VS+: TP_LONG; DIGIKEY NP
VS+1: TP_SMD; DIGIKEY NP

Connections:
+3V3: R13.2, VS+.P$1, VS+1.P$1; also elsewhere on the board
GND: C7.2, C8.2, C9.2, C10.2, R9.1, U1.P6 (GND), U1.PAD (GND); also elsewhere on the board
unnamed: L1.2, U1.P1 (SW)
unnamed: C4.1, C9.1, C10.1, CS+.P$1, CS+1.P$1, L1.1, R7.2, R13.1, U1.P2 (VOUT)
unnamed: C4.2, R7.1, R9.2, U1.P3 (FB)
VCC: C7.1, C8.1, U1.P4 (EN), U1.P5 (VIN); also elsewhere on the board

Notes on the sheet:
Current Sense

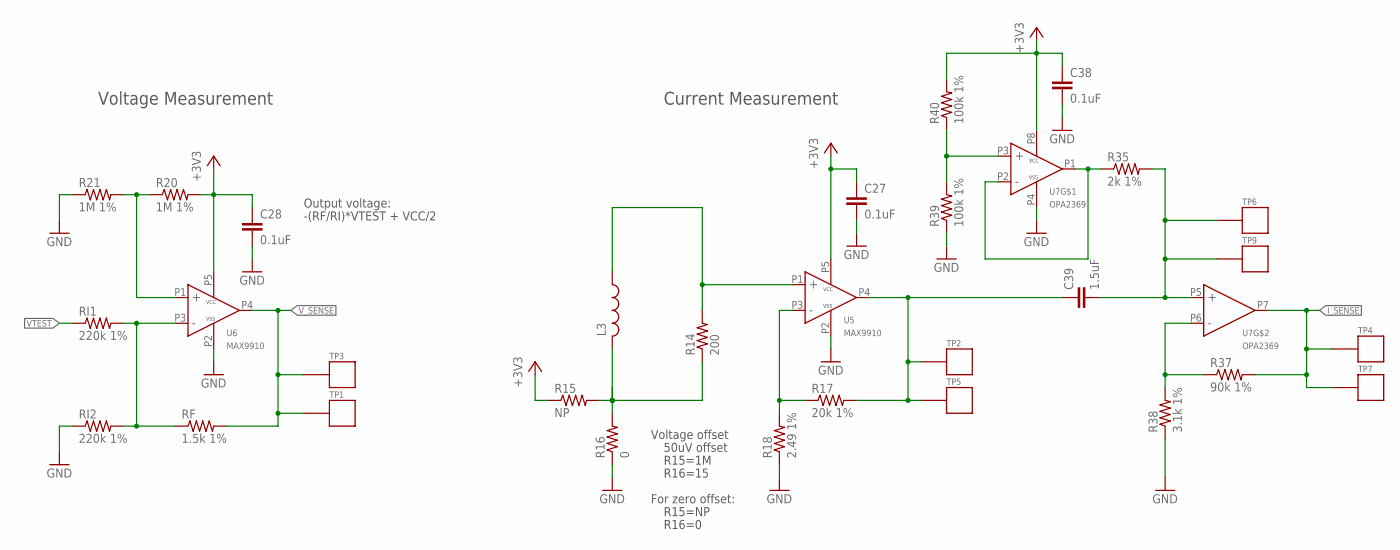
[picture p81: schematic supply_test_2v1.sch, sheet 3, Power Sensing!]

Parts:
C27, C28, C38: 0.1uF; C0402; DIGIKEY 445-1265-1-ND
C39: 1.5uF; C0402; DIGIKEY 445-13874-1-ND
L3: L-USL0805; L0805; DIGIKEY 732-3452-1-ND
R14: 200; R0402; DIGIKEY P200LCT-ND
R15: NP; R0402; DIGIKEY NP
R16: 0; R0402; DIGIKEY P0.0JCT-ND
R17: 20k 1%; R0402; DIGIKEY P20.0KLCT-ND
R18: 2.49 1%; R0402; DIGIKEY 541-2.49LLCT-ND
R20, R21: 1M 1%; R0402; DIGIKEY P10.0KLCT-ND
R35: 2k 1%; R0402; DIGIKEY P2.00KLCT-ND
R37: 90k 1%; R0402; DIGIKEY P90.9KLCT-ND
R38: 3.1k 1%; R0402; DIGIKEY P3.09KHCT-ND
R39, R40: 100k 1%; R0402; DIGIKEY P100KLCT-ND
RF: 1.5k 1%; R0402; DIGIKEY P1.50KLCT-ND
RI1, RI2: 220k 1%; R0402; DIGIKEY P220KLCT-ND
TP1: TP_SMD; DIGIKEY 5129K-ND
TP2, TP4, TP9: TP_LONG; DIGIKEY 5126K-ND
TP3: TP_LONG; DIGIKEY 5129K-ND
TP5, TP6, TP7: TP_SMD; DIGIKEY 5126K-ND
U5, U6: MAX9910; SC70-5
U7: OPA2369; SOT-23-8

Connections:
+3V3: C27.1, C28.1, C38.1, R15.1, R20.2, R40.2, U5.P5 (VCC), U6.P5 (VCC), U7.P8 (VCC); also elsewhere on the board
GND: C27.2, C28.2, C38.2, R16.1, R18.1, R21.1, R38.1, R39.1, RI2.1, U5.P2 (VSS), U6.P2 (VSS), U7.P4 (VSS); also elsewhere on the board
I_SENSE: R37.2, TP4.P$1, TP7.P$1, U7.P7 (OUT)
unnamed: L3.2, R14.1, R15.2, R16.2
unnamed: L3.1, R14.2, U5.P1 (IN+)
unnamed: R20.1, R21.2, U6.P1 (IN+)
unnamed: RF.1, RI1.2, RI2.2, U6.P3 (IN-)
unnamed: C39.1, R17.2, TP2.P$1, TP5.P$1, U5.P4 (OUT)
unnamed: R17.1, R18.2, U5.P3 (IN-)
unnamed: R37.1, R38.2, U7.P6 (IN-)
unnamed: C39.2, R35.2, TP6.P$1, TP9.P$1, U7.P5 (IN+)
unnamed: R35.1, U7.P1 (OUT), U7.P2 (IN-)
unnamed: R39.2, R40.1, U7.P3 (IN+)
VTEST: RI1.1; also elsewhere on the board
V_SENSE: RF.2, TP1.P$1, TP3.P$1, U6.P4 (OUT)

Notes on the sheet:
Voltage offset
50uV offset
For zero offset:
R15=NP
R16=0
Current Measurement
Voltage Measurement
Output voltage:
-(RF/RI)*VTEST + VCC/2
R15=1M
R16=15

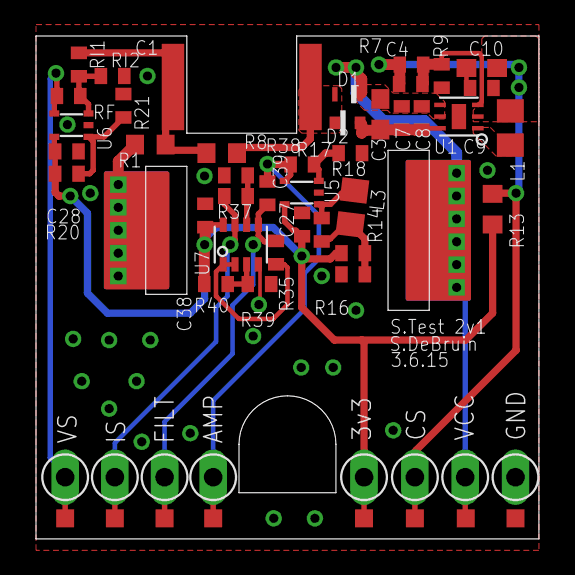
[picture p82: board supply_test_2v1.brd from above]

Board: 2 copper layers, 27.9 x 27.9 mm, 56 parts (0 on the bottom side), 21 nets.
