lab11/powerblade/software/nrf51822/apps/powerblade/uart.h

#ifndef POWERBLADE_UART_H
#define POWERBLADE_UART_H

// function prototypes
void uart_init(void);
void uart_rx_enable(void);
void uart_tx_enable(void);
void uart_rx_disable(void);
void uart_tx_disable(void);

#endif //POWERBLADE_UART_H
