lab11/powerblade/(commit log)

2014-11-19 added powerblade hardware files
    [inductor_test.brd, inductor_test.sch, powerblade.brd, powerblade.sch, supply_test.brd, supply_test.sch]
2014-11-19 added powerblade project to software
2014-11-24 miller functions for a single bit
2014-11-25 added powerfilm lbr
2014-11-25 added 3 pin slot to powerblade lbr
2014-11-25 added next version for powerblade hardware
    [powerblade_1v0.brd, powerblade_1v0.sch, powerblade_2v0.brd, powerblade_2v0.sch]
2014-11-25 updated to 3 prong ac
    [powerblade_2v0.brd, powerblade_2v0.sch]
2014-11-25 added tiny buck to powerfilm lbr
2014-11-26 miller 8 working at line frequency using a for loop
2014-11-30 added timer test code
2014-12-03 powerblade gets rn16 ack after every query
2014-12-04 powerblade checks against rn16 before scattering epc
2014-12-05 miller encode works for ints rather than strings
2014-12-08 reduced power consumption
2014-12-10 added low power project in powerblade
2015-01-07 updated to new rev of supply test
    [supply_test_1v0.brd, supply_test_1v0.sch, supply_test_2v0.brd, supply_test_2v0.sch]
2015-01-07 supply test version 2
    [supply_test_2v0.brd, supply_test_2v0.sch]
2015-01-19 added different regulator to supply test
    [supply_test_2v0.brd, supply_test_2v0.sch]
2015-01-19 miniaturized power supply
    [supply_test_2v0.brd, supply_test_2v0.sch]
2015-01-19 finished updating shcematic
    [supply_test_2v0.brd, supply_test_2v0.sch]
2015-01-19 updated to film type
    [supply_test_2v0.brd, supply_test_2v0.sch]
2015-01-19 fixed flap layer issue
    [supply_test_2v0.brd, supply_test_2v0.sch]
2015-01-20 re-arranged full wave and enable
    [supply_test_2v0.brd, supply_test_2v0.sch]
2015-01-20 finalized three prong placement
    [supply_test_2v0.brd, supply_test_2v0.sch]
2015-01-20 placement done
    [supply_test_2v0.brd, supply_test_2v0.sch]
2015-01-20 added pot to supply test
    [supply_test_2v0.brd, supply_test_2v0.sch]
2015-01-22 finished routing in new features
    [supply_test_2v0.brd, supply_test_2v0.sch]
2015-01-22 all parts numbered in supply test v2
    [supply_test_2v0.brd, supply_test_2v0.sch]
2015-01-26 finished supply test design with gerbers
    [supply_test_2v0.brd]
2015-01-26 zipped gerbers
2015-01-29 finished board for supply test
    [supply_test_2v0.brd, supply_test_2v0.sch]
2015-01-30 updated gerbers name
2015-02-03 processed parts for supply test
    [partList.xlsx, supply_test_2v0.csv]
2015-02-16 added powerblade image
2015-02-20 archived powerblade2_0
    [powerblade_2v0.brd, powerblade_2v0.sch]
2015-02-23 added powerblade test file
    [powerblade_test.brd, powerblade_test.sch]
2015-02-23 added outline for powerblade test board
    [powerblade_test.brd]
2015-02-24 added crystals to ltc5800 sch in powerblade test
    [powerblade_test.brd, powerblade_test.sch]
2015-02-24 added antenna and programming header to ltc5800 schematic
    [powerblade_test.brd, powerblade_test.sch]
2015-02-24 added tr1000 to powerblade test sch
    [powerblade_test.brd, powerblade_test.sch]
2015-02-24 added antenna to tr1000 circuit
    [powerblade_test.brd, powerblade_test.sch]
2015-02-27 finished final amplifier design including high pass filter and pots for adjusting
    [powerblade_test.brd, powerblade_test.sch]
2015-02-27 added power gating or turnoff ability to tr1000, ltc5800, and power metering and defaulted to off
    [powerblade_test.brd, powerblade_test.sch]
2015-02-27 finished layout incl antennas
    [powerblade_test.brd, powerblade_test.sch]
2015-02-28 added gerbers
2015-02-28 finished powerblade
    [powerblade_test.brd, powerblade_test.sch]
2015-02-28 finished doing parts for powerblade test
    [partList.xlsx, powerblade_test.brd, powerblade_test.csv, powerblade_test.sch]
2015-03-04 added adc energy quanta testing app to low power
2015-03-04 changed vcc adc to be triggered by 8ms timer
2015-03-04 added sense-3-channel to low power app
2015-03-05 fixed some errors in powerblade test files
    [main.c, powerblade_test.h]
2015-03-05 fixed indents in powerblade test
    [main.c]
2015-03-05 added adc reset condition on channel 2
    [main.c]
2015-03-06 finished supply test board 2v1
    [supply_test_2v1.brd, supply_test_2v1.sch]
2015-03-06 updated powerfilm lbr
2015-03-06 finished supply test 2v1
    [outline_2v1.dxf]
2015-03-06 removed outline that was no longer correct
    [outline_2v1.dxf]
2015-03-06 archived supply_test_2v0
    [partList.xlsx, supply_test_1v0.brd, supply_test_1v0.sch, supply_test_2v0.brd, supply_test_2v0.csv, supply_test_2v0.sch]
2015-03-06 added top and side cutout dxf
    [powerblade_test.dxf, powerblade_test_side.dxf, powerblade_test_top.dxf]
2015-03-06 fixed minor errors in charge/discharge adc code
    [main.c, powerblade_test.h]
2015-03-08 added metering bom and sch
    [metering.csv]
2015-03-09 added current test data
2015-03-09 main.c works for powerblade
2015-03-10 archived powerblade_test
    [partList.xlsx, powerblade_1v0.brd, powerblade_1v0.sch, powerblade_2v0.brd, powerblade_2v0.sch, powerblade_test.brd, powerblade_test.csv, powerblade_test.dxf]
2015-03-10 added powerblade final copy schematic
    [powerblade_3v1.brd, powerblade_3v1.sch]
2015-03-10 updated powerfilm
    [powerblade_3v1.brd, powerblade_3v1.sch]
2015-03-10 updated metering bom
    [metering.csv]
2015-03-10 renamed current data
2015-03-11 added current and voltage sense trances for two loads
    [lightbox_291W_100PF.csv, oscope_41W_091PF.CSV]
2015-03-12 added data csvs for vcc charding and zero crossing
    [vcc_chgdischg_wble.csv, vsense_and_zc.csv]
2015-03-12 updated schematic for powerblade 3v1
    [powerblade_3v1.brd, powerblade_3v1.sch, powerblade_test.brd, powerblade_test.sch]
2015-03-12 finished new_final powerblade schematic
    [powerblade.csv, powerblade_3v1.brd, powerblade_3v1.sch]
2015-03-13 added vpn-compatible include path for low power project
2015-03-13 added zc voltage divider to powerblade_3v1 schematic
    [powerblade_3v1.brd, powerblade_3v1.sch]
2015-03-13 added isense_vmid support to low power app
2015-03-17 fixed errors in powerblade code
    [main.c]
2015-03-18 Updated peripheral explorer for current outputs
2015-03-18 finished parts for first page
    [powerblade_3v1.brd, powerblade_3v1.sch]
2015-03-19 finished parts
    [powerblade_3v1.brd, powerblade_3v1.sch]
2015-03-20 added 1s charge and discharge plot
    [vcc_cdchg_1s.CSV]
2015-03-20 changed timer adc to actual timer int and transmissions work over ble at 1hz
2015-03-21 starting power metering
2015-03-21 processing power measurements from ble
2015-03-21 powerblade test works, pf1 experiment done without pushing offset elim code
2015-03-22 powerblade js only displays unique sequence numbers
2015-03-22 added data for power to i_snese voltage
    [w_to_curr.xlsx]
2015-03-22 changed uart to wait for pin interrupt from nordic instead of open ended wait
2015-03-22 testing app works with faster sampling and negative power
2015-03-22 added a bunch of vsense isense captures
    [blender_puere.CSV, blender_stir.CSV, drill_full.CSV, drill_low.CSV, fridge.CSV, hotairgun_fullHeatAndAir.CSV, hotairgun_lowHeatLowAir.CSV, ice_shaver_shaving.CSV]
2015-03-23 started plotting current waveforms
2015-03-23 added icore plots
    [vcc__cdchg_far.CSV, vcc_cdchg_close.CSV, vcc_cdchg_mid.CSV]
2015-03-23 added very far
    [vcc_cdchg_veryFar.CSV]
2015-03-23 vcap and icore plots ready
    [vcc_cdchg_far.CSV]
2015-03-23 moved current waveforms data to shed
    [blender_puere.CSV, blender_stir.CSV, drill_full.CSV, drill_low.CSV, fridge.CSV, hotairgun_fullHeatAndAir.CSV, hotairgun_lowHeatLowAir.CSV, ice_shaver_shaving.CSV]
2015-03-23 moved vcap charge figure to shed
    [vcc_cdchg_close.CSV, vcc_cdchg_far.CSV, vcc_cdchg_mid.CSV, vcc_cdchg_veryFar.CSV]
2015-03-25 added first calibrate program
2015-03-25 added calibrate apps
2015-03-25 added data confirmation to powerblade app
2015-03-25 changed output values to average real power and average apparent power
2015-03-25 added sys enable and disable to calibrate_raw app
2015-03-25 added flags and PBID as well as average true power and apparent power
2015-03-25 Calibrations scripts and a bug fix
    [calibrate_ct.js, calibrate_raw.js]
2015-03-26 fixed sample timing and and transmit timing bugs, now more accurate and 1Hz
    [main.c]
2015-03-26 added waveform dataset showing underdamped properties
    [underdamped.CSV]
2015-03-26 cleaned up code and fixed calibrate_ct app
    [main.c, powerblade_test.h]
2015-03-26 added current offset elimination to msp430 code
2015-03-26 added curoff to calibrate_ct and changed phase calc slightly
2015-03-26 added stackup model for powerblade
    [full_stackup.SLDASM, l1l4_fr4.SLDPRT, l2l3_polyimide.SLDPRT]
2015-03-26 added bend to solidworks model
    [full_stackup.SLDASM, l1l4_fr4.SLDPRT, l2l3_polyimide.SLDPRT]
2015-03-26 finished draft of cad model
    [full_stackup.SLDASM, l1l4_fr4.SLDPRT, l2l3_polyimide.SLDPRT]
2015-03-28 Calibration bug fix
2015-03-30 updated scaling values in powerbladejs
2015-03-30 added watt-hours data
    [non_resistive.xlsx, resistive.xlsx]
2015-03-30 added data to wattHour graphs
    [non_resistive.xlsx, resistive.xlsx]
2015-03-31 added watts up to non resistive watt hours data
    [non_resistive.xlsx]
2015-03-31 calibrate ct sort of works now
2015-04-04 pwm code outputting agg_current
2015-04-04 Adding Android app for PowerBlade
2015-04-04 trying to fix agg current
    [main.c]
2015-04-04 pwm output works with offset calc
2015-04-05 calibrate works with new calibrate
2015-04-05 added calibrate option
2015-04-06 pwm works with offset correction
    [main.c]
2015-04-06 changed scaling constants in powerblade.js
2015-04-06 powerblade_data app averages power
2015-04-06 powerblade apps average certain values over time
2015-04-08 changes to powerblade app for new flex - benchmarking after calibration
    [main.c, powerblade_test.h]
2015-04-10 powerblade scaler for flex
    [powerblade_data.js]
2015-04-10 updated final scaling numbers for a powerblade with +75 offset for current
2015-04-10 updated powerblade offset to 75 for flex system with 6000 gain in stage 1
    [powerblade_test.h]
2015-04-11 added packet counter to powerblade app
2015-04-14 post mortem changes to schematic
    [powerblade_3v1.brd, powerblade_3v1.sch]
2015-04-14 updated powerblade schematic
    [powerblade_3v1.brd, powerblade_3v1.sch]
2015-04-14 made small powerblade connector
2015-04-14 updated phase and neutral and updated in powerblade
    [powerblade_3v1.brd, powerblade_3v1.sch]
2015-04-15 updates to powerblade board
    [powerblade_3v1.brd, powerblade_3v1.sch]
2015-04-15 placement work for powerblade 3v1
    [powerblade_3v1.brd, powerblade_3v1.sch]
2015-04-21 changed v_sense amplifier to TI part
    [powerblade_3v1.brd, powerblade_3v1.sch]
2015-04-27 placement for 51822 and 0402_sm for all passives in current sense
    [powerblade_3v1.brd, powerblade_3v1.sch]
2015-04-27 finished placement
    [powerblade_3v1.brd, powerblade_3v1.sch]
2015-04-28 updates and routing in powerblade
    [powerblade_3v1.brd, powerblade_3v1.sch]
2015-04-28 more routing in powerblade
    [powerblade_3v1.brd, powerblade_3v1.sch]
2015-04-29 25 airwires
    [powerblade_3v1.brd, powerblade_3v1.sch]
2015-04-29 almost done, three actual airwires left
    [powerblade_3v1.brd]
2015-04-29 switched phase and neutral, everything routed but 12 headers plus antenna
    [powerblade_3v1.brd, powerblade_3v1.sch]
2015-04-30 almost done routing incl some of the headers
    [powerblade_3v1.brd, powerblade_3v1.sch]
2015-04-30 finished routing except for antenna
    [powerblade_3v1.brd]
2015-04-30 added dimension for antenna keepout
    [powerblade_3v1.brd]
2015-05-02 well... i changed to the other type of debugging connctor. not done routing
    [powerblade_3v1.brd, powerblade_3v1.sch]
2015-05-04 removed led once and for all
    [powerblade_3v1.brd, powerblade_3v1.sch]
2015-05-05 finished routing supply in backwards
    [powerblade_3v1.brd, powerblade_3v1.sch]
2015-05-05 down to 9 airwires
    [powerblade_3v1.brd, powerblade_3v1.sch]
2015-05-05 finished airwires but still a few errors
    [powerblade_3v1.brd, powerblade_3v1.sch]
2015-05-05 updated board
    [powerblade_3v1.brd]
2015-05-05 changed tab to neck down
    [powerblade_3v1.brd, powerblade_3v1.sch]
2015-05-05 finished board. yay.
    [powerblade_3v1.brd]
2015-05-05 cleaned up silkscreen etc
    [powerblade_3v1.brd]
2015-05-07 finished powerblade design including outline on tab
    [powerblade_3v1.brd, powerblade_3v1.sch]
2015-05-07 added cam files for powerblade
2015-05-07 rounded corners
    [powerblade_3v1.brd, powerblade_3v1.sch]
2015-05-07 added vfilt to msp read and moved zc to TDO (comparator)
    [powerblade_3v1.brd, powerblade_3v1.sch]
2015-05-13 approved 4 errors in powerblade board
    [powerblade_3v1.brd]
2015-05-13 updated tc2050 to no-dim version since co-locating with tc2030 guide pins
    [powerblade_3v1.brd, powerblade_3v1.sch]
2015-05-15 changed to smaller tabs
    [powerblade_3v1.brd, powerblade_3v1.sch]
2015-05-15 changed ble control to pmos, rerouted all but one airwire
    [powerblade_3v1.brd, powerblade_3v1.sch]
2015-05-15 finished routing with 3v3 gate for ble
    [powerblade_3v1.brd, powerblade_3v1.sch]
2015-05-15 updated gerbers with 3v3 gate for ble
2015-05-15 added block M to powerblade
    [powerblade_3v1.brd]
2015-05-15 updated gerbers with block m in silkscreen
2015-05-18 changed visible layers in brd
    [powerblade_3v1.brd]
2015-05-20 added/fixed capacitor part numbers in powerblade
    [powerblade_3v1.brd, powerblade_3v1.sch]
2015-05-20 added part numbers for resistors in powerblade
    [powerblade_3v1.brd, powerblade_3v1.sch]
2015-05-21 added powerblade images for tiic
2015-05-21 rearranged pic in powerblade ble
    [powerblade_3v1.sch]
2015-05-21 added layer stackup model
    [05mil_adhesive.SLDPRT, 05mil_polyamide.SLDPRT, 08mil_adhesive.SLDPRT, 14mil_copper.SLDPRT, 1mil_lpi.SLDPRT, 1mil_polyamide.SLDPRT, 2mil_adhesive.SLDPRT, 6mil_fr4.SLDPRT]
2015-05-22 removed the extra line to nowhere on powerblade, re-sent the gerber to chadi
    [powerblade_3v1.brd]
2015-05-24 retouched layer stackup and added reproduced pngs
    [05mil_adhesive.SLDPRT, layer_stackup.SLDASM]
2015-05-24 moved data to ext
    [05mil_adhesive.SLDPRT, 05mil_polyamide.SLDPRT, 08mil_adhesive.SLDPRT, 14mil_copper.SLDPRT, 1mil_lpi.SLDPRT, 1mil_polyamide.SLDPRT, 2mil_adhesive.SLDPRT, 6mil_fr4.SLDPRT]
2015-05-24 removed metering
    [metering.csv, powerblade.csv]
2015-05-24 updated powerblade readme
2015-05-26 3v1 parts ordered
    [partList.xlsx, powerblade_3v1.csv]
2015-05-26 added nema spec to powerblade repo
2015-06-10 removed calibrate ct and calibrate raw projects - low power (main powerblade app) handles calibrate
2015-06-10 cleaned up powerblade low power app
2015-06-15 modified drc to produce dxf
    [powerblade_3v1.brd, powerblade_3v1.dxf]
2015-06-15 updated dxf for powerblade 3v1 stencil
    [powerblade_3v1.brd, powerblade_3v1.dxf]
2015-06-15 added correl draw powerblade file
2015-06-19 work in powerblade app
2015-06-22 added powerblade stencil
    [powerblade_3v1-bcream.dxf, powerblade_3v1-tcream.dxf, powerblade_3v1.dxf]
2015-06-22 added powerblade debug adapter
    [pb_debug.brd, pb_debug.sch]
2015-06-22 moved some pins in debug adapter
    [pb_debug.brd, pb_debug.sch]
2015-06-22 new powerblade boots, transmits packets
2015-06-23 powerblade board shows layers
    [powerblade_3v1.brd]
2015-06-23 new powerblade working, true power still reads zero
2015-06-26 edits to pb_debug board
    [pb_debug.brd]
2015-06-26 finished pb debug board
    [pb_debug.brd, pb_debug.sch]
2015-06-26 added gerbers for pb debug board
2015-06-28 corrected amplifier pn
    [powerblade_3v1.brd, powerblade_3v1.sch]
2015-06-28 created new inductor test file
    [inductor_test_1v0.brd, inductor_test_1v0.sch, inductor_test_2v0.brd, inductor_test_2v0.sch]
2015-06-29 added new amplifiers for inductor inspector
    [inductor_test_2v0.brd, inductor_test_2v0.sch]
2015-06-29 more work in inductor board
    [inductor_test_2v0.brd, inductor_test_2v0.sch]
2015-06-30 added new amplifier configuration
    [inductor_test_2v0.brd, inductor_test_2v0.sch]
2015-06-30 added all components for inductor inspector
    [inductor_test_2v0.brd, inductor_test_2v0.sch]
2015-06-30 all components added for inductor inspector
    [inductor_test_2v0.brd, inductor_test_2v0.sch]
2015-06-30 23 airwires left
    [inductor_test_2v0.brd, inductor_test_2v0.sch]
2015-06-30 finished basic design, about to add stuff!
    [inductor_test_2v0.brd]
2015-06-30 added pogo pin to inductor test board
    [inductor_test_2v0.brd, inductor_test_2v0.sch]
2015-07-01 changed supply width to 24
    [inductor_test_2v0.brd]
2015-07-01 added gerbers for inductor test
2015-07-01 cleaned up silkscreen
    [inductor_test_2v0.brd]
2015-07-01 added part numbers and values
    [inductor_test_2v0.brd, inductor_test_2v0.sch]
2015-07-02 finished adding part numbers for inductor test board
    [inductor_test_2v0.brd, inductor_test_2v0.sch]
2015-07-02 added inductor test csv
    [inductor_test_2v0.csv]
2015-07-02 added inductor test partslist
    [partList.xlsx]
2015-07-09 added inductor inspector test configurations
    [InductorTesting.xlsx]
2015-07-09 made initial sc offering
    [SC-BOM.xlsx, powerblade_3v1_centroid.csv]
2015-07-09 updated bom without repeats
    [SC-BOM.xlsx, powerblade_3v1_centroid.csv]
2015-07-09 added opa376 test
    [InductorTesting.xlsx]
2015-07-10 added initial testing results
    [TestingResults.xlsx]
2015-07-13 more inductor testing incl function generator testing
    [InductorTesting.xlsx, TestingResults.xlsx]
2015-07-15 finished inductor test results
    [Results.xlsx]
2015-07-15 added labels to figures
    [Results.xlsx]
2015-07-21 added ac3_f3 to powerfilm library
2015-07-21 archived powerblade 3v1
    [SC-BOM.xlsx, partList.xlsx, powerblade_3v1-bcream.dxf, powerblade_3v1-tcream.dxf, powerblade_3v1.brd, powerblade_3v1.csv, powerblade_3v1.dxf, powerblade_3v1.sch]
2015-07-21 made powerblade 3v2
    [powerblade_3v2.brd, powerblade_3v2.sch]
2015-07-21 updated powerblade 3v2 to include AC_F3
    [powerblade_3v2.brd, powerblade_3v2.sch]
2015-07-21 fixed and approved some errors in powerblade 3v2
    [powerblade_3v2.brd]
2015-07-21 updated R1210 footprint and pogo pad footprints
    [powerblade_3v2.brd, powerblade_3v2.sch]
2015-07-21 disconnected all but A.4 in F3
    [powerblade_3v2.brd, powerblade_3v2.sch]
2015-07-22 more routing on powerblade and moved Phase contact to top (position 3)
    [powerblade_3v2.brd, powerblade_3v2.sch]
2015-07-23 switched pins for vfilt and isense
    [powerblade_3v2.brd, powerblade_3v2.sch]
2015-07-23 more routing in new powerblade
    [powerblade_3v2.brd, powerblade_3v2.sch]
2015-07-23 added more data
    [Results_MoreData.xlsx]
2015-07-27 updated routing in powerblade
    [powerblade_3v2.brd]
2015-07-28 more routing and fixed errors
    [powerblade_3v2.brd, powerblade_3v2.sch]
2015-07-28 added t4 data
    [Results_MoreData.xlsx]
2015-07-28 finished moreData report
    [Results_MoreData.xlsx]
2015-07-29 updated most 0402 to new footprint
    [powerblade_3v2.brd, powerblade_3v2.sch]
2015-08-10 finished routing in powerblade incl vfilt
    [powerblade_3v2.brd, powerblade_3v2.sch]
2015-08-10 un-did testing changes in powerblade program
2015-08-10 added PA.1 to phase connection in AC_F3
    [powerblade_3v2.brd, powerblade_3v2.sch]
2015-08-10 changed calibrate so 'time' is the value overwritten with tx_i_ave
2015-08-11 finished design
    [powerblade_3v2.brd]
2015-08-12 moved calibrate data to calibrate folder
2015-08-12 minor changes in powerblade app
2015-08-12 modified process output script to work with apparent and true power
2015-08-12 adjusted phase correction in powrblade msp430 app
    [main.c, powerblade_test.h]
2015-08-12 added calibration and measurement data on PB3v1
    [Calib_and_Measure.xlsx]
2015-08-13 renamed measurement to measurement with offset on current
2015-08-13 applied offset correction to Irms rather than current
    [main.c]
2015-08-13 ran calib and meas on 1k resistor with offset applied to Irms
    [Calib_and_Measure.xlsx]
2015-08-13 changed scale in powerblade js app for 1k in amplifier
2015-08-14 updating the app to parse current powerblade ble advertisements. Changed the parsing logic a fair amount... Was running into issues with data loss which I hacked past through doing the bit flipping a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
2015-08-16 all parts in pb3v2 have part numbers
    [powerblade_3v2.brd, powerblade_3v2.sch]
2015-08-16 added pogo part number
    [powerblade_3v2.brd, powerblade_3v2.sch]
2015-08-16 added csv for pb3v2
    [powerblade_3v2.csv]
2015-08-16 added parts list for PB3v2
    [powerblade_3v2.xlsx]
2015-08-20 added scripts for adding gnd truth to pb measurements
2015-08-27 added temporary new measurement file
    [New_Measure.xlsx]
2015-08-27 changed offset to 27 (new value for 1k resistor) and replaced current offset to current (but fixed error in sign)
    [main.c, powerblade_test.h]
2015-08-27 added new unity data and start of other data to calib and measure
    [Calib_and_Measure.xlsx]
2015-08-27 finished calib and measure for household loads
    [Calib_and_Measure.xlsx, New_Measure.xlsx]
2015-08-27 added copy-able data fields in calib and measure
    [Calib_and_Measure.xlsx]
2015-08-27 added stdev to calib and measure
    [Calib_and_Measure.xlsx]
2015-08-28 minor edits to calib and measure
    [Calib_and_Measure.xlsx]
2015-08-28 Wireless measurement script
2015-08-29 packet count increment reduced to 2, single powerblade filter commented out
2015-09-02 minor edits in calib and measure - measuring r2 value of final calibration
    [Calib_and_Measure.xlsx]
2015-09-06 moved powerblade data for sensys paper to shed
    [Calib_and_Measure.xlsx]
2015-09-14 cleaned up powerblade code and shifted wh by 9 bits
2015-09-14 archived powerblade 3v2
    [powerblade_3v2.brd, powerblade_3v2.csv, powerblade_3v2.sch, powerblade_3v2.xlsx]
2015-09-14 added powerblade with plated cutouts
    [powerblade_3v2.brd, powerblade_3v2.sch]
2015-09-14 updated powerblade with pinch in on pogos
    [powerblade_3v2.brd, powerblade_3v2.sch]
2015-09-14 updated files for plated cutouts
    [powerblade_3v2.brd, powerblade_3v2.sch]
2015-09-15 added scaling values into powerblade
2015-09-15 added scaling recv into powerblade js app
2015-09-15 added thermals to N side AC3_F4 (plated) footprint)
    [powerblade_3v2.brd, powerblade_3v2.sch]
2015-09-15 pogo pin cutouts pinch in at prong
    [powerblade_3v2.brd, powerblade_3v2.sch]
2015-09-15 approved errors
    [powerblade_3v2.brd]
2015-09-21 updated l41
    [powerblade_3v2.brd, powerblade_3v2.sch]
2015-09-21 temporarily removed gerbers
2015-09-23 updated plating not around the whole cutout
    [powerblade_3v2.brd, powerblade_3v2.sch]
2015-10-06 added battery charger users guide
2015-10-06 updated powerblade 3v2 parts spreadsheet while assembling pogos
    [powerblade_3v2.xlsx]
2015-10-07 continued to thrash the ppowerblade 3v2 parts list for my own purposes (assembling 3v2)
    [powerblade_3v2.xlsx]
2015-10-07 properly versioned most recent powerblade
    [powerblade_3v3.brd, powerblade_3v3.sch]
2015-10-09 add favicon to powerblade summon app
2015-10-09 done calibrating for terraswarm
2015-10-09 calibration works again
2015-10-10 Displays eddystone receptions from powerblade
2015-10-13 updated but not tested app... parsing code taken from powerblade node app
2015-10-13 updated board? I hope i dont get conflicts
    [powerblade_3v2.brd, powerblade_3v2.sch]
2015-10-13 added powerblade bom and centroid for assembly
    [powerblade_3v3_bom.csv, powerblade_3v3_bom.xlsx, powerblade_3v3_centroid.csv]
2015-10-13 updated distributor in screaming circuits bom
    [powerblade_3v3_bom.xlsx]
2015-10-14 Reversing the bits; Vrms right, power scale seems wrong
2015-10-21 added system solidworks model
    [full_system.SLDASM, mill-max-0965-0-15-20-80-14-11-0.sldasm, mill-max-0965-0-15-20-80-14-11-0_6880-0-00-00-80-XX-43-1C(6880-0-00-00-80-14-43-1).sldprt, mill-max-0965-0-15-20-80-14-11-0_6995-0(6995-0-02-20-00-00-13-0).sldprt, mill-max-0965-0-15-20-80-14-11-0_9305-0(9305-0-00-20-00-00-13-0).sldprt, mill-max-0965-0-15-20-80-14-11-0_9318-0(9318-0-00-20-00-00-13-0).sldprt, pcb_with_components.SLDPRT, 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]
2015-10-21 added two more fields - uart length and ad length
2015-10-21 Updated scripts to fix byte and bit ordering
    [calibrate_ct.js, calibrate_raw.js, powerblade_data.js]
2015-10-22 Updated app to PowerBlade version 1
2015-10-22 Powerblade linkable from Summon & new release apk
2015-10-27 added a version 33 fflag and changed adc ordering
2015-10-27 changed full system image
    [full_system.SLDASM]
2015-12-01 added 1430 based powerblade
    [powerblade1430_1v0.brd, powerblade1430_1v0.sch]
2015-12-04 nrf51 app for powerblade using sdk10
    Ported from squall/apps/powerblade
2015-12-04 UART protocol change
    nRF accepts arbitrary length UART data
2015-12-04 Bringing back powerblade_data file for debugging
2015-12-07 added exponential back to powerblade_data.js
2015-12-07 updated powerblade thing to use exponential
2015-12-08 working with PSCALE to calibrate for SRI
2015-12-08 updated powerblade_adv
2015-12-08 removed exponential from powerblade_data and added apparent power to process_output
2015-12-09 changed the way CUROFF is applied to current
2015-12-10 Just watt hours
    Copied over from my previous mistake in powerblade_adv.js
2015-12-10 enabled UART RX in uart_enable function
2015-12-10 New repos for old adv-only and new powerblade apps
    Also, fixed .gitignore so I now commit my makefiles
    Updated nrf5x-base
    [ble_config.h, main.c]
2015-12-10 changed uart to 115200
2015-12-10 cleaned up new uart code
2015-12-10 Checksumming and UART Tx to MSP430
    This is still test code in progress of cleanup
2015-12-11 Code cleanup
    Moved uart driver functions out of main.c
    Added '--all' option to tell powerblade_adv.js to not deduplicate data
2015-12-11 First pass at a calibration service
2015-12-11 significant clean up in powerblade main.c
2015-12-11 more cleanup in powerblade code
2015-12-11 cleaned up the adc section in powerblade a lot
2015-12-11 finished cleaning up adc ordering code
2015-12-11 moved uart to its own file
2015-12-13 rough start to build powerblade directions
2015-12-14 Documenting PowerBlade protocols
2015-12-14 fixed ADC ordering issues
    [main.c, powerblade_test.h]
2015-12-14 added field to uart protocol spec
2015-12-14 switched to async (not in interrupt) calculation and transmission
2015-12-14 updated uart protocol
2015-12-14 updated uart protocol fields
2015-12-14 added uart types header file
2015-12-14 added variable uart length to send and uart interrupt
2015-12-14 started basic uart state machine in msp430
2015-12-14 starting to implement uart state machine
2015-12-16 Raw sample collection service
    Sends uart command to MSP430 to request raw ADC samples of voltage and
    current. Data is passed to the nRF which makes it available over the
    service in 504-byte chunks.
    Code not yet tested with an MSP430, but the BLE side seems to work
2015-12-16 Bug fix for vlen characteristic
    Also lots of debug
    [main.c]
2015-12-17 Start of script to collect raw sample data
    Also documented steps to collect raw sample data
    Added better status signalling to code
2015-12-17 added offset option to uart send function
2015-12-17 fixed error in data stuffing
    [main.c]
2015-12-17 fixed error where only stufing first half of txbuf
    [main.c]
2015-12-18 Working raw sample downloads
    Not 100% successful, but works most of the time
2016-01-11 Use Michigan Company ID and PowerBlade Service ID
    Changes Company ID to 0x02E0 (previously using 0x4908)
    Add a Service ID of 0x11 as first byte of Manufacturer Specific Data to
    disambiguate between PowerBlade and other Michigan BLE devices
    Update various scripts to handle new format (and still work with old
    format)
2016-01-12 Added image of powerblade
2016-01-13 add powerblade logos
2016-01-13 Update PowerBlade to new simple_ble API
    working on api_change branch of nrf5x-base for now
2016-01-14 updated service uuid in collect raw samples
2016-01-14 updated the uart protocol to include ioff and voff
2016-01-15 added calibrate based on samples js script
2016-01-15 Added service for device configuration
    Changed uart_types.h based on needed uart commands
    Service can read/write various MSP430 calibration values
    Serivce also provides read/notify access to nRF status codes (for
    errors)
    Updated various documentation files
    [main.c, powerblade_states.h, uart_types.h]
2016-01-18 changed hard coded length in powerblade samples script
2016-01-18 added crude voff and ioff currently as constants
2016-01-20 minor updates in powerblade_test.h getting ready for switch to calibraiton procedure
2016-01-20 removed calibrate flags from powerblade code
2016-01-20 switched to using pb config structure for scaling values
2016-01-20 fixed minor error in curoff impl
    [main.c]
2016-01-20 fixed minor error - extra space on curoff line in main.c
    [main.c]
2016-01-20 minor fix to make get conf work
    [main.c, uart.c, uart.h]
2016-01-20 fixed recovering from power crash problem
    [powerblade_test.h]
2016-01-25 added all raw sample data into single array
2016-01-25 plummed through to calibrate_samples but not yet working for calc
2016-01-25 Updated Readme to newest powerblade model
2016-01-26 fixed two minor bugs in main - incorrect indexing into data array and subtracting curoff
    [main.c]
2016-01-26 calibrate samples script now works correctly
2016-01-26 'fixed' startup timing issue by simply getting rid of the old solution of using a timer to wait
    [main.c]
2016-01-27 wattage input to collect raw samples script
2016-01-27 cleaned up the adc timer trigger in pb
2016-01-28 better low power code at startup - faster start
2016-01-28 Reduced number of power resets during connections
    UART transmissions are disabled when connections start and during large
    characteristic reads
    Advertisements are disabled when connections start and re-enabled later
    [main.c, powerblade_states.h]
2016-01-30 Calibration writes values back to PowerBlade
2016-01-30 Moved rawSample to Calibration
    That's what it does now
2016-01-31 Returning raw sample collection scripts
    Could still be useful apart from calibration purposes
2016-02-03 Power draw improvements during a connection
    Fixed a UART timing bug
    Turned off advertising during long uart reads
    Disable UART for two cycles when an initial connection begins
    Updated to 9600 baud to support MSP430 sleep mode
    [main.c, uart.c]
2016-02-04 uart code stabilized but messy
    [main.c, powerblade_test.h, uart.c, uart.h]
2016-02-04 fixed minor bug in main.c
    [main.c]
2016-02-04 better handled zero power
2016-02-04 fixed error where pscale wasnt being applied
    [main.c]
2016-02-04 changed default calibration n values to -1 -1 428A
2016-02-04 Calibration script writes correctly sized values
2016-02-04 Write V_scale and WH_scale during calibration
2016-02-04 flags is now an indicator of calibration - high order bit
2016-02-04 added check in adv for calibration
2016-02-05 10 bit stable but not with calibration
2016-02-06 calibrate samples works with 10 bit adc (16 bit samples)
2016-02-06 minor changes to finish getting 10 bit adc working
2016-02-07 tried re-add backwards compatibility
    for currently deployed power blades
2016-02-10 added single source option for powerblade adv
2016-02-11 updated powerblade_adv with new pscale calc - / 200
2016-02-11 added voltage calibration to calibrate.js and changes in calibrate_samples to finish supporting 10 bit adc
2016-02-11 finished working with 10b adc incl incrementing pb id for new vscale calculation
2016-02-11 added plug width evaluation data
    [PlugWidthEvaluation.xlsx]
2016-02-12 added data from sams house
    [PlugWidthEvaluation.xlsx]
2016-02-12 updated plug evaluation
    [PlugWidthEvaluation.xlsx]
2016-02-12 Added plug measurements from 1929 Plymouth
    [PlugWidthEvaluation.xlsx]
2016-02-15 minor update in plug width spreadsheet
    [PlugWidthEvaluation.xlsx]
2016-02-17 minor update in plug width
    [PlugWidthEvaluation.xlsx]
2016-02-17 added leland data to plug width
    [PlugWidthEvaluation.xlsx]
2016-02-17 minor change in plug width
    [PlugWidthEvaluation.xlsx]
2016-02-18 Update scripts to handle PowerBlade version 2
2016-02-19 OS-independent Summon for PowerBlade
    not tested on ios yet
    bluetooth.js is a shim making ios and android advertisement data
    equivalent. The file is copied from summon/examples/cordova-apps and is
    still in a state of flux. Needs to be cleaned up for sure
2016-02-22 changed v5 of AC3 to be .366
    [PlugWidthEvaluation.xlsx]
2016-02-22 added final v5 part (package) and inputted into powerblade
    [powerblade_3v3.brd, powerblade_3v3.sch]
2016-02-23 updated version number in boards and changed a part number in excel
    [powerblade_3v3_bom.xlsx, powerblade_3v4.brd, powerblade_3v4.sch]
2016-02-23 recovered and archived v3.3
    [powerblade_3v3.brd, powerblade_3v3.sch]
2016-02-26 added 16 second watchdog timer to powerblade msp
2016-02-26 added reset watt hours and get software version uart commands
2016-02-26 added reset watt hours and get msp version number
    [main.c, uart_types.h]
2016-02-29 powerblade throws out partial message at bookend if received more than 1 second ago
2016-03-02 started v 4v0
    [powerblade_4v0.brd, powerblade_4v0.sch]
2016-03-10 entire path on one line and lengthened print delay
2016-03-10 Parse script with de-duplication
2016-03-10 Cleanup devices
2016-03-10 Debugging print outs
2016-03-10 Need to get device id correctly
2016-03-15 log and bulk log essentially ready
    [blees_light_lookup.csv]
2016-03-15 parsing powerblade done
2016-03-15 added more status printouts for gateway sql
2016-03-15 removed unecessaryconnections and fixed ordering in seq and voltage
2016-03-16 added counts to done writing printouts
2016-03-16 specified fields to insert in gateway scripts
2016-03-18 added basic data script for powerblade data run with -h for help
    [blees_light_lookup.csv]
2016-03-18 changed default device and added more prints
2016-03-18 added ability to comment out in the device list and added an end date but it doesnt quite work
2016-03-21 fixed empty file check for devices (sum was already working)
2016-03-26 Model for BLE advertisement collisions
    Handles varied advertising intervals, transmission lengths, intervals
    for new data, and transmissions of eddystone packets
    Set to model Sam's apartment:
    * 17 BLEES
    * 19 PowerBlades
2016-03-28 removed plug width eval
    [PlugWidthEvaluation.xlsx]
2016-03-31 small change
    [PlugWidthEvaluation.xlsx]
2016-04-03 WiFi scanner for powerblade deployment
2016-04-04 changed ignore to not ignore deviceList
2016-04-04 removed agg devices from device list
2016-04-06 added recent power to update table
2016-04-06 added shortmac to recent power
2016-04-08 devicelist being used for sensys 16
2016-04-18 cleaned up powerblade repo
    [full_system.SLDASM, mill-max-0965-0-15-20-80-14-11-0.sldasm, mill-max-0965-0-15-20-80-14-11-0_6880-0-00-00-80-XX-43-1C(6880-0-00-00-80-14-43-1).sldprt, mill-max-0965-0-15-20-80-14-11-0_6995-0(6995-0-02-20-00-00-13-0).sldprt, mill-max-0965-0-15-20-80-14-11-0_9305-0(9305-0-00-20-00-00-13-0).sldprt, mill-max-0965-0-15-20-80-14-11-0_9318-0(9318-0-00-20-00-00-13-0).sldprt, pcb_with_components.SLDPRT, 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]
2016-04-22 added local calibration code
2016-04-27 added local calibration options to uart protocol
2016-04-27 updated example in uart protocol
2016-04-28 added next msp software version (2) for local calibration
2016-04-28 removed option to reset WH - will add save points later
    [main.c]
2016-04-28 updated set seq and reset WH to be depreciated functions in uart protocol
2016-05-05 New features for PowerBlade
    * Internal calibration service
    * Ability to clear cumulative watt hours measurement
    * Persistent sequence number across reboots
    * Beginning of a framework for reporting version numbers
    [main.c, powerblade_states.h]
2016-05-13 New calibration script (untested)
2016-05-13 Bad UUID for calibration service
2016-05-23 local calibration basically works
2016-05-23 added voltage to local calib
2016-05-31 added distinction between wireless and local calibration in powerblade_adv
2016-06-06 elevated sql folder
    [blees_light_lookup.csv]
2016-06-29 added flags to parse.js for powerblade
2016-07-02 change to new eddystone url
    uses the commit
    https://github.com/lab11/powerblade/tree/a6714490f24d7183797d4299cbb318e43b74bdd5
    and the raw git cdn
2016-07-08 low power project now generates hex file
2016-07-11 Added explanation of how to flash powerblades
2016-07-13 fixed error where powerblade measures 0 when applied backwards
    [main.c]
2016-07-14 removed debugging header in 3v5
    [powerblade_3v5.brd, powerblade_3v5.sch]
2016-07-14 cleaned up after removing header
    [powerblade_3v5.brd, powerblade_3v5.sch]
2016-07-14 moved capacitors and updated antenna
    [powerblade_3v5.brd, powerblade_3v5.sch]
2016-07-14 vias smaller
    [powerblade_3v5.brd]
2016-07-14 removed a lot of gaps in stop mask on bottom
    [powerblade_3v5.brd, powerblade_3v5.sch]
2016-07-14 updated crystal
    [powerblade_3v5.brd, powerblade_3v5.sch]
2016-07-14 added new plated cutout variant with soldermask and plating all the way around
2016-07-14 updated powerblade to use new cutouts
    [powerblade_3v5.brd, powerblade_3v5.sch]
2016-07-14 added powerblade 3v5 bom
    [powerblade_3v5_bom.xlsx]
2016-07-14 final cleanup
    [powerblade_3v5.brd]
2016-07-15 removed reverse polarity fix
    [main.c]
2016-07-18 removed random trace on bottom of board
    [powerblade_3v5.brd]
2016-07-18 updated gerbers
2016-09-13 ready for new sql interaction
    [blees_light_lookup.csv]
2016-10-14 moved back to powerblade away from pb_2
2016-10-18 fixed error in adding msp software version to flags
    [main.c]
2016-10-18 added flags to powerblade adv listener
2016-11-17 moved conv data (plotting for powerblade accuracy issue) to powerblade repo
    [PowerBlade_Variance.xlsx]
2016-11-21 prep work for extended measurements
    [PowerBlade_Variance.xlsx, PowerBlade_Variance_Full.xlsx]
2016-11-28 updated and fixed errors
    [data_check.js, measurements.js]
2016-11-29 fixed errors with watts up script printing
    [wattsup.py]
2016-11-29 data check works with missing and clear features
    [data_check.js]
2016-11-30 cleaned up printout in datacheck
2016-12-06 data printing almost done for sorted maxdiff measurements
2016-12-07 added location to powerblade status
2016-12-08 switched to node-cron
2016-12-12 started to support voltage
2016-12-12 wattsup script can replace the file
    [wattsup.py]
2016-12-12 data check no longer proceeds if there are missing elements
    [data_check.js]
2016-12-12 measurements can replace file now
    [measurements.js]
2016-12-12 specify device seperately in measurements
2016-12-12 option to replace or overwrite in measurements
    [measurements.js]
2016-12-14 moved data to shed-data
    [PowerBlade_Variance.xlsx, PowerBlade_Variance_Full.xlsx]
2016-12-15 added voltage to data check
2016-12-22 added location to powerblade lookup upload
2017-01-04 calibrate restarts under certain error conditions
2017-01-04 cleaned up the print statements in calibrate
2017-01-06 changed the way calibrate works with inputs
2017-01-07 calibrate works kinda with the load measurement
2017-02-07 Added check for device id
2017-02-10 calibrate uses new config for -s option
2017-02-11 added check if power is in right bound
2017-02-12 fixed errors with device id in commission and added more printouts in calibrate
2017-03-08 devices and locations work for the plotter
2017-03-11 better printing
2017-03-11 no longer printing ok
2017-03-11 final edit - devices no longer print ok
2017-03-11 changing a lot about printing
2017-03-11 dont print the ok symbol
2017-03-13 bless and ligeiro print all
2017-03-22 added plt printout to plot file
2017-03-23 power plotting downsampled and using devPower index
2017-03-25 switched to active list
2017-03-25 added gnd truth table
2017-03-25 added gnd truth and locations to plot data
2017-03-26 switched to printEnergy format and added combine script
2017-03-30 added final gnd table and mr view
2017-04-03 fixed duration days and added more columns to final gnd truth
2017-04-03 fixed error dividing by number of days for non-perm devices
2017-04-20 fixed time issue with printing
2017-04-25 currently set up for 5,6
2017-04-25 added 4-part index on dev power time seq
2017-04-25 added room to valid devices, and added mr_dat_delta view
2017-04-25 switched from valid_devices_2
2017-04-27 cleaned up device ID
2017-05-12 added path support for plotconfig and started to add inter-device correlation
2017-05-15 testweka app pretty much works for testing all the combinations for device id
2017-05-15 finished massive change to device id - small datasets only few on fewcats categories
2017-05-16 added latex-style table printout to testweka
2017-05-18 added the subtraction of minval for certain things to better track device activity
2017-05-19 added inter device correlation
2017-05-20 reverted inter device for id and added fewcats_mac table
2017-06-05 better device category stuff
2018-07-28 Script to download Voltage and Current samples
    Super manual at this point, with calibration parameters hardcoded in the
    `collect_samples.js` file.
2018-12-14 add better assembly files
2018-12-17 add sample collection readme
2019-01-15 Update sample collection script
2019-01-25 Add script that writes powerblade data to file
    The base of the script is written by Anand that writes the data to an
    influx database.
2019-01-25 Add 'wait for keypress' to sample collection
2019-05-14 Fix big endian printing bug for curoff, pscale
